Le-Dome-RDS/hope-bike/mecanic_and_wiring/V2/capteur_roue/bicycle+wheel+magnet+valve+cap+for+cycle+computer+sensor/images/IMG_20170719_185834156_-_copia.jpg

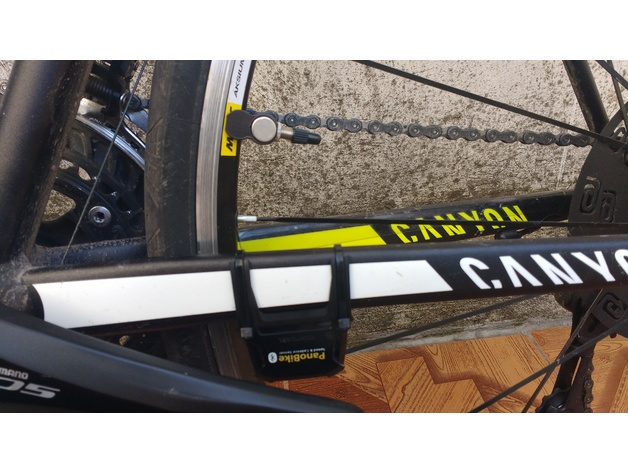
mecanic_and_wiring/V2/capteur_roue/bicycle+wheel+magnet+valve+cap+for+cycle+computer+sensor/images/IMG_20170719_185834156_-_copia.jpg
