Le-Dome-RDS/hope-bike/README.md

# hope-bike
An open source Pedalling Assistant Sytem for 26" wheeled bikes 

Licence : CC-BY-SA
