Le-Dome-RDS/hope-bike/source_code/readme.md

#Source code for the Hope and Bike project

This folder contains the source code for the command card and the power management card. 

Details for dwownloading software are given in each cases.
