Le-Dome-RDS/hope-bike/electronic parts/readme.md

#Electronic parts

This folder contains datasheet, eagle project and schematic for the three different PCB files : 

* the button card that contains the three buttons used for the control of the speed by the user,
* the command card that contains LEDs used to visualize both the battery level and the speed assist level. It also contains the arduino board.
*  the power management card that contains all the power electronic stuff necessary to drive the brushless motor using the electrical power battery.

The datasheets for the electronical devices used in the cards and the commercial items required for the kit (battery, motor and the pedal sensor) are also avalaible
