Le-Dome-RDS/hope-bike/electronic parts/datasheet_moteur_batterie_etc/readme.md

# datasheet for motor, battery and other commercial devices needed for the Kit

pdf files are provided for the battery, the brushless motor and the pedal sensor. For the cases where the pdf files are printed version of web pages, follow the links below  : 

* Brushless motor and wheel : chinese ref. cheaper  [http://www.cccme.org.cn/products/detail-8074730.aspx](http://)

*  Brushless motor and wheel : french provider [http://www.power-e-bike.fr/](http://)
*  Pedal sensor : [http://www.power-e-bike.fr/fr/accessoires-velo-electrique/capteur-de-pedalage.html](http://)
