Le-Dome-RDS/hope-bike/electronic parts/2015.06.08_BOM_Francois_Auguste.ods

1nf céramique 0805 | 100 | 0,0122 | 1,22 € | http://fr.farnell.com/multicomp/mcsh21b102k250ct/condensateur-mlcc-x7r-1nf-25v/dp/1856454
220µF 50V CMS | 4 | 1,0200 | 4,08 € | http://fr.farnell.com/panasonic-electronic-components/eeeft1h221ap/condensateur-elec-alu-220uf-50v/dp/1868427
680µF 10V CMS | 10 | 0,8490 | 8,49 € | http://fr.farnell.com/panasonic-electronic-components/eeefp1a681ap/condensateur-elec-alu-680uf-10v/dp/1539506
10µF 50V Cms | 50 | 0,2020 | 10,10 € | http://fr.farnell.com/panasonic-electronic-components/eeefth100uar/condensateur-elec-alu-10uf-50v/dp/1868422
Diode zener 12V SOD123 | 5 | 0,1840 | 0,92 € | http://fr.farnell.com/multicomp/bzt52c12/diode-zener-0-41w-sod-123/dp/1466559
Diode BAS70-04 SOT23 | 25 | 0,0650 | 1,63 € | http://fr.farnell.com/vishay-semiconductor/bas70-04-e3-08/diode-petit-signal-70v-sot23-3/dp/2420635
Diode verste CMS 0805 | 20 | 0,0889 | 1,78 € | http://fr.farnell.com/kingbright/kpt-2012sgc/led-vert-0805-cms/dp/2099239
Résistance 100 CMS 0805 | 50 | 0,0236 | 1,18 € | http://fr.farnell.com/bourns/cr0805-jw-101elf/resistance-couche-epaisse-100r/dp/2333586
Résistance 1K CMS 0805 | 50 | 0,0653 | 3,27 € | http://fr.farnell.com/welwyn/wcr0805-1k0fi/resistance-0805-1k/dp/1099800
Résistance 2,2K CMS 0805 | 50 | 0,0236 | 1,18 € | http://fr.farnell.com/bourns/cr0805-jw-222elf/resistance-couche-epaisse-2-2k/dp/2333608
Résistance 10K CMS 0805 | 50 | 0,0229 | 1,15 € | http://fr.farnell.com/panasonic-electronic-components/erj6geyj103v/resistance-0805-10k-5-0-125w/dp/2057719
Résistance 56K CMS 0805 | 50 | 0,0243 | 1,22 € | http://fr.farnell.com/yageo-phycomp/rc0805jr-0756kl/resistance-rc11-0805-56k/dp/9234225
Résistance 82K CMS 0805 | 10 | 0,0150 | 0,15 € | http://fr.farnell.com/te-connectivity/crgh0805j82k/resistance-puissance-82k-0-33w/dp/2331821
Régulateur 5V SOT89 | 10 | 0,2180 | 2,18 € | http://fr.farnell.com/stmicroelectronics/l78l05abutr/regulateur-5v-cms/dp/1467762
Régulateur 12V SOT89 | 5 | 0,3680 | 1,84 € | http://fr.farnell.com/stmicroelectronics/l78l12acutr/ic-reg-ldo-12v-100ma-sot89/dp/1564315
Quartz 16Mhz CMS | 2 | 1,5800 | 3,16 € | http://fr.farnell.com/txc/7m-16-000maaj-t/xtal-16-000mhz-18pf-smd-3-2x2/dp/1842060
Résistance 1206 0Ohm | 50 | 0,0250 | 1,25 € | http://fr.farnell.com/vishay-draloric/crcw12060000z0ea/resistance-0r-0-25w-jumper-1206/dp/1469963
Résistance 6,8 CMS 1206 | 10 | 0,0690 | 0,69 € | http://fr.farnell.com/panasonic-electronic-components/erjt08j6r8v/resistance-anti-impulsion-1206/dp/1577462
Diode CD1206-S01575 | 10 | 0,0718 | 0,72 € | http://fr.farnell.com/bourns/cd1206-s01575/diode-commutation-100v-150ma-1206/dp/2211947
4,7µF 25V 1206 | 10 | 0,0628 | 0,63 € | http://fr.farnell.com/multicomp/mc1206f475z250ct/condensateur-mlcc5v-4-7uf-25v-1206/dp/1759452
FAN73933MX DRIVER | 3 | 1,8300 | 5,49 € | http://fr.farnell.com/fairchild-semiconductor/fan73933mx/driver-gate-half-bridge-3a-14sop/dp/2083878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
 |  |  | 52,30 €
