Le-Dome-RDS/hope-bike/electronic parts/datasheet_composants_electronique/IRF MosFET N.xls

Part | Part Status | Package | VBRDSS (V) | VGs Max (V) | Circuit | RDS(on) Max 10V (mOhms) | Qg Typ (nC) | ID @ TC = 25C (A) | Power Dissipation @ TC = 25C (W) | Rth(JC) (K/W) | Qual Level | MSL
IRF7483M | Active and Preferred | DirectFET MF | 40 | 20 | Discrete | 2.3 | 81 | 135 | 74 | 1.7 | Industrial | 1
IRFR7740 | Active and Preferred | D-PAK | 75 | 20 | Discrete | 7.2 | 84 | 87 | 140 | 1.05 | Industrial | 1
IRFU7740 | Active and Preferred | I-PAK | 75 | 20 | Discrete | 7.2 | 84 | 87 | 140 | 1.05 | Industrial
IRFB7787 | Active and Preferred | TO-220AB | 75 | 20 | Discrete | 8.4 | 73 | 76 | 125 | 1.2 | Industrial
IRFS7787 | Active and Preferred | D2-Pak | 75 | 20 | Discrete | 8.4 | 73 | 76 | 125 | 1.2 | Industrial | 1
IRFSL7787 | Active and Preferred | TO-262 | 75 | 20 | Discrete | 8.4 | 73 | 76 | 125 | 1.2 | Industrial
IRFSL7762 | Active and Preferred | TO-262 | 75 | 20 | Discrete | 6.7 | 85 | 85 | 140 | 1.05 | Industrial
IRFS7762 | Active and Preferred | D2-Pak | 75 | 20 | Discrete | 6.7 | 85 | 85 | 140 | 1.05 | Industrial | 1
IRFR7746 | Active and Preferred | D-PAK | 75 | 20 | Discrete | 11.2 | 59 | 59 | 99 | 1.52 | Industrial | 1
IRFU7746 | Active and Preferred | I-PAK | 75 | 20 | Discrete | 11.2 | 59 | 42 | 99 | 1.52 | Industrial
IRFS7734-7P | Active and Preferred | D2-Pak 7-Lead | 75 | 20 | Discrete | 3.05 | 180 | 197 | 294 | 0.51 | Industrial | 1
IRFB7740 | Active and Preferred | TO-220AB | 75 | 20 | Discrete | 7.3 | 81 | 87 | 143 | 1.05 | Industrial
IRFS7734 | Active and Preferred | D2-Pak | 75 | 20 | Discrete | 3.5 | 180 | 183 | 290 | 0.51 | Industrial | 1
IRFH7787 | Active and Preferred | PQFN 5 x 6 B/E | 75 | 20 | Discrete | 8 | 75 | 68 | 83 | 1.5 | Industrial | 1
IRFP7718 | Active and Preferred | TO-247AC | 75 | 20 | Discrete | 1.8 | 552 | 355 | 517 | 0.29 | Industrial
IRFS7730 | Active and Preferred | D2-Pak | 75 | 20 | Discrete | 2.6 | 271 | 246 | 375 | 0.4 | Industrial | 1
IRFB7730 | Active and Preferred | TO-220AB | 75 | 20 | Discrete | 2.6 | 271 | 246 | 375 | 0.4 | Industrial
IRFB7734 | Active and Preferred | TO-220AB | 75 | 20 | Discrete | 3.5 | 180 | 183 | 290 | 0.51 | Industrial
IRFS7730-7P | Active and Preferred | D2-Pak 7-Lead | 75 | 20 | Discrete | 2 | 285 | 269 | 375 | 0.4 | Industrial | 1
IRFSL7730 | Active and Preferred | TO-262 | 75 | 20 | Discrete | 2.6 | 271 | 246 | 375 | 0.4 | Industrial
IRFSL7734 | Active and Preferred | TO-262 | 75 | 20 | Discrete | 3.5 | 180 | 183 | 290 | 0.51 | Industrial
IRFB7746 | Active and Preferred | TO-220AB | 75 | 20 | Discrete | 10.6 | 55 | 59 | 99 | 1.52 | Industrial
IRFI7446GPBF | Active | TO-220 FullPak (Iso) | 40 | 20 | Discrete | 3.3 | 60 | 80 | 40.5 | 3.7 | Industrial
IRFI7440GPBF | Active | TO-220 FullPak (Iso) | 40 | 20 | Discrete | 2.5 | 88 | 95 | 42 | 3.6 | Industrial
IRFH7085 | Active and Preferred | PQFN 5 x 6 B/E | 60 | 20 | Discrete | 3.2 | 110.0 | 147 |  | 0.80 | Industrial | 1
IRF7480M | Active and Preferred | DirectFET ME | 40 | 20 | Discrete | 1.2 | 123.0 | 217 | 96 | 1.3 | Industrial | 1
IRFR7540 | Active and Preferred | D-Pak | 60 | 20 | Discrete | 4.8 | 86 | 110 | 140 | 1.05 | Industrial | 1
IRFU7546 | Active and Preferred | I-Pak | 60 | 20 | Discrete | 7.9 | 58 | 71 | 99 | 1.52 | Industrial
IRFU7540 | Active and Preferred | I-Pak | 60 | 20 | Discrete | 4.8 | 86 | 110 | 140 | 1.05 | Industrial
IRFR7546 | Active and Preferred | D-Pak | 60 | 20 | Discrete | 7.9 | 58 | 71 | 99 | 1.52 | Industrial | 1
IRFH7545 | Active and Preferred | PQFN 5 x 6 B/E | 60 | 20 | Discrete | 5.2 | 73 | 85 | 83 | 1.5 | Industrial | 1
IRF7580M | Active and Preferred | DirectFET ME | 60 | 20 | Discrete | 3.6 | 120.0 | 116 | 115 | 1.3 | Industrial | 3
IRFS7430 | Active and Preferred | D2-Pak | 40 | 20 | Discrete | 1.3 | 300.0 | 409 | 375 | 0.40 | Industrial | 1
IRFR2905Z | Active | D-Pak | 55 | 20 | Discrete | 14.5 | 29.0 | 59 | 110 | 1.38 | Industrial | 1
IRFB7545 | Active and Preferred | TO-220AB | 60 | 20 | Discrete | 5.9 | 75.0 | 95 | 125 | 1.21 | Industrial
IRFS7540 | Active and Preferred | D2-Pak | 60 | 20 | Discrete | 5.1 | 88.0 | 110 | 160 | 0.95 | Industrial | 1
IRFSL7540 | Active and Preferred | TO-262 | 60 | 20 | Discrete | 5.1 | 88.0 | 110 | 160 | 0.95 | Industrial
IRFB7546 | Active and Preferred | TO-220AB | 60 | 20 | Discrete | 7.3 | 58.0 | 53 | 99 | 1.52 | Industrial
IRFB7540 | Active and Preferred | TO-220AB | 60 | 20 | Discrete | 5.1 | 88.0 | 110 | 160 | 0.95 | Industrial
IRFP7537 | Active and Preferred | TO-247AC | 60 | 20 | Discrete | 3.3 | 142.0 | 172 | 230 | 0.66 | Industrial
IRFP7530 | Active and Preferred | TO-247 | 60 | 20 | Discrete | 2.0 | 274.0 | 281 | 341 | 0.44 | Industrial
IRFS7530-7P | Active and Preferred | D2-Pak 7-Lead | 60 | 20 | Discrete | 1.4 | 236.0 | 240 | 375 | 0.40 | Industrial | 1
IRFS7534 | Active and Preferred | D2-Pak | 60 | 20 | Discrete | 2.4 | 186.0 | 195 | 294 | 0.51 | Industrial | 1
IRFS7537 | Active and Preferred | D2-Pak | 60 | 20 | Discrete | 3.3 | 142.0 | 173 | 230 | 0.65 | Industrial | 1
IRFB7534 | Active and Preferred | TO-220AB | 60 | 20 | Discrete | 2.4 | 186.0 | 195 | 294 | 0.51 | Industrial
IRFS7534-7P | Active and Preferred | D2-Pak 7-Lead | 60 | 20 | Discrete | 1.95 | 200.0 | 240 | 290 | 0.51 | Industrial | 1
IRFSL7534 | Active and Preferred | TO-262 | 60 | 20 | Discrete | 2.4 | 186.0 | 195 | 294 | 0.51 | Industrial
IRFB7537 | Active and Preferred | TO-220AB | 60 | 20 | Discrete | 3.3 | 142.0 | 173 | 230 | 0.65 | Industrial
IRFSL7537 | Active and Preferred | TO-262 | 60 | 20 | Discrete | 3.3 | 142.0 | 173 | 230 | 0.65 | Industrial
IRFSL7530 | Active and Preferred | TO-262 | 60 | 20 | Discrete | 2.0 | 274.0 | 295 | 375 | 0.40 | Industrial
IRFS7530 | Active and Preferred | D2-Pak | 60 | 20 | Discrete | 2.0 | 274.0 | 295 | 375 | 0.40 | Industrial | 1
IRFB7530 | Active and Preferred | TO-220AB | 60 | 20 | Discrete | 2.0 | 274.0 | 295 | 375 | 0.40 | Industrial
IRFS7430-7P | Active and Preferred | D2-Pak 7-Lead | 40 | 20 | Discrete | 0.75 | 305.0 | 522 | 3.75 | 0.40 | Industrial | 1
IRFS7434 | Active and Preferred | D2-Pak | 40 | 20 | Discrete | 1.6 | 216.0 | 320 | 294 | 0.50 | Industrial | 1
IRFSL7434 | Active and Preferred | TO-262 | 40 | 20 | Discrete | 1.6 | 216.0 | 320 | 294 | 0.50 | Industrial
IRF7478PBF-1 | Active | SO-8 | 60 | 20 | Discrete | 26.0 | 21.0 |  |  | 50 (JA) | Industrial | 1
IRFH7084 | Active and Preferred | PQFN 5 x 6 B/E | 40 | 20 | Discrete | 1.25 | 127.0 | 265 |  | 0.80 | Industrial | 1
IRFP3006 | Active and Preferred | TO-247AC | 60 | 20 | Discrete | 2.5 | 200.0 | 270 | 375 | 0.40 | Industrial
IRL1404ZS | Active and Preferred | D2-Pak | 40 | 16 | Discrete | 3.1 | 75.0 | 200 | 230 | 0.65 | Industrial | 1
IRFS7434-7P | Active and Preferred | D2-Pak 7-Lead | 40 | 20 | Discrete | 1.0 | 210.0 | 362 | 245 | 0.51 | Industrial | 1
IRFR7446 | Active and Preferred | D-Pak | 40 | 20 | Discrete | 3.9 | 65.0 | 120 | 98 | 1.52 | Industrial | 1
IRFB3407Z | Active and Preferred | TO-220AB | 75 | 20 | Discrete | 6.4 | 79.0 | 122 | 230 | 0.65 | Industrial
IRFZ46ZS | Active | D2-Pak | 55 | 20 | Discrete | 13.6 | 31.0 | 51 | 82 | 1.84 | Industrial | 1
IRF1405ZS | Active | D2-Pak | 55 | 20 | Discrete | 4.9 | 120.0 | 150 | 230 | 0.65 | Industrial | 1
IRFZ44ZS | Active | D2-Pak | 55 | 20 | Discrete | 13.9 | 29.0 | 51 | 80 | 1.87 | Industrial | 1
IRF3205ZS | Active | D2-Pak | 55 | 20 | Discrete | 6.5 | 76.0 | 110 | 170 | 0.90 | Industrial | 1
IRF2807ZS | Active | D2-Pak | 75 | 20 | Discrete | 9.4 | 71.0 | 89 | 170 | 0.90 | Industrial | 1
IRF2804S | Active and Preferred | D2-Pak | 40 | 20 | Discrete | 2.3 | 160.0 | 280 | 330 | 0.45 | Industrial | 1
IRLS3036 | Active and Preferred | D2-Pak | 60 | 16 | Discrete | 2.4 | 91.0 | 270 | 380 | 0.40 | Industrial | 1
IRFS3207 | Active | D2-Pak | 75 | 20 | Discrete | 4.5 | 180.0 | 180 | 330 | 0.45 | Industrial | 1
IRFS3307Z | Active and Preferred | D2-Pak | 75 | 20 | Discrete | 5.8 | 79.0 | 120 | 230 | 0.65 | Industrial | 1
IRF1010ZS | Active and Preferred | D2-Pak | 55 | 20 | Discrete | 7.5 | 63.0 | 94 | 140 | 1.11 | Industrial | 1
IRF3808S | Active | D2-Pak | 75 | 20 | Discrete | 7.0 | 150.0 | 105 | 200 | 0.75 | Industrial | 1
IRL1404S | Active | D2-Pak | 40 | 20 | Discrete | 4.0 | 93.3 | 160 | 3.8 | 0.75 | Industrial | 1
IRF7749L1 | Active and Preferred | DirectFET L8 | 60 | 20 | Discrete | 1.5 | 200.0 | 200 | 125 | 45 (JA) | Industrial | 1
IRF7739L1 | Active and Preferred | DirectFET L8 | 40 | 20 | Discrete | 1.0 | 220.0 | 270 | 125 | 40 (JA) | Industrial | 1
IRF7748L1 | Active and Preferred | DirectFET L6 | 60 | 20 | Discrete | 2.2 | 146.7 | 148 | 94 | 1.6 | Industrial | 1
IRFL024Z | Active | SOT-223 | 55 | 20 | Discrete | 57.5 | 9.1 |  |  | 45 (JA) | Industrial | 1
IRFH7446 | Active and Preferred | PQFN 5 x 6 B/E | 40 | 20 | Discrete | 3.3 | 65.0 | 117 | 78 | 1.6 | Industrial | 1
IRFS7440 | Active and Preferred | D2-Pak | 40 | 20 | Discrete | 2.5 | 90.0 | 208 | 208 | 0.72 | Industrial | 1
IRFSL7440 | Active and Preferred | TO-262 | 40 | 20 | Discrete | 2.5 | 90.0 | 208 | 208 | 0.72 | Industrial
IRFH7440 | Active and Preferred | PQFN 5 x 6 B/E | 40 | 20 | Discrete | 2.4 | 92.0 | 159 | 104 | 1.2 | Industrial | 1
IRFR7440 | Active and Preferred | D-Pak | 40 | 20 | Discrete | 2.4 | 89.0 | 180 | 140 | 1.05 | Industrial | 1
IRFSL7437 | Active and Preferred | TO-262 | 40 | 20 | Discrete | 1.8 | 150.0 | 250 | 230 | 0.65 | Industrial
IRFS7437 | Active and Preferred | D2-Pak | 40 | 20 | Discrete | 1.8 | 150.0 | 250 | 230 | 0.65 | Industrial | 1
IRFS7437-7P | Active and Preferred | D2-Pak 7-Lead | 40 | 20 | Discrete | 1.4 | 150.0 | 295 | 231 | 0.65 | Industrial | 1
IRLS3034-7P | Active and Preferred | D2-Pak 7-Lead | 40 | 20 | Discrete | 1.4 | 120.0 | 380 | 380 | 0.40 | Industrial | 1
IRLS3036-7P | Active and Preferred | D2-Pak 7-Lead | 60 | 16 | Discrete | 1.9 | 110.0 | 300 | 380 | 0.40 | Industrial | 1
IRFH7004 | Active and Preferred | PQFN 5 x 6 B/E | 40 | 20 | Discrete | 1.4 | 129.0 | 259 | 156 | 0.80 | Industrial | 1
IRLH7134 | Active and Preferred | PQFN 5 x 6 B/E | 40 | 16 | Discrete | 3.3 | 39.0 | 134 | 104 | 1.2 | Industrial | 1
IRFB7430 | Active and Preferred | TO-220AB | 40 | 20 | Discrete | 1.3 | 300.0 | 409 | 375 | 0.40 | Industrial
IRFSL7430 | Active and Preferred | TO-262 | 40 | 20 | Discrete | 1.3 | 300.0 | 409 | 375 | 0.40 | Industrial
IRFH7107 | Active and Preferred | PQFN 5 x 6 B/E | 75 | 20 | Discrete | 8.5 | 48.0 | 75 | 104 | 1.2 | Industrial | 1
IRFB7434 | Active and Preferred | TO-220AB | 40 | 20 | Discrete | 1.6 | 216.0 | 317 | 294 | 0.51 | Industrial
IRF7946 | Active and Preferred | DirectFET MX | 40 | 20 | Discrete | 1.4 | 141.0 | 198 | 96 | 1.3 | Consumer | 1
IRFB7440 | Active and Preferred | TO-220AB | 40 | 20 | Discrete | 2.5 | 90.0 | 208 | 208 | 0.72 | Industrial
IRFB7446 | Active and Preferred | TO-220AB | 40 | 20 | Discrete | 3.3 | 62.0 | 123 | 99 | 1.52 | Industrial
IRFP7430 | Active and Preferred | TO-247AC | 40 | 20 | Discrete | 1.3 | 300.0 | 404 | 366 | 0.41 | Industrial
IRFB7437 | Active and Preferred | TO-220AB | 40 | 20 | Discrete | 2.0 | 150.0 | 250 | 230 | 0.65 | Industrial
IRLR3114Z | Active and Preferred | D-Pak | 40 | 16 | Discrete | 4.5 | 40.0 | 130 | 140 | 1.05 | Industrial | 1
IRFB3256 | Active and Preferred | TO-220AB | 60 | 20 | Discrete | 3.4 | 130.0 | 206 | 300 | 0.50 | Industrial
IRFU2405 | Active | I-Pak | 55 | 20 | Discrete | 16 | 70 | 40 | 110 | 1.4 | Industrial
IRFZ46NL | Active | TO-262 | 55 | 20 | Discrete | 16.5 | 48 | 37 | 120 | 1.3 | Industrial
IRFU3607 | Active | I-Pak | 75 | 20 | Discrete | 9 | 56 | 56 | 140 | 1.05 | Industrial
IRFU7440 | Active and Preferred | I-Pak | 40 | 20 | Discrete | 2.4 | 89 | 125 | 140 | 1.05 | Industrial
IRF3205L | Active | TO-262 | 55 | 20 | Discrete | 8 | 97.3 | 80 | 200 | 0.75 | Industrial
IRFZ34N | Active | TO-220AB | 55 | 20 | Discrete | 40 | 22.7 | 18 | 56 | 2.7 | Industrial
IRFU1018E | Active | I-Pak | 60 | 20 | Discrete | 8.4 | 46 | 56 | 110 | 1.32 | Industrial
IRLU3705Z | Active and Preferred | I-Pak | 55 | 16 | Discrete | 8 | 44 | 63 | 130 | 1.14 | Industrial
IRFZ44NL | Active | TO-262 | 55 | 20 | Discrete | 17.5 | 42 | 35 | 110 | 1.4 | Industrial
IRLU024N | Active | I-Pak | 55 | 16 | Discrete | 65 | 10 | 11 | 38 | 3.3 | Industrial
IRLU2905 | Active | I-Pak | 55 | 16 | Discrete | 27 | 32 | 23 | 69 | 1.8 | Industrial
IRLU3636 | Active and Preferred | I-Pak | 60 | 16 | Discrete | 6.8 | 33 | 70 | 143 | 1.05 | Industrial
IRFU3806 | Active | I-Pak | 60 | 20 | Discrete | 15.8 | 22 | 31 | 71 | 2.12 | Industrial
IRLU3915 | Active | I-Pak | 55 | 16 | Discrete | 14 | 61 | 43 | 120 | 1.3 | Industrial
IRFU48Z | Active and Preferred | I-Pak | 55 | 20 | Discrete | 11 | 40 | 44 | 91 | 1.64 | Industrial
IRLU2905Z | Active and Preferred | I-Pak | 55 | 16 | Discrete | 13.5 | 23 | 43 | 110 | 1.38 | Industrial
IRFU1205 | Active | I-Pak | 55 | 20 | Discrete | 27 | 43.3 | 23 | 69 | 1.8 | Industrial
IRFU024N | Active | I-Pak | 55 | 20 | Discrete | 75 | 13.3 | 10 | 38 | 3.3 | Industrial
IRFU4105Z | Active and Preferred | I-Pak | 55 | 20 | Discrete | 24.5 | 18 | 21 | 48 | 3.12 | Industrial
IRFH5104 | Active and Preferred | PQFN 5 x 6 B/E | 40 | 20 | Discrete | 3.5 | 53.0 | 100 | 114 | 1.1 | Industrial | 1
IRFH5204 | Active and Preferred | PQFN 5 x 6 B/E | 40 | 20 | Discrete | 4.3 | 42.0 | 100 | 105 | 1.2 | Industrial | 1
IRF1407S | Active | D2-Pak | 75 | 20 | Discrete | 7.8 | 160.0 | 100 | 200 | 0.75 | Industrial | 1
IRLML0040 | Active and Preferred | Micro 3/ SOT-23 | 40 | 16 | Discrete | 56.0 | 2.6 |  |  | 100 (JA) | Consumer | 1
IRLH5036 | Active and Preferred | PQFN 5 x 6 B/E | 60 | 16 | Discrete | 4.4 | 44.0 | 100 | 250 | 0.50 | Industrial | 1
IRFH5406 | Active and Preferred | PQFN 5 x 6 B/E | 60 | 20 | Discrete | 14.4 | 23.0 | 40 | 46 | 2.7 | Industrial | 1
IRLH5034 | Active and Preferred | PQFN 5 x 6 B/E | 40 | 16 | Discrete | 2.4 | 82.0 | 100 | 250 | 0.50 | Industrial | 1
IRFH5207 | Active and Preferred | PQFN 5 x 6 B/E | 75 | 20 | Discrete | 9.6 | 39.0 | 71 | 105 | 1.2 | Industrial | 1
IRFH5106 | Active and Preferred | PQFN 5 x 6 B/E | 60 | 20 | Discrete | 5.6 | 50.0 | 100 | 114 | 1.1 | Industrial | 1
IRFH5006 | Active and Preferred | PQFN 5 x 6 B/E | 60 | 20 | Discrete | 4.1 | 67.0 | 100 | 250 | 0.50 | Industrial | 1
IRFH5206 | Active and Preferred | PQFN 5 x 6 B/E | 60 | 20 | Discrete | 6.7 | 40.0 | 89 | 100 | 1.2 | Industrial | 1
IRFH5007 | Active and Preferred | PQFN 5 x 6 B/E | 75 | 20 | Discrete | 5.9 | 65.0 | 100 | 250 | 0.50 | Industrial | 1
IRF7478 | Active | SO-8 | 60 | 20 | Discrete | 26.0 | 21.0 |  |  | 50 (JA) | Consumer | 1
IRFH5004 | Active and Preferred | PQFN 5 x 6 B/E | 40 | 20 | Discrete | 2.6 | 73.0 |  |  | 0.50 | Industrial | 1
IRLML2060 | Active and Preferred | Micro 3/ SOT-23 | 60 | 16 | Discrete | 480.0 | 0.67 |  |  | 100 (JA) | Consumer | 1
IRLML0060 | Active and Preferred | Micro 3/ SOT-23 | 60 | 16 | Discrete | 92.0 | 2.5 |  |  | 100 (JA) | Consumer | 1
IRF7759L2 | Active and Preferred | DirectFET L8 | 75 | 20 | Discrete | 2.3 | 200.0 | 160 | 125 | 1.2 | Industrial | 1
IRF7749L2 | Active | DirectFET L8 | 60 | 20 | Discrete | 1.5 | 200.0 | 200 | 125 | 1.2 | Industrial | 1
IRF1404ZS | Active | D2-Pak | 40 | 20 | Discrete | 3.7 | 100.0 | 190 | 220 | 0.65 | Industrial | 1
IRF7739L2 | Active | DirectFET L8 | 40 | 20 | Discrete | 1.0 | 220.0 | 270 | 125 | 1.2 | Industrial | 1
IRFS3006 | Active and Preferred | D2-Pak | 60 | 20 | Discrete | 2.5 | 200.0 | 270 | 375 | 0.40 | Industrial | 1
IRFS3004-7P | Active and Preferred | D2-Pak 7-Lead | 40 | 20 | Discrete | 1.25 | 160.0 | 400 | 380 | 0.40 | Industrial | 1
IRFS3004 | Active and Preferred | D2-Pak | 40 | 20 | Discrete | 1.75 | 160.0 | 340 | 380 | 0.40 | Industrial | 1
IRFS3006-7P | Active and Preferred | D2-Pak 7-Lead | 60 | 20 | Discrete | 2.1 | 200.0 | 293 | 375 | 0.40 | Industrial | 1
IRFR1010Z | Active | D-Pak | 55 | 20 | Discrete | 7.5 | 63.0 | 91 | 140 | 1.11 | Industrial | 1
IRFR2307Z | Active and Preferred | D-Pak | 75 | 20 | Discrete | 16.0 | 50.0 | 53 | 110 | 1.42 | Industrial | 1
IRFB3004 | Active and Preferred | TO-220AB | 40 | 20 | Discrete | 1.75 | 160.0 | 340 | 380 | 0.40 | Industrial
IRFSL3004 | Active and Preferred | TO-262 | 40 | 20 | Discrete | 1.75 | 160.0 | 340 | 380 | 0.40 | Industrial
IRLR3636 | Active and Preferred | D-Pak | 60 | 16 | Discrete | 6.8 | 33.0 | 99 | 143 | 1.05 | Industrial | 1
IRLB3034 | Active and Preferred | TO-220AB | 40 | 20 | Discrete | 1.7 | 108.0 | 343 | 375 | 0.40 | Industrial
IRLS3034 | Active and Preferred | D2-Pak | 40 | 20 | Discrete | 1.7 | 108.0 | 343 | 375 | 0.40 | Industrial | 1
IRLP3034 | Active and Preferred | TO-247AC | 40 | 20 | Discrete | 1.7 | 108.0 | 327 | 341 | 0.44 | Industrial
IRLB3036 | Active and Preferred | TO-220AB | 60 | 16 | Discrete | 2.4 | 91.0 | 270 | 380 | 0.40 | Industrial
IRLSL3036 | Active and Preferred | TO-262 | 60 | 16 | Discrete | 2.4 | 91.0 | 270 | 380 | 0.40 | Industrial
IRFS3107-7P | Active and Preferred | D2-Pak 7-Lead | 75 | 20 | Discrete | 2.6 | 160.0 | 260 | 370 | 0.40 | Industrial | 1
IRFS3107 | Active and Preferred | D2-Pak | 75 | 20 | Discrete | 3.0 | 160.0 | 230 | 370 | 0.40 | Industrial | 1
IRFB3006 | Active and Preferred | TO-220AB | 60 | 20 | Discrete | 2.5 | 200.0 | 270 | 375 | 0.40 | Industrial
IRFSL3006 | Active and Preferred | TO-262 | 60 | 20 | Discrete | 2.5 | 200.0 | 270 | 375 | 0.40 | Industrial
IRF2804S-7P | Active | D2-Pak 7-Lead | 40 | 20 | Discrete | 1.6 | 170.0 | 320 | 330 | 0.50 | Industrial | 1
IRF3805S-7P | Active and Preferred | D2-Pak 7-Lead | 55 | 20 | Discrete | 2.6 | 130.0 | 240 | 300 | 0.50 | Industrial | 1
IRFP4004 | Active and Preferred | TO-247AC | 40 | 20 | Discrete | 1.7 | 220.0 | 350 | 380 | 0.40 | Industrial
IRFP4368 | Active and Preferred | TO-247AC | 75 | 20 | Discrete | 1.8 | 380.0 | 350 | 520 | 0.29 | Industrial
IRFS3306 | Active and Preferred | D2-Pak | 60 | 20 | Discrete | 4.2 | 85.0 | 160 | 230 | 0.65 | Industrial | 1
IRF6674 | Active and Preferred | DirectFET MZ | 60 | 20 | Discrete | 11.0 | 24.0 | 67 | 89 | 1.4 | Consumer | 1
IRFR1018E | Active | D-Pak | 60 | 20 | Discrete | 8.4 | 46.0 | 79 | 110 | 1.32 | Industrial | 1
IRFS3806 | Active | D2-Pak | 60 | 20 | Discrete | 15.8 | 22.0 | 43 | 71 | 2.12 | Industrial | 1
IRFP3077 | Active | TO-247AC | 75 | 20 | Discrete | 3.3 | 160.0 | 200 | 340 | 0.44 | Industrial
IRFR3607 | Active | D-Pak | 75 | 20 | Discrete | 9.0 | 56.0 | 80 | 140 | 1.05 | Industrial | 1
IRF1018ES | Active | D2-Pak | 60 | 20 | Discrete | 8.4 | 46.0 | 79 | 110 | 1.32 | Industrial | 1
IRFP3306 | Active | TO-247AC | 60 | 20 | Discrete | 4.2 | 85.0 | 160 | 220 | 0.67 | Industrial
IRFP3206 | Active | TO-247AC | 60 | 20 | Discrete | 3.0 | 120.0 | 200 | 280 | 0.54 | Industrial
IRFS3607 | Active | D2-Pak | 75 | 20 | Discrete | 9.0 | 56.0 | 80 | 140 | 1.05 | Industrial | 1
IRFR3806 | Active | D-Pak | 60 | 20 | Discrete | 15.8 | 22.0 | 43 | 71 | 2.12 | Industrial | 1
IRF1018ESL | Active | TO-262 | 60 | 20 | Discrete | 8.4 | 46.0 | 79 | 110 | 1.32 | Industrial
IRF1018E | Active | TO-220AB | 60 | 20 | Discrete | 8.4 | 46.0 | 79 | 110 | 1.32 | Industrial
IRFB3806 | Active | TO-220AB | 60 | 20 | Discrete | 15.8 | 22.0 | 43 | 71 | 2.12 | Industrial
IRFSL3806 | Active | TO-262 | 60 | 20 | Discrete | 15.8 | 22.0 | 43 | 71 | 2.12 | Industrial
IRFSL3607 | Active | TO-262 | 75 | 20 | Discrete | 9.0 | 56.0 | 80 | 140 | 1.05 | Industrial
IRFB3607 | Active | TO-220AB | 75 | 20 | Discrete | 9.0 | 56.0 | 80 | 140 | 1.05 | Industrial
IRF6614 | Active and Preferred | DirectFET ST | 40 | 20 | Discrete | 8.3 | 19.0 |  | 42 | 3.0 | Consumer | 1
IRF2805S | Active | D2-Pak | 55 | 20 | Discrete | 4.7 | 150.0 | 135 | 200 | 0.75 | Industrial | 1
IRF2907ZS | Active | D2-Pak | 75 | 20 | Discrete | 4.5 | 180.0 | 170 | 330 | 0.45 | Industrial | 1
IRF2907ZS-7P | Active and Preferred | D2-Pak 7-Lead | 75 | 20 | Discrete | 3.8 | 170.0 | 160 | 300 | 0.50 | Industrial | 1
IRLR3105 | Active | D-Pak | 55 | 16 | Discrete | 37.0 | 13.3 | 25 | 57 | 2.65 | Industrial | 1
IRF6616 | Active and Preferred | DirectFET MX | 40 | 20 | Discrete | 5.0 | 29.0 |  | 89 | 1.4 | Consumer | 1
IRFS3206 | Active and Preferred | D2-Pak | 60 | 20 | Discrete | 3.0 | 120.0 | 210 | 300 | 0.50 | Industrial | 1
IRF6648 | Active and Preferred | DirectFET MN | 60 | 20 | Discrete | 7.0 | 36.0 | 86 | 89 | 1.4 | Consumer | 1
IRFB3206 | Active and Preferred | TO-220AB | 60 | 20 | Discrete | 3.0 | 120.0 | 210 | 300 | 0.50 | Industrial
IRFB3306 | Active and Preferred | TO-220AB | 60 | 20 | Discrete | 4.2 | 85.0 | 160 | 230 | 0.65 | Industrial
IRFSL3306 | Active | TO-262 | 60 | 20 | Discrete | 4.2 | 85.0 | 160 | 230 | 0.65 | Industrial
IRFSL3206 | Active | TO-262 | 60 | 20 | Discrete | 3.0 | 120.0 | 210 | 300 | 0.50 | Industrial
IRFS3207Z | Active and Preferred | D2-Pak | 75 | 20 | Discrete | 4.1 | 120.0 | 170 | 300 | 0.50 | Industrial | 1
IRFB3207Z | Active and Preferred | TO-220AB | 75 | 20 | Discrete | 4.1 | 120.0 | 170 | 300 | 0.50 | Industrial
IRFB3307Z | Active and Preferred | TO-220AB | 75 | 20 | Discrete | 5.8 | 79.0 | 128 | 230 | 0.65 | Industrial
IRF6613 | Active and Preferred | DirectFET MT | 40 | 20 | Discrete | 3.4 | 42.0 |  | 89 | 1.4 | Consumer | 1
IRF7855 | Active and Preferred | SO-8 | 60 | 20 | Discrete | 9.4 | 26.0 |  |  | 50 (JA) | Industrial | 1
IRFB3077 | Active and Preferred | TO-220AB | 75 | 20 | Discrete | 3.3 | 160.0 | 210 | 370 | 0.40 | Industrial
IRF3805S | Active | D2-Pak | 55 | 20 | Discrete | 3.3 | 190.0 | 220 | 130 | 0.45 | Industrial | 1
IRF3805 | Active | TO-220AB | 55 | 20 | Discrete | 3.3 | 190.0 | 220 | 130 | 0.45 | Industrial
IRF2804L | Active | TO-262 | 40 | 20 | Discrete | 2.3 | 160.0 | 280 | 330 | 0.45 | Industrial
IRF2807S | Active | D2-Pak | 75 | 20 | Discrete | 13.0 | 106.7 | 82 | 200 | 0.75 | Industrial | 1
IRFR2607Z | Active and Preferred | D-Pak | 75 | 20 | Discrete | 22.0 | 34.0 | 45 | 110 | 1.38 | Industrial | 1
IRLR3705Z | Active and Preferred | D-Pak | 55 | 16 | Discrete | 8.0 | 44.0 | 89 | 130 | 1.14 | Industrial | 1
IRFR48Z | Active and Preferred | D-Pak | 55 | 20 | Discrete | 11.0 | 40.0 | 62 | 91 | 1.64 | Industrial | 1
IRLL024Z | Active | SOT-223 | 55 | 16 | Discrete | 60.0 | 7.0 |  |  | 45 (JA) | Industrial | 1
IRFZ44VZS | Active | D2-Pak | 60 | 20 | Discrete | 12.0 | 43.0 | 57 | 92 | 1.64 | Industrial | 1
IRF1405S | Active | D2-Pak | 55 | 20 | Discrete | 5.3 | 170.0 | 131 | 200 | 0.75 | Industrial | 1
IRFZ24NS | Active | D2-Pak | 55 | 20 | Discrete | 70.0 | 13.3 | 17 | 45 | 3.3 | Industrial | 1
IRF3205S | Active | D2-Pak | 55 | 20 | Discrete | 8.0 | 97.3 | 110 | 200 | 0.75 | Industrial | 1
IRF1404S | Active | D2-Pak | 40 | 20 | Discrete | 4.0 | 160.0 | 162 | 200 | 0.75 | Industrial | 1
IRFZ44NS | Active | D2-Pak | 55 | 20 | Discrete | 17.5 | 42.0 | 49 | 110 | 1.4 | Industrial | 1
IRF7470 | Active | SO-8 | 40 | 12 | Discrete | 13.0 | 29.0 |  |  | 50 (JA) | Consumer | 1
IRFR024N | Active | D-Pak | 55 | 20 | Discrete | 75.0 | 13.3 | 16 | 38 | 3.3 | Industrial | 1
IRLZ44ZS | Active | D2-Pak | 55 | 16 | Discrete | 13.5 | 24.0 | 51 | 80 | 1.87 | Industrial | 1
IRLR2705 | Active | D-Pak | 55 | 16 | Discrete | 40.0 | 16.7 | 28 | 46 | 2.7 | Industrial | 1
IRF1010NS | Active | D2-Pak | 55 | 20 | Discrete | 11.0 | 80.0 | 84 | 3.8 | 0.85 | Industrial | 1
IRL3705NS | Active | D2-Pak | 55 | 16 | Discrete | 10.0 | 65.3 | 89 | 170 | 0.90 | Industrial | 1
IRFZ34NS | Active | D2-Pak | 55 | 20 | Discrete | 40.0 | 22.7 | 29 | 68 | 2.2 | Industrial | 1
IRLR2905 | Active | D-Pak | 55 | 16 | Discrete | 27.0 | 32.0 | 36 | 69 | 1.8 | Industrial | 1
IRLL2705 | Active | SOT-223 | 55 | 16 | Discrete | 40.0 | 32.0 |  |  | 60 (JA) | Industrial | 1
IRFR2405 | Active | D-Pak | 55 | 20 | Discrete | 16.0 | 70.0 | 56 | 110 | 1.4 | Industrial | 1
IRF7468 | Active | SO-8 | 40 | 12 | Discrete | 15.5 | 23.0 | 9.0 |  | 50 (JA) | Consumer | 1
IRF7842 | Active and Preferred | SO-8 | 40 | 20 | Discrete | 5.0 | 33.0 |  |  | 50 (JA) | Consumer | 1
IRLL014N | Active | SOT-223 | 55 | 16 | Discrete | 140.0 | 9.5 | 2.0 |  | 60 (JA) | Industrial | 1
IRFR3505 | Active | D-Pak | 55 | 20 | Discrete | 13.0 | 62.0 | 71 | 140 | 1.09 | Industrial | 1
IRLZ24NS | Active | D2-Pak | 55 | 16 | Discrete | 60.0 | 10.0 | 18 | 45 | 3.3 | Industrial | 1
IRLZ44NS | Active | D2-Pak | 55 | 16 | Discrete | 22.0 | 32.0 | 47 | 110 | 1.4 | Industrial | 1
IRF7469 | Active | SO-8 | 40 | 20 | Discrete | 17.0 | 15.0 | 9.0 |  | 50 (JA) | Consumer | 1
IRFR1205 | Active | D-Pak | 55 | 20 | Discrete | 27.0 | 43.3 | 37 | 69 | 1.8 | Industrial | 1
IRLZ34NS | Active | D2-Pak | 55 | 16 | Discrete | 35.0 | 16.7 | 30 | 68 | 2.2 | Industrial | 1
IRFR2407 | Active | D-Pak | 75 | 20 | Discrete | 26.0 | 74.0 | 42 | 110 | 1.4 | Industrial | 1
IRLR024N | Active | D-Pak | 55 | 16 | Discrete | 65.0 | 10.0 | 17 | 38 | 3.3 | Industrial | 1
IRFR4105 | Active | D-Pak | 55 | 20 | Discrete | 45.0 | 22.7 | 25 | 48 | 2.7 | Industrial | 1
IRFL014N | Active | SOT-223 | 55 | 20 | Discrete | 160.0 | 7.0 |  |  | 120 (JA) | Industrial | 1
IRFZ48NS | Active | D2-Pak | 55 | 20 | Discrete | 14.0 | 54.0 | 64 | 140 | 1.1 | Industrial | 1
IRFZ46NS | Active | D2-Pak | 55 | 20 | Discrete | 16.5 | 48.0 | 53 | 120 | 1.3 | Industrial | 1
IRFZ44ES | Active | D2-Pak | 60 | 20 | Discrete | 23.0 | 40.0 | 48 | 110 | 1.4 | Industrial | 1
IRF1010ES | Active | D2-Pak | 60 | 20 | Discrete | 12.0 | 86.6 | 83 | 170 | 0.90 | Industrial | 1
IRLL024N | Active | SOT-223 | 55 | 16 | Discrete | 65.0 | 10.4 |  |  | 120 (JA) | Industrial | 1
IRFL024N | Active | SOT-223 | 55 | 20 | Discrete | 75.0 | 12.2 | 4.0 |  | 60 (JA) | Industrial | 1
IRL2505S | Active | D2-Pak | 55 | 16 | Discrete | 8.0 | 86.7 | 104 | 200 | 0.75 | Industrial | 1
IRFL4105 | Active | SOT-223 | 55 | 20 | Discrete | 45.0 | 23.0 |  |  | 60 (JA) | Industrial | 1
IRL1004S | Active | D2-Pak | 40 | 16 | Discrete | 6.5 | 66.7 | 110 | 150 | 1.00 | Industrial | 1
IRLR2905Z | Active and Preferred | D-Pak | 55 | 16 | Discrete | 13.5 | 23.0 | 60 | 110 | 1.38 | Industrial | 1
IRFR4105Z | Active and Preferred | D-Pak | 55 | 20 | Discrete | 24.5 | 18.0 | 30 | 48 | 3.12 | Industrial | 1
IRFR4104 | Active | D-Pak | 40 | 20 | Discrete | 5.5 | 59.0 | 119 | 140 | 1.05 | Industrial | 1
IRFB3307 | Active | TO-220AB | 75 | 20 | Discrete | 6.3 | 120.0 | 130 | 250 | 0.61 | Industrial
IRFB3207 | Active | TO-220AB | 75 | 20 | Discrete | 4.5 | 180.0 | 180 | 330 | 0.45 | Industrial
IRF1404Z | Active and Preferred | TO-220AB | 40 | 20 | Discrete | 3.7 | 100.0 | 190 | 220 | 0.65 | Industrial
IRF2804 | Active and Preferred | TO-220AB | 40 | 20 | Discrete | 2.3 | 160.0 | 280 | 330 | 0.45 | Industrial
IRF2907Z | Active | TO-220AB | 75 | 20 | Discrete | 4.5 | 180.0 | 170 | 330 | 0.45 | Industrial
IRL1404Z | Active and Preferred | TO-220AB | 40 | 16 | Discrete | 3.1 | 75.0 | 200 | 230 | 0.65 | Industrial
IRFBA1404P | Active | Super 220 (TO-273AA) | 40 | 20 | Discrete | 3.7 | 160.0 | 206 | 300 | 0.50 | Industrial
IRFBA1405P | Active | Super 220 (TO-273AA) | 55 | 20 | Discrete | 5.0 | 170.0 | 174 | 330 | 0.45 | Industrial
IRF3305 | Active | TO-220AB | 55 | 20 | Discrete | 8.0 | 100.0 | 140 | 330 | 0.45 | Industrial
IRF4104S | Active | D2-Pak | 40 | 20 | Discrete | 5.5 | 68.0 | 120 | 140 | 1.05 | Industrial | 1
IRF1010EZS | Active | D2-Pak | 60 | 20 | Discrete | 8.5 | 58.0 | 84 | 140 | 1.11 | Industrial | 1
IRF3007S | Active | D2-Pak | 75 | 20 | Discrete | 12.6 | 89.0 | 62 | 120 | 1.25 | Industrial | 1
IRF1405Z | Active | TO-220AB | 55 | 20 | Discrete | 4.9 | 120.0 | 150 | 230 | 0.65 | Industrial
IRF3007 | Active | TO-220AB | 75 | 20 | Discrete | 12.6 | 89.0 | 80 | 200 | 0.74 | Industrial
IRL2505 | Active | TO-220AB | 55 | 16 | Discrete | 8.0 | 86.7 | 104 | 200 | 0.75 | Industrial
IRL1404 | Active | TO-220AB | 40 | 20 | Discrete | 4.0 | 93.3 | 160 | 200 | 0.75 | Industrial
IRL3705ZS | Active | D2-Pak | 55 | 16 | Discrete | 8.0 | 40.0 | 86 | 130 | 1.14 | Industrial | 1
IRFZ48VS | Active | D2-Pak | 60 | 20 | Discrete | 12.0 | 73.3 | 72 | 150 | 1.00 | Industrial | 1
IRF1104L | Active | TO-262 | 40 | 20 | Discrete | 9.0 | 62.0 | 100 | 170 | 0.90 | Industrial
IRFZ44EL | Active | TO-262 | 60 | 20 | Discrete | 23.0 | 40.0 | 48 | 110 | 1.4 | Industrial
IRL3705Z | Active | TO-220AB | 55 | 16 | Discrete | 8.0 | 40.0 | 86 | 130 | 1.14 | Industrial
IRL3705ZL | Active | TO-262 | 55 | 16 | Discrete | 8.0 | 40.0 | 86 | 130 | 1.14 | Industrial
IRFZ48ZS | Active and Preferred | D2-Pak | 55 | 20 | Discrete | 11.0 | 43.0 | 61 | 91 | 1.64 | Industrial | 1
IRFP1405 | Active | TO-247AC | 55 | 20 | Discrete | 5.3 | 120.0 | 160 | 310 | 0.49 | Industrial
IRFZ46Z | Active | TO-220AB | 55 | 20 | Discrete | 13.6 | 31.0 | 51 | 82 | 1.84 | Industrial
IRFP2907Z | Active and Preferred | TO-247AC | 75 | 20 | Discrete | 4.5 | 180.0 | 170 | 310 | 0.49 | Industrial
IRF2805 | Active | TO-220AB | 55 | 20 | Discrete | 4.7 | 150.0 | 175 | 330 | 0.45 | Industrial
IRF2204 | Active | TO-220AB | 40 | 20 | Discrete | 3.6 | 130.0 | 210 | 330 | 0.45 | Industrial
IRF1607 | Active | TO-220AB | 75 | 20 | Discrete | 7.5 | 210.0 | 142 | 380 | 0.40 | Industrial
IRF1407 | Active | TO-220AB | 75 | 20 | Discrete | 7.8 | 160.0 | 130 | 330 | 0.45 | Industrial
IRLIZ34N | Active | TO-220 FullPak (Iso) | 55 | 16 | Discrete | 35.0 | 16.7 | 20 | 31 | 4.1 | Industrial
IRF4104 | Active and Preferred | TO-220AB | 40 | 20 | Discrete | 5.5 | 68.0 | 120 | 140 | 1.05 | Industrial
IRF2807Z | Active | TO-220AB | 75 | 20 | Discrete | 9.4 | 71.0 | 89 | 170 | 0.90 | Industrial
IRF2204S | Active | D2-Pak | 40 | 20 | Discrete | 3.6 | 130.0 | 170 | 200 | 0.75 | Industrial | 1
IRF1010EZ | Active | TO-220AB | 60 | 20 | Discrete | 8.5 | 58.0 | 84 | 140 | 1.11 | Industrial
IRFI1010N | Active | TO-220 FullPak (Iso) | 55 | 20 | Discrete | 12.0 | 86.7 | 44 | 47 | 2.6 | Industrial
IRLI3705N | Active | TO-220 FullPak (Iso) | 55 | 16 | Discrete | 10.0 | 65.3 | 47 | 47 | 2.6 | Industrial
IRF1010Z | Active and Preferred | TO-220AB | 55 | 20 | Discrete | 7.5 | 63.0 | 94 | 140 | 1.11 | Industrial
IRFP048N | Active | TO-247AC | 55 | 20 | Discrete | 16.0 | 59.3 | 62 | 130 | 1.2 | Industrial
IRFP054N | Active | TO-247AC | 55 | 20 | Discrete | 12.0 | 86.7 | 72 | 130 | 1.2 | Industrial
IRL1004 | Active | TO-220AB | 40 | 16 | Discrete | 6.5 | 66.7 | 130 | 200 | 0.75 | Industrial
IRFP044N | Active | TO-247AC | 55 | 20 | Discrete | 20.0 | 40.7 | 49 | 100 | 1.5 | Industrial
IRFZ44Z | Active | TO-220AB | 55 | 20 | Discrete | 13.9 | 29.0 | 51 | 80 | 1.87 | Industrial
IRFZ44ZL | Active | TO-262 | 55 | 20 | Discrete | 13.9 | 29.0 | 51 | 80 | 1.87 | Industrial
IRLR3915 | Active | D-Pak | 55 | 16 | Discrete | 14.0 | 61.0 | 61 | 120 | 1.3 | Industrial | 1
IRF1404L | Active | TO-262 | 40 | 20 | Discrete | 4.0 | 160.0 | 162 | 200 | 0.75 | Industrial
IRF3205ZL | Active | TO-262 | 55 | 20 | Discrete | 6.5 | 76.0 | 110 | 170 | 0.90 | Industrial
IRFP2907 | Active | TO-247AC | 75 | 20 | Discrete | 4.5 | 410.0 | 209 | 330 | 0.45 | Industrial
IRFI3205 | Active | TO-220 FullPak (Iso) | 55 | 20 | Discrete | 8.0 | 113.3 | 56 | 48 | 2.4 | Industrial
IRFZ24N | Active | TO-220AB | 55 | 20 | Discrete | 70.0 | 13.3 | 17 | 45 | 3.3 | Industrial
IRFZ48N | Active | TO-220AB | 55 | 20 | Discrete | 14.0 | 54.0 | 64 | 94 | 1.6 | Industrial
IRFZ48V | Active | TO-220AB | 60 | 20 | Discrete | 12.0 | 73.3 | 72 | 150 | 1.00 | Industrial
IRFP064N | Active | TO-247AC | 55 | 20 | Discrete | 8.0 | 113.3 | 98 | 150 | 1.00 | Industrial
IRLZ24N | Active | TO-220AB | 55 | 16 | Discrete | 60.0 | 10.0 | 18 | 45 | 3.3 | Industrial
IRF1404 | Active | TO-220AB | 40 | 20 | Discrete | 4.0 | 160.0 | 162 | 200 | 0.75 | Industrial
IRF2807 | Active | TO-220AB | 75 | 20 | Discrete | 13.0 | 106.7 | 82 | 200 | 0.75 | Industrial
IRF3808 | Active | TO-220AB | 75 | 20 | Discrete | 7.0 | 150.0 | 140 | 330 | 0.45 | Industrial
IRF1010N | Active | TO-220AB | 55 | 20 | Discrete | 11.0 | 80.0 | 72 | 130 | 1.2 | Industrial
IRF1405 | Active | TO-220AB | 55 | 20 | Discrete | 5.3 | 170.0 | 133 | 200 | 0.45 | Industrial
IRF1104 | Active | TO-220AB | 40 | 20 | Discrete | 9.0 | 62.0 | 100 | 170 | 0.90 | Industrial
IRFZ46N | Active | TO-220AB | 55 | 20 | Discrete | 16.5 | 48.0 | 46 | 88 | 1.7 | Industrial
IRL3705N | Active | TO-220AB | 55 | 16 | Discrete | 10.0 | 65.3 | 77 | 130 | 1.2 | Industrial
IRF3205Z | Active | TO-220AB | 55 | 20 | Discrete | 6.5 | 76.0 | 110 | 170 | 0.90 | Industrial
IRFZ44V | Active | TO-220AB | 60 | 20 | Discrete | 16.5 | 44.7 | 55 | 115 | 1.3 | Industrial
IRLZ34N | Active | TO-220AB | 55 | 16 | Discrete | 35.0 | 16.7 | 27 | 56 | 2.7 | Industrial
IRLZ44N | Active | TO-220AB | 55 | 16 | Discrete | 22.0 | 32.0 | 41 | 83 | 1.8 | Industrial
IRFZ44VZ | Active | TO-220AB | 60 | 20 | Discrete | 12.0 | 43.0 | 57 | 92 | 1.64 | Industrial
IRFIZ44N | Active | TO-220 FullPak (Iso) | 55 | 20 | Discrete | 24.0 | 43.3 | 28 | 38 | 3.3 | Industrial
IRFZ44E | Active | TO-220AB | 60 | 20 | Discrete | 23.0 | 40.0 | 48 | 110 | 1.4 | Industrial
IRFIZ48N | Active | TO-220 FullPak (Iso) | 55 | 20 | Discrete | 16.0 | 59.3 | 36 | 42 | 3.6 | Industrial
IRFIZ34N | Active | TO-220 FullPak (Iso) | 55 | 20 | Discrete | 40.0 | 22.7 | 19 | 31 | 4.1 | Industrial
IRFZ44N | Active | TO-220AB | 55 | 20 | Discrete | 17.5 | 42.0 | 41 | 83 | 1.8 | Industrial
IRF3205 | Active | TO-220AB | 55 | 20 | Discrete | 8.0 | 97.3 | 98 | 150 | 1.00 | Industrial
IRFIZ24N | Active | TO-220 FullPak (Iso) | 55 | 20 | Discrete | 70.0 | 13.3 | 13 | 26 | 5.2 | Industrial
IRFY044 | Active | TO-257AA | 60 | 20 | Discrete | 40.0 | 58.7 | 16 |  | 1.25
