Le-Dome-RDS/hope-bike/electronic parts/datasheet_composants_electronique/IRF MosFET P.xls

Part | Part Status | Package | VBRDSS (V) | VGs Max (V) | Circuit | RDS(on) Max 10V (mOhms) | RDS(on) Max 4.5V (mOhms) | Qg Typ (nC) | ID @ TC = 25C (A) | Power Dissipation @ TC = 25C (W) | Rth(JC) (K/W) | Qual Level | MSL
IRF9310PBF-1 | Active | SO-8 | -30 | 20 | Discrete | 4.6 | 6.8 | 110 |  |  | 50 (JA) | Industrial | 1
IRF7420PBF-1 | Active | SO-8 | -12 | 8 | Discrete |  | 14.0 | 38 |  |  | 50 (JA) | Industrial | 1
IRF7424PBF-1 | Active | SO-8 | -30 | 20 | Discrete | 13.5 | 22.0 | 75 |  |  | 50 (JA) | Industrial | 1
IRF7205PBF-1 | Active | SO-8 | -30 | 20 | Discrete | 70.0 | 130.0 | 27 |  |  | 50 (JA) | Industrial | 1
IRF6216PBF-1 | Active | SO-8 | -150 | 20 | Discrete | 240.0 |  | 33 |  |  | 50 (JA) | Industrial | 1
IRLMS6702PBF-1 | Active | TSOP-6 (Micro 6) | -20 | 12 | Discrete |  | 200.0 | 5.8 |  |  | 75 (JA) | Industrial | 1
IRF6217PBF-1 | Active | SO-8 | -150 | 20 | Discrete | 2400.0 |  | 6 |  |  | 50 (JA) | Industrial | 1
IRLML2246TRPBF-1 | Active | Micro 3/ SOT-23 | -20 | 12 | Discrete |  | 135.0 | 2.9 |  |  | 100 (JA) | Industrial | 1
IRLML6402TRPBF-1 | Active | Micro 3/ SOT-23 | -20 | 12 | Discrete |  | 65.0 | 8.0 |  |  | 75 (JA) | Industrial | 1
IRLML6401TRPBF-1 | Active | Micro 3/ SOT-23 | -12 | 8 | Discrete |  | 50.0 | 10.0 |  |  | 75 (JA) | Industrial | 1
IRLML5203TRPBF-1 | Active | Micro 3/ SOT-23 | -30 | 20 | Discrete | 98.0 | 165.0 | 9.5 |  |  | 100 (JA) | Industrial | 1
IRLML6302TRPBF-1 | Active | Micro 3/ SOT-23 | -20 | 12 | Discrete |  | 600.0 | 2.4 |  |  | 230 (JA) | Industrial | 1
IRLML5103TRPBF-1 | Active | Micro 3/ SOT-23 | -30 | 20 | Discrete | 600.0 | 1000.0 | 3.4 |  |  | 230 (JA) | Industrial | 1
IRF7410PBF-1 | Active | SO-8 | -12 | 8 | Discrete |  | 7.0 | 91.0 |  |  | 50 (JA) | Industrial | 1
IRF7425PBF-1 | Active | SO-8 | -20 | 12 | Discrete |  | 8.2 | 87.0 |  |  | 50 (JA) | Industrial | 1
IRF7416PBF-1 | Active | SO-8 | -30 | 20 | Discrete | 20.0 | 35.0 | 61.0 |  |  | 50 (JA) | Industrial | 1
IRF7404PBF-1 | Active | SO-8 | -20 | 12 | Discrete |  | 40.0 | 32.7 |  |  | 50 (JA) | Industrial | 1
IRF7406PBF-1 | Active | SO-8 | -30 | 20 | Discrete | 45.0 | 70.0 | 39.3 |  |  | 50 (JA) | Industrial | 1
IRFHM9391 | Active and Preferred | PQFN 3.3 x 3.3 | -30 | 25 | Discrete | 14.6 | 22.5 | 32.0 | -38 | 33 | 3.8 | Consumer | 1
IRF9540NS | Active | D2-Pak | -100 | 20 | Discrete | 117.0 |  | 64.7 | -23 | 3.8 | 1.1 | Industrial | 1
IRF4905S | Active | D2-Pak | -55 | 20 | Discrete | 20.0 |  | 120.0 | -74 | 170 | 0.75 | Industrial | 1
IRF5210S | Active | D2-Pak | -100 | 20 | Discrete | 60.0 |  | 120.0 | -40 | 170 | 0.75 | Industrial | 1
IRFH9310 | Active and Preferred | PQFN 5 x 6 A | -30 | 20 | Discrete | 4.6 | 7.1 | 58.0 | -40 |  | 1.6 | Consumer | 2
IRFTS9342 | Active and Preferred | TSOP-6 (Micro 6) | -30 | 20 | Discrete | 40.0 | 66.0 | 12.0 |  |  | 62.5 (JA) | Consumer | 1
IRLTS2242 | Active and Preferred | TSOP-6 (Micro 6) | -20 | 12 | Discrete |  | -32.0 | 12.0 |  |  | 62.5 (JA) | Consumer | 1
IRF9383M | Active and Preferred | DirectFET MX | -30 | 20 | Discrete | 2.9 | 4.8 | 130.0 |  | 113 | 1.1 | Consumer | 1
IRFU9024N | Active | I-Pak | -55 | 20 | Discrete | 175 |  | 12.7 | -8 | 38 | 3.3 | Industrial
IRFU6215 | Active | I-Pak | -150 | 20 | Discrete | 580 |  | 44 | -9 | 110 | 1.4 | Industrial
IRFU5410 | Active | I-Pak | -100 | 20 | Discrete | 205 |  | 38.7 | -8.2 | 66 | 1.9 | Industrial
IRLU9343 | Active | I-Pak | -55 | 20 | Discrete | 105 | 170 | 31 | -14 | 79 | 1.9 | Industrial
IRFU5305 | Active | I-Pak | -55 | 20 | Discrete | 65 |  | 42 | -18 | 89 | 1.4 | Industrial
IRFU9120N | Active | I-Pak | -100 | 20 | Discrete | 480 |  | 18 | -4.1 | 39 | 3.2 | Industrial
IRFU5505 | Active | I-Pak | -55 | 20 | Discrete | 110.0 |  | 21.3 | -18 | 57 | 2.2 | Industrial
IRLHS2242 | Active and Preferred | PQFN 2 x 2 | -20 | 12 | Discrete |  | 31.0 | 12.0 | -15 | 9.6 | 13 | Industrial | 1
IRLML2244 | Active and Preferred | Micro 3/ SOT-23 | -20 | 12 | Discrete |  | 54.0 | 6.9 |  |  | 100 (JA) | Consumer | 1
IRLML2246 | Active and Preferred | Micro 3/ SOT-23 | -20 | 12 | Discrete |  | 135.0 | 2.9 |  |  | 100 (JA) | Consumer | 1
IRFHS9301 | Active and Preferred | PQFN 2 x 2 | -30 | 20 | Discrete | 37.0 | 65.0 | 6.9 | -13 |  | 13 | Industrial | 1
IRFHM9331 | Active | PQFN 3 x 3 | -30 | 25 | Discrete | 14.6 |  | 16.0 | -24 |  | 6.0 | Consumer | 1
IRF9392 | Active and Preferred | SO-8 | -30 | 25 | Discrete | 17.5 |  | 14.0 |  |  | 50 (JA) | Consumer | 1
IRF9332 | Active and Preferred | SO-8 | -30 | 20 | Discrete | 17.5 | 28.1 | 14.0 |  |  | 50 (JA) | Consumer | 1
IRF9333 | Active and Preferred | SO-8 | -30 | 20 | Discrete | 19.4 | 32.5 | 14.0 |  |  | 50 (JA) | Consumer | 1
IRF9393 | Active and Preferred | SO-8 | -30 | 25 | Discrete | 19.4 |  | 14.0 |  |  | 50 (JA) | Consumer | 1
IRF9388 | Active and Preferred | SO-8 | -30 | 25 | Discrete | 11.9 |  | 18.0 |  |  | 50 (JA) | Consumer | 1
IRF9335 | Active and Preferred | SO-8 | -30 | 20 | Discrete | 59.0 | 110.0 | 4.7 |  |  | 50 (JA) | Consumer | 1
IRLML9303 | Active and Preferred | Micro 3/ SOT-23 | -30 | 20 | Discrete | 165.0 | 270.0 | 2.0 |  |  | 100 (JA) | Consumer | 1
IRF9328 | Active and Preferred | SO-8 | -30 | 20 | Discrete | 11.9 | 19.7 | 18.0 |  |  | 50 (JA) | Consumer | 1
IRLML9301 | Active and Preferred | Micro 3/ SOT-23 | -30 | 20 | Discrete | 64.0 | 103.0 | 4.8 |  |  | 100 (JA) | Consumer | 1
IRF9317 | Active and Preferred | SO-8 | -30 | 20 | Discrete | 6.6 | 10.2 | 31.0 |  |  | 50 (JA) | Consumer | 1
IRF9321 | Active and Preferred | SO-8 | -30 | 20 | Discrete | 7.2 | 11.2 | 34.0 |  |  | 50 (JA) | Consumer | 1
IRF9310 | Active and Preferred | SO-8 | -30 | 20 | Discrete | 4.6 | 6.8 | 58.0 |  |  | 50 (JA) | Consumer | 1
IRF7240 | Active | SO-8 | -40 | 20 | Discrete | 15.0 | 25.0 | 73.0 |  |  | 50 (JA) | Consumer | 1
IRF6218S | Active | D2-Pak | -150 | 20 | Discrete | 150.0 |  | 21.0 | -27 | 250 | 0.61 | Industrial | 1
IRF7526D1 | Active | Micro 8 | -30 | 20 | with Schottky | 200.0 | 400.0 | 7.5 |  |  | 100 (JA) | Consumer | 1
IRF7416Q | Active | SO-8 | -30 | 20 | Discrete | 20.0 | 35.0 | 61.0 |  |  | 50 (JA) | Automotive | 1
IRF7425 | Active | SO-8 | -20 | 12 | Discrete |  | 8.2 | 87.0 |  |  | 50 (JA) | Consumer | 1
IRF7410 | Active | SO-8 | -12 | 8 | Discrete |  | 7.0 | 91.0 |  |  | 50 (JA) | Consumer | 1
IRF9540NL | Active | TO-262 | -100 | 20 | Discrete | 117.0 |  | 64.7 | -23 | 140 | 1.1 | Industrial
IRF5210L | Active | TO-262 | -100 | 20 | Discrete | 60.0 |  | 120.0 | -40 | 200 | 0.75 | Industrial
IRF5803 | Active | TSOP-6 (Micro 6) | -40 | 20 | Discrete | 112.0 | 190.0 | 25.0 |  |  | 62.5 (JA) | Consumer | 2
IRF5806 | Active | TSOP-6 (Micro 6) | -20 | 20 | Discrete |  | 86.0 | 8.3 | -4.0 | 2.0 | 62.5 (JA) | Consumer | 2
IRF5805 | Active | TSOP-6 (Micro 6) | -30 | 20 | Discrete | 98.0 | 165.0 | 11.0 |  |  | 62.5 (JA) | Consumer | 2
IRF4905L | Active | TO-262 | -55 | 20 | Discrete | 20.0 |  | 120.0 | -74 | 200 | 0.75 | Industrial
IRF7416 | Active | SO-8 | -30 | 20 | Discrete | 20.0 | 35.0 | 61.0 |  |  | 50 (JA) | Consumer | 1
IRF7726 | Active | Micro 8 | -30 | 20 | Discrete | 26.0 | 40.0 | 46.0 |  |  | 70 (JA) | Consumer | 1
IRF6216 | Active | SO-8 | -150 | 20 | Discrete | 240.0 |  | 33.0 |  |  | 20 | Consumer | 1
IRF9Z34NS | Active | D2-Pak | -55 | 20 | Discrete | 100.0 |  | 23.3 | 19 | 68 | 2.2 | Industrial | 1
IRF9520NS | Active | D2-Pak | -100 | 20 | Discrete | 480.0 |  | 18.0 | -6.8 | 3.8 | 3.1 | Industrial | 1
IRF9Z24NS | Active | D2-Pak | -55 | 20 | Discrete | 175.0 |  | 12.7 | -12 | 45 | 3.3 | Industrial | 1
IRF5305S | Active | D2-Pak | -55 | 20 | Discrete | 60.0 |  | 42.0 | -31 | 110 | 1.4 | Industrial | 1
IRF9530NS | Active | D2-Pak | -100 | 20 | Discrete | 200.0 |  | 38.7 | -14 | 3.8 | 1.9 | Industrial | 1
IRF6215S | Active | D2-Pak | -150 | 20 | Discrete | 290.0 |  | 44.0 | -13 | 110 | 1.4 | Industrial | 1
IRF9Z34NL | Active | TO-262 | -55 | 20 | Discrete | 100.0 |  | 23.3 | -19 | 68 | 2.2 | Industrial
IRF7524D1 | Active | Micro 8 | -20 | 12 | with Schottky |  | 270.0 | 5.4 |  |  | 100 (JA) | Consumer | 1
IRF7606 | Active | Micro 8 | -30 | 20 | Discrete | 90.0 | 150.0 | 20.0 |  |  | 70 (JA) | Consumer | 1
IRLMS5703 | Active | TSOP-6 (Micro 6) | -30 | 20 | Discrete | 200.0 | 400.0 | 7.2 |  |  | 75 (JA) | Consumer | 1
IRLMS6702 | Active | TSOP-6 (Micro 6) | -20 | 12 | Discrete |  | 200.0 | 5.8 |  |  | 75 (JA) | Consumer | 1
IRFR5410 | Active | D-Pak | -100 | 20 | Discrete | 205.0 |  | 38.7 | 13 | 66 | 1.9 | Industrial | 1
IRF7420 | Active | SO-8 | -12 | 8 | Discrete |  | 14.0 | 38.0 |  |  | 50 (JA) | Consumer | 1
IRF7406 | Active | SO-8 | -30 | 20 | Discrete | 45.0 | 70.0 | 39.3 |  |  | 50 (JA) | Consumer | 1
IRF7321D2 | Active | SO-8 | -30 | 20 | with Schottky | 62.0 | 98.0 | 23.0 |  |  | 62.5 (JA) | Consumer | 1
IRFR5305 | Active | D-Pak | -55 | 20 | Discrete | 65.0 |  | 42.0 | -28 | 89 | 1.4 | Industrial | 1
IRLR9343 | Active | D-Pak | -55 | 20 | Discrete | 105.0 | 170.0 | 31.0 | -20 | 79 | 1.9 | Industrial | 1
IRF7404 | Active | SO-8 | -20 | 12 | Discrete |  | 40.0 | 33.3 |  |  | 50 (JA) | Consumer | 1
IRFR9024N | Active | D-Pak | -55 | 20 | Discrete | 175.0 |  | 12.7 | 11 | 38 | 3.3 | Industrial | 1
IRFR6215 | Active | D-Pak | -150 | 20 | Discrete | 580.0 |  | 44.0 | 13 | 110 | 1.4 | Industrial | 1
IRF7205 | Active | SO-8 | -30 | 20 | Discrete | 70.0 | 130.0 | 27.0 |  |  | 50 (JA) | Consumer | 1
IRF7424 | Active | SO-8 | -30 | 20 | Discrete | 13.5 | 22.0 | 75.0 |  |  | 50 (JA) | Consumer | 1
IRFR5505 | Active | D-Pak | -55 | 20 | Discrete | 110.0 |  | 21.3 | -18 | 57 | 2.2 | Industrial | 1
IRFR9120N | Active | D-Pak | -100 | 20 | Discrete | 480.0 |  | 18.0 | -6.5 | 39 | 3.2 | Industrial | 1
IRF7204 | Active | SO-8 | -20 | 12 | Discrete | 60.0 | 100.0 | 25.0 |  |  | 50 (JA) | Consumer | 1
IRF5803D2 | Active | SO-8 | -40 | 20 | with Schottky | 112.0 | 190.0 | 25.0 |  |  | 62.5 (JA) | Consumer | 1
SI4435DY | Active | SO-8 | -30 | 20 | Discrete | 20.0 | 35.0 | 40.0 |  |  | 50 (JA) | Consumer | 1
IRF7241 | Active | SO-8 | -40 | 20 | Discrete | 41.0 | 70.0 | 53.0 |  |  | 50 (JA) | Consumer | 1
IRF6217 | Active | SO-8 | -150 | 20 | Discrete | 2400.0 |  | 6.0 |  |  | 20 | Consumer | 1
IRF7342D2 | Active | SO-8 | -55 | 20 | with Schottky | 105.0 | 170.0 | 26.0 |  |  | 62.5 (JA) | Consumer | 1
IRLIB9343 | Active | TO-220 FullPak (Iso) | -55 | 20 | Discrete | 105.0 | 170.0 | 31.0 | -14 | 33 | 3.84 | Industrial
IRFP9140N | Active | TO-247AC | -100 | 20 | Discrete | 117.0 |  | 64.7 | -21 | 120 | 1.3 | Industrial
IRLML6402 | Active | Micro 3/ SOT-23 | -20 | 12 | Discrete |  | 65.0 | 8.0 |  |  | 100 (JA) | Consumer | 1
IRLML5203 | Active | Micro 3/ SOT-23 | -30 | 20 | Discrete | 98.0 | 165.0 | 9.5 |  |  | 100 (JA) | Consumer | 1
IRLML6401 | Active | Micro 3/ SOT-23 | -12 | 8 | Discrete |  | 50.0 | 10.0 |  |  | 100 (JA) | Consumer | 1
IRLML5103 | Active | Micro 3/ SOT-23 | -30 | 20 | Discrete | 600.0 | 1000.0 | 3.4 |  |  | 230 (JA) | Consumer | 1
IRLML6302 | Active | Micro 3/ SOT-23 | -20 | 12 | Discrete |  | 600.0 | 2.4 |  |  | 230 (JA) | Consumer | 1
IRF6218 | Active | TO-220AB | -150 | 20 | Discrete | 150.0 |  | 21.0 | -27 | 250 | 0.61 | Industrial
IRF5210 | Active | TO-220AB | -100 | 20 | Discrete | 60.0 |  | 120.0 | -40 | 200 | 0.75 | Industrial
IRF9520N | Active | TO-220AB | -100 | 20 | Discrete | 480.0 |  | 18.0 | -6.8 | 48 | 3.1 | Industrial
IRF9530N | Active | TO-220AB | -100 | 20 | Discrete | 200.0 |  | 38.7 | -14 | 79 | 1.9 | Industrial
IRF9Z34N | Active | TO-220AB | -55 | 20 | Discrete | 100.0 |  | 23.3 | -17 | 56 | 2.7 | Industrial
IRF9Z24N | Active | TO-220AB | -55 | 20 | Discrete | 175.0 |  | 12.7 | -12 | 45 | 3.3 | Industrial
IRF5305 | Active | TO-220AB | -55 | 20 | Discrete | 60.0 |  | 42.0 | -31 | 110 | 1.4 | Industrial
IRF4905 | Active | TO-220AB | -55 | 20 | Discrete | 20.0 |  | 120.0 | -74 | 200 | 0.75 | Industrial
IRF9540N | Active | TO-220AB | -100 | 20 | Discrete | 117.0 |  | 64.7 | -23 | 140 | 1.1 | Industrial
IRF6215 | Active | TO-220AB | -150 | 20 | Discrete | 290.0 |  | 44.0 | -13 | 110 | 1.4 | Industrial
IRFY9120 | Active | TO-257AA | -100 | 20 | Discrete |  |  |  | -5.3
