Le-Dome-RDS/hope-bike/electronic parts/datasheet_composants_electronique/PIC16 MCU-2014-10-12.ods

Product | Status | 5K Pricing | Program Memory Size (Kbytes) | RAM (bytes) | EEPROM / HEF | Pin count | Max. CPU Speed MHz | Internal Oscillator | # of Comparators | Operational Amplifier | Total # of A/D channels | Max A/D Resolution (bits) | Number of D/A Converters | Max D/A Resolution (bits) | Internal Voltage Reference (Bandgap) | Zero Cross detect | Slope Compensation | Max 8 Bit Digital Timers | Max 16 Bit Digital Timers | Signal Measurement Timer | Hardware Limit Timer | Max # PWM outputs (including complementary outputs) | PWM Resolutions (bits) | UART | SPI™ | I2C | Number of USB Modules | Windowed Watchdog Timer (WWDT) | CRC/Scan | Configurable Logic Cell Modules (CLC) | Complementary Waveform Generator (CWG) / Complementary Output Generator (COG) | Numerically Controlled Oscillator (NCO) | Programmable switched mode controller | Cap. Touch Channels | Segment LCD | Temp. Range Min. | Temp. Range Max. | Operation Voltage Min.(V) | Operation Voltage Max.(V) | High Voltage Capable
PIC16F505 | In Production | $0.48 | 1.5 | 72 |  | 14 | 20 | 4 MHz | 0 | 0 | 0 | 0 | 0 | 0 | No | No |  | 1 | 0 |  |  | 0 | 0 | 0 | 0 | 0 | 0 | No | No | 0 | 0 | 0 | 0 | 0 | 0 | -40 | 125 | 2 | 5.5 | No
PIC16F506 | In Production | $0.52 | 1.5 | 67 |  | 14 | 20 | 4 MHz, 8 MHz | 2 | 0 | 3 | 8 | 0 | 0 | Yes | No |  | 1 | 0 |  |  | 0 | 0 | 0 | 0 | 0 | 0 | No | NO | 0 | 0 | 0 | 0 | 3 | 0 | -40 | 125 | 2 | 5.5 | No
PIC16F54 | In Production | $0.39 | 0.75 | 25 |  | 18 | 20 | No | 0 | 0 | 0 | 0 | 0 | 0 | No | No |  | 1 | 0 |  |  | 0 | 0 | 0 | 0 | 0 | 0 | No | NO | 0 | 0 | 0 | 0 | 0 | 0 | -40 | 125 | 2 | 5.5 | No
PIC16F57 | In Production | $0.52 | 3 | 72 |  | 28 | 20 | No | 0 | 0 | 0 | 0 | 0 | 0 | No | No |  | 1 | 0 |  |  | 0 | 0 | 0 | 0 | 0 | 0 | No | NO | 0 | 0 | 0 | 0 | 0 | 0 | -40 | 125 | 2 | 5.5 | No
PIC16F59 | In Production | $0.85 | 3 | 134 |  | 40 | 20 | No | 0 | 0 | 0 | 0 | 0 | 0 | No | No |  | 1 | 0 |  |  | 0 | 0 | 0 | 0 | 0 | 0 | No | NO | 0 | 0 | 0 | 0 | 0 | 0 | -40 | 125 | 2 | 5.5 | No
PIC16F610 | In Production | $0.59 | 1.75 | 64 |  | 14 | 20 | 4 MHz, 8 MHz | 2 | 0 | 0 | 0 | 0 | 0 | Yes | No |  | 1 | 1 |  |  | 0 | 0 | 0 | 0 | 0 | 0 | No | NO | 0 | 0 | 0 | 0 | 4 | 0 | -40 | 125 | 2 | 15 | Yes
PIC16F616 | In Production | $0.69 | 3.5 | 128 |  | 14 | 20 | 4 MHz, 8 MHz | 2 | 0 | 8 | 10 | 0 | 0 | Yes | No |  | 2 | 1 |  |  | 0 | 10 | 0 | 0 | 0 | 0 | No | NO | 0 | 0 | 0 | 0 | 4 | 0 | -40 | 150 | 2 | 15 | Yes
PIC16F707 | In Production | $1.68 | 14 | 368 |  | 40 | 20 | 16 MHz | 0 | 0 | 14 | 8 | 0 | 0 | Yes | No |  | 3 | 1 |  |  | 0 | 10 | 1 | 1 | 1 | 0 | No | NO | 0 | 0 | 0 | 0 | 32 | 0 | -40 | 125 | 1.8 | 5.5 | No
PIC16F716 | In Production | $0.77 | 3.5 | 128 |  | 18 | 20 | None | 0 | 0 | 4 | 8 | 0 | 0 | No | No |  | 2 | 1 |  |  | 0 | 10 | 0 | 0 | 0 | 0 | No | No | 0 | 0 | 0 | 0 | 0 | 0 | -40 | 125 | 2 | 5.5 | No
PIC16F72 | In Production | $1.91 | 3.5 | 128 |  | 28 | 20 | No | 0 | 0 | 5 | 8 | 0 | 0 | No | No |  | 2 | 1 |  |  | 0 | 10 | 0 | 0 | 0 | 0 | No | No | 0 | 0 | 0 | 0 | 0 | 0 | -40 | 125 | 2 | 5.5 | No
PIC16F720 | In Production | $0.71 | 3.5 | 128 | HEF | 20 | 16 | 16 MHz | 0 | 0 | 12 | 8 | 0 | 0 | Yes | No |  | 2 | 1 |  |  | 0 | 10 | 0 | 1 | 1 | 0 | No | NO | 0 | 0 | 0 | 0 | 12 | 0 | -40 | 125 | 1.8 | 5.5 | No
PIC16F721 | In Production | $0.74 | 7 | 256 | HEF | 20 | 16 | 16 MHz | 0 | 0 | 12 | 8 | 0 | 0 | Yes | No |  | 2 | 1 |  |  | 0 | 10 | 1 | 1 | 1 | 0 | No | NO | 0 | 0 | 0 | 0 | 12 | 0 | -40 | 125 | 1.8 | 5.5 | No
PIC16F722 | In Production Consider: PIC16F722A | $0.95 | 3.5 | 128 |  | 28 | 20 | 16 MHz | 0 | 0 | 11 | 8 | 0 | 0 | Yes | No |  | 2 | 1 |  |  | 0 | 10 | 1 | 1 | 1 | 0 | No | NO | 0 | 0 | 0 | 0 | 8 | 0 | -40 | 125 | 1.8 | 5.5 | No
PIC16F722A | In Production | $0.78 | 3.5 | 128 |  | 28 | 20 | 16 MHz | 0 | 0 | 11 | 8 | 0 | 0 | Yes | No |  | 2 | 1 |  |  | 0 | 10 | 1 | 1 | 1 | 0 | No | NO | 0 | 0 | 0 | 0 | 8 | 0 | -40 | 125 | 1.8 | 5.5 | No
PIC16F723 | In Production Consider: PIC16F723A | $1.09 | 7 | 192 |  | 28 | 20 | 16 MHz | 0 | 0 | 11 | 8 | 0 | 0 | Yes | No |  | 2 | 1 |  |  | 0 | 10 | 1 | 1 | 1 | 0 | No | NO | 0 | 0 | 0 | 0 | 8 | 0 | -40 | 125 | 1.8 | 5.5 | No
PIC16F723A | In Production | $0.85 | 7 | 192 |  | 28 | 20 | 16 MHz | 0 | 0 | 11 | 8 | 0 | 0 | Yes | No |  | 2 | 1 |  |  | 0 | 10 | 1 | 1 | 1 | 0 | No | NO | 0 | 0 | 0 | 0 | 8 | 0 | -40 | 125 | 1.8 | 5.5 | No
PIC16F724 | In Production | $1.38 | 7 | 192 |  | 40 | 20 | 16 MHz | 0 | 0 | 14 | 8 | 0 | 0 | Yes | No |  | 2 | 1 |  |  | 0 | 10 | 1 | 1 | 1 | 0 | No | NO | 0 | 0 | 0 | 0 | 16 | 0 | -40 | 125 | 1.8 | 5.5 | No
PIC16F726 | In Production | $1.23 | 14 | 368 |  | 28 | 20 | 16 MHz | 0 | 0 | 11 | 8 | 0 | 0 | Yes | No |  | 2 | 1 |  |  | 0 | 10 | 1 | 1 | 1 | 0 | No | NO | 0 | 0 | 0 | 0 | 8 | 0 | -40 | 125 | 1.8 | 5.5 | No
PIC16F727 | In Production | $1.53 | 14 | 368 |  | 40 | 20 | 16 MHz | 0 | 0 | 14 | 8 | 0 | 0 | Yes | No |  | 2 | 1 |  |  | 0 | 10 | 1 | 1 | 1 | 0 | No | NO | 0 | 0 | 0 | 0 | 16 | 0 | -40 | 125 | 1.8 | 5.5 | No
PIC16F737 | In Production | $3.13 | 7 | 368 |  | 28 | 20 | 8 MHz | 2 | 0 | 11 | 10 | 0 | 0 | No | No |  | 2 | 1 |  |  | 0 | 10 | 1 | 1 | 1 | 0 | No | NO | 0 | 0 | 0 | 0 | 0 | 0 | -40 | 125 | 2 | 5.5 | No
PIC16F74 | In Production | $3.61 | 7 | 192 |  | 40 | 20 | No | 0 | 0 | 8 | 8 | 0 | 0 | No | No |  | 2 | 1 |  |  | 0 | 10 | 1 | 1 | 1 | 0 | No | No | 0 | 0 | 0 | 0 | 0 | 0 | -40 | 125 | 2 | 5.5 | No
PIC16F747 | In Production | $3.61 | 7 | 368 |  | 40 | 20 | 8 MHz | 2 | 0 | 14 | 10 | 0 | 0 | No | No |  | 2 | 1 |  |  | 0 | 10 | 1 | 1 | 1 | 0 | No | NO | 0 | 0 | 0 | 0 | 0 | 0 | -40 | 125 | 2 | 5.5 | No
PIC16F767 | In Production | $3.64 | 14 | 368 |  | 28 | 20 | 8 MHz | 2 | 0 | 11 | 10 | 0 | 0 | No | No |  | 2 | 1 |  |  | 0 | 10 | 1 | 1 | 1 | 0 | No | NO | 0 | 0 | 0 | 0 | 0 | 0 | -40 | 125 | 2 | 5.5 | No
PIC16F77 | In Production | $4.12 | 14 | 368 |  | 40 | 20 | No | 0 | 0 | 8 | 8 | 0 | 0 | No | No |  | 2 | 1 |  |  | 0 | 10 | 1 | 1 | 1 | 0 | No | No | 0 | 0 | 0 | 0 | 0 | 0 | -40 | 125 | 2 | 5.5 | No
PIC16F777 | In Production | $4.00 | 14 | 368 |  | 40 | 20 | 8 MHz | 2 | 0 | 14 | 10 | 0 | 0 | No | No |  | 2 | 1 |  |  | 0 | 10 | 1 | 1 | 1 | 0 | No | NO | 0 | 0 | 0 | 0 | 0 | 0 | -40 | 125 | 2 | 5.5 | No
PIC16HV540 | In Production | $1.27 | 1.5 | 25 |  | 18 | 20 | No | 0 | 0 | 0 | 0 | 0 | 0 | No | No |  | 1 | 0 |  |  | 0 | 0 | 1 | 1 | 1 | 0 | No | No | 0 | 0 | 0 | 0 | 0 | 0 | -40 | 85 | 3.5 | 15 | No
PIC16LF1902 | In Production | $0.78 | 3.5 | 128 | HEF | 28 | 20 | 16 MHz, 32 kHz | 0 | 0 | 11 | 10 | 0 | 0 | No | No |  | 1 | 1 |  |  | 0 | 0 | 0 | 0 | 0 | 0 | No | NO | 0 | 0 | 0 | 0 | 11 | 72 | -40 | 125 | 1.8 | 3.6 | No
PIC16LF1903 | In Production | $0.85 | 7 | 256 | HEF | 28 | 20 | 16 MHz, 32 kHz | 0 | 0 | 11 | 10 | 0 | 0 | No | No |  | 1 | 1 |  |  | 0 | 0 | 0 | 0 | 0 | 0 | No | NO | 0 | 0 | 0 | 0 | 11 | 72 | -40 | 125 | 1.8 | 3.6 | No
PIC16LF1904 | In Production | $1.18 | 7 | 256 | HEF | 40 | 20 | 16 MHz, 32 kHz | 0 | 0 | 14 | 10 | 0 | 0 | No | No |  | 1 | 1 |  |  | 0 | 0 | 1 | 0 | 0 | 0 | No | NO | 0 | 0 | 0 | 0 | 14 | 116 | -40 | 125 | 1.8 | 3.6 | No
PIC16LF1906 | In Production | $0.91 | 14 | 512 | HEF | 28 | 20 | 16 MHz, 32 kHz | 0 | 0 | 11 | 10 | 0 | 0 | No | No |  | 1 | 1 |  |  | 0 | 0 | 1 | 0 | 0 | 0 | No | NO | 0 | 0 | 0 | 0 | 11 | 72 | -40 | 125 | 1.8 | 3.6 | No
PIC16LF1907 | In Production | $1.23 | 14 | 512 | HEF | 40 | 20 | 16 MHz, 32 kHz | 0 | 0 | 14 | 10 | 0 | 0 | No | No |  | 1 | 1 |  |  | 0 | 0 | 1 | 0 | 0 | 0 | No | NO | 0 | 0 | 0 | 0 | 14 | 116 | -40 | 125 | 1.8 | 3.6 | No
PIC16F1454 | In Production | $0.87 | 14 | 1024 | HEF | 14 | 48 | None | 0 | 0 | 0 | 0 | 0 | 0 | No | No | No | 1 | 1 |  |  | 2 | 0 | 1 | 1 | 1 | 1 | No | No | 0 | 0 | 0 | 0 | 0 | 0 | -40 | 125 | 1.8 | 5.5 | No
PIC16F1455 | In Production | $0.98 | 14 | 1024 | HEF | 14 | 48 | None | 2 | 0 | 5 | 10 | 1 | 5 | Yes | No | No | 2 | 1 |  |  | 3 | 10 | 1 | 1 | 1 | 1 | No | No | 0 | 1 | 0 | 0 | 5 | 0 | -40 | 125 | 1.8 | 5.5 | No
PIC16F1459 | In Production | $1.18 | 14 | 1024 | HEF | 20 | 48 | None | 2 | 0 | 9 | 10 | 1 | 5 | Yes | No | No | 2 | 1 |  |  | 3 | 10 | 1 | 1 | 1 | 1 | No | No | 0 | 1 | 0 | 0 | 9 | 0 | -40 | 125 | 1.8 | 5.5 | No
PIC16F1503 | In Production | $0.54 | 3.5 | 128 | HEF | 14 | 20 | 16 MHz, 32 kHz | 2 | 0 | 8 | 10 | 1 | 5 | Yes | No | No | 2 | 1 |  |  | 5 | 10 | 0 | 1 | 1 | 0 | No | No | 2 | 1 | 1 | 0 | 8 | 0 | -40 | 125 | 1.8 | 5.5 | No
PIC16F1507 | In Production | $0.68 | 3.5 | 128 | HEF | 20 | 20 | 16 MHz, 32 kHz | 0 | 0 | 12 | 10 | 1 | 5 | Yes | No | No | 2 | 1 |  |  | 5 | 10 | 0 | 0 | 0 | 0 | No | No | 2 | 1 | 1 | 0 | 12 | 0 | -40 | 125 | 1.8 | 5.5 | No
PIC16F1508 | In Production | $0.76 | 7 | 256 | HEF | 20 | 20 | 16 MHz, 32 kHz | 2 | 0 | 12 | 10 | 1 | 5 | Yes | No | No | 2 | 1 |  |  | 5 | 10 | 1 | 1 | 1 | 0 | No | No | 4 | 1 | 1 | 0 | 12 | 0 | -40 | 125 | 1.8 | 5.5 | No
PIC16F1509 | In Production | $0.80 | 14 | 512 | HEF | 20 | 20 | 16 MHz, 32 kHz | 2 | 0 | 12 | 10 | 1 | 5 | Yes | No | No | 2 | 1 |  |  | 5 | 10 | 1 | 1 | 1 | 0 | No | No | 4 | 1 | 1 | 0 | 12 | 0 | -40 | 125 | 1.8 | 5.5 | No
PIC16F1516 | In Production | $0.95 | 14 | 512 | HEF | 28 | 20 | 16 MHz, 32 kHz | 0 | 0 | 17 | 10 | 0 | 0 | Yes | No | No | 2 | 1 |  |  | 0 | 0 | 1 | 1 | 1 | 0 | No | No | 0 | 0 | 0 | 0 | 17 | 0 | -40 | 125 | 1.8 | 5.5 | No
PIC16F1517 | In Production | $1.32 | 14 | 512 | HEF | 40 | 20 | 16 MHz, 32 kHz | 0 | 0 | 28 | 10 | 0 | 0 | Yes | No | No | 2 | 1 |  |  | 0 | 0 | 1 | 1 | 1 | 0 | No | No | 0 | 0 | 0 | 0 | 28 | 0 | -40 | 125 | 1.8 | 5.5 | No
PIC16F1518 | In Production | $1.01 | 28 | 1024 | HEF | 28 | 20 | 16 MHz, 32 kHz | 0 | 0 | 17 | 10 | 0 | 0 | Yes | No | No | 2 | 1 |  |  | 0 | 0 | 1 | 1 | 1 | 0 | No | No | 0 | 0 | 0 | 0 | 17 | 0 | -40 | 125 | 1.8 | 5.5 | No
PIC16F1519 | In Production | $1.37 | 28 | 1024 | HEF | 40 | 20 | 16 MHz, 32 kHz | 0 | 0 | 28 | 10 | 0 | 0 | Yes | No | No | 2 | 1 |  |  | 0 | 0 | 1 | 1 | 1 | 0 | No | No | 0 | 0 | 0 | 0 | 28 | 0 | -40 | 125 | 1.8 | 5.5 | No
PIC16F1526 | In Production | $1.47 | 14 | 768 | HEF | 64 | 20 | 16 MHz, 32 kHz | 0 | 0 | 30 | 10 | 0 | 0 | Yes | No | No | 6 | 3 |  |  | 0 | 0 | 2 | 2 | 2 | 0 | No | No | 0 | 0 | 0 | 0 | 30 | 0 | -40 | 125 | 1.8 | 5.5 | No
PIC16F1527 | In Production | $1.54 | 28 | 1536 | HEF | 64 | 20 | 16 MHz, 32 kHz | 0 | 0 | 30 | 10 | 0 | 0 | Yes | No | No | 6 | 3 |  |  | 0 | 0 | 2 | 2 | 2 | 0 | No | No | 0 | 0 | 0 | 0 | 30 | 0 | -40 | 125 | 1.8 | 5.5 | No
PIC16F1574 | Future Product | Call for pricing | 7 | 512 | HEF | 14 | 32 | 32 MHz, 32 kHz | 2 | 0 | 8 | 10 | 1 | 5 | Yes | No | No | 2 | 5 | 0 | 0 | 5 | 16 | 1 | 0 | 0 | 0 | No | No | 0 | 1 | 0 | 0 | 4 | 0 | -40 | 125 | 1.8 | 5.5 | No
PIC16F1575 | Future Product | Call for pricing | 14 | 1024 | HEF | 14 | 32 | 32 MHz, 32 kHz | 2 | 0 | 8 | 10 | 1 | 5 | Yes | No | No | 2 | 5 | 0 | 0 | 5 | 16 | 1 | 0 | 0 | 0 | No | No | 0 | 1 | 0 | 0 | 4 | 0 | -40 | 125 | 1.8 | 5.5 | No
PIC16F1578 | Future Product | Call for pricing | 7 | 512 | HEF | 14 | 32 | 32 MHz, 32 kHz | 2 | 0 | 12 | 10 | 1 | 5 | Yes | No | No | 2 | 5 | 0 | 0 | 5 | 16 | 1 | 0 | 0 | 0 | No | No | 0 | 1 | 0 | 0 | 4 | 0 | -40 | 125 | 1.8 | 5.5 | No
PIC16F1579 | Future Product | Call for pricing | 14 | 1024 | HEF | 14 | 32 | 16 MHz | 2 | 0 | 12 | 10 | 1 | 5 | Yes | No | No | 2 | 5 | 0 | 0 | 5 | 16 | 1 | 0 | 0 | 0 | No | No | 0 | 1 | 0 | 0 | 4 | 0 | -40 | 125 | 1.8 | 5.5 | No
PIC16F73 | In Production | $2.97 | 7 | 192 |  | 28 | 20 | None | 0 | 0 | 5 | 8 | 0 | 0 | No | No | No | 2 | 1 | 0 | 0 | 0 | 10 | 1 | 1 | 1 | 0 | No | No | 0 | 0 | 0 | 0 | 0 | 0 | -40 | 125 | 2 | 5.5 | No
PIC16F76 | In Production | $3.73 | 14 | 368 |  | 28 | 20 | None | 0 | 0 | 5 | 8 | 0 | 0 | No | No | No | 2 | 1 | 0 | 0 | 0 | 10 | 1 | 1 | 1 | 0 | No | No | 0 | 0 | 0 | 0 | 0 | 0 | -40 | 125 | 2 | 5.5 | No
PIC16F1703 | In Production | $0.62 | 3.5 | 256 | HEF | 14 | 32 | 16 MHz | 0 | 2 | 8 | 10 | 0 | 0 | No | Yes | No | 2 | 1 |  |  | 0 | 0 | 0 | 1 | 1 | 0 | No | No | 0 | 0 | 0 | 0 | 8 | 0 | -40 | 125 | 1.8 | 5.5 | No
PIC16F1704 | In Production | $0.67 | 7 | 512 |  | 14 | 32 | 16 MHz | 2 | 2 | 8 | 10 | 1 | 8 | No | Yes | No | 4 | 1 |  |  | 0 | 10 | 1 | 1 | 1 | 0 | No | No | 3 | 1 | 0 | 0 | 12 | 0 | -40 | 125 | 1.8 | 5.5 | No
PIC16F1705 | In Production | $0.73 | 14 | 1024 | HEF | 14 | 32 | 16 MHz | 2 | 2 | 8 | 10 | 1 | 8 | No | Yes | No | 4 | 1 |  |  | 0 | 10 | 1 | 1 | 1 | 0 | No | No | 3 | 1 | 0 | 0 | 12 | 0 | -40 | 125 | 1.8 | 5.5 | No
PIC16F1707 | In Production | $0.77 | 3.75 | 256 | HEF | 20 | 32 | 16 MHz | 0 | 2 | 8 | 10 | 0 | 0 | No | Yes | No | 2 | 1 |  |  | 0 | 0 | 0 | 1 | 1 | 0 | No | No | 0 | 0 | 0 | 0 | 12 | 0 | -40 | 125 | 1.8 | 5.5 | No
PIC16F1708 | In Production | $0.83 | 7 | 512 | HEF | 20 | 32 | 16 MHz | 2 | 2 | 12 | 10 | 1 | 8 | No | Yes | No | 4 | 1 |  |  | 0 | 10 | 1 | 1 | 1 | 0 | No | No | 3 | 1 | 0 | 0 | 12 | 0 | -40 | 125 | 1.8 | 5.5 | No
PIC16F1709 | In Production | $0.88 | 14 | 1024 | HEF | 20 | 32 | 16 MHz | 2 | 2 | 12 | 10 | 1 | 8 | No | Yes | No | 4 | 1 |  |  | 0 | 10 | 1 | 1 | 1 | 0 | No | No | 3 | 1 | 0 | 0 | 12 | 0 | -40 | 125 | 1.8 | 5.5 | No
PIC16F1713 | In Production | $0.92 | 7 | 512 | HEF | 28 | 32 | 16 MHz | 2 | 2 | 17 | 10 | 2 | 8 | No | Yes | No | 4 | 1 |  |  | 0 | 10 | 1 | 1 | 1 | 0 | No | No | 4 | 1 | 1 | 0 | 12 | 0 | -40 | 125 | 1.8 | 5.5 | No
PIC16F1716 | In Production | $0.98 | 14 | 1024 | HEF | 28 | 32 | 16 MHz | 2 | 2 | 17 | 10 | 2 | 8 | No | Yes | No | 4 | 1 |  |  | 0 | 10 | 1 | 1 | 1 | 0 | No | No | 4 | 1 | 1 | 0 | 12 | 0 | -40 | 125 | 1.8 | 5.5 | No
PIC16F1717 | In Production | $1.36 | 14 | 1024 | HEF | 40 | 32 | 16 MHz | 2 | 2 | 28 | 10 | 2 | 8 | No | Yes | No | 4 | 1 |  |  | 0 | 10 | 1 | 1 | 1 | 0 | No | No | 4 | 1 | 1 | 0 | 12 | 0 | -40 | 125 | 1.8 | 5.5 | No
PIC16F1718 | In Production | $1.05 | 28 | 2048 | HEF | 28 | 32 | 16 MHz | 2 | 2 | 17 | 10 | 2 | 8 | No | Yes | No | 4 | 1 |  |  | 0 | 10 | 1 | 1 | 1 | 0 | No | No | 4 | 1 | 1 | 0 | 12 | 0 | -40 | 125 | 1.8 | 5.5 | No
PIC16F1719 | In Production | $1.41 | 28 | 2048 | HEF | 40 | 32 | 16 MHz | 2 | 2 | 28 | 10 | 2 | 8 | No | Yes | No | 4 | 1 |  |  | 0 | 10 | 1 | 1 | 1 | 0 | No | No | 4 | 1 | 1 | 0 | 12 | 0 | -40 | 125 | 1.8 | 5.5 | No
PIC16F753 | In Production | $0.63 | 3.5 | 128 | HEF | 14 | 20 | 8 MHz | 2 | 1 | 8 | 10 | 1 | 9 | Yes | No | Yes | 3 | 1 |  | 2 | 0 | 0 | 0 | 0 | 0 | 0 | No | No | 0 | 1 | 0 | 0 | 8 | 0 | -40 | 125 | 2 | 5.5 | Yes
PIC16F1764 | Future Product | Call for pricing | 7 | 512 | HEF | 14 | 32 | 32 MHz, 32 kHz | 2 | 1 |  | 10 | 1 | 10 | No | Yes | Yes | 4 | 3 |  | 3 |  | 16 | 1 | 1 | 1 | 0 | No | No | 3 | 1 | 0 |  |  |  | -40 | 125 | 1.8 | 5.5 | No
PIC16F1765 | Future Product | Call for pricing | 14 | 1024 | HEF | 14 | 32 | 32 MHz, 32 kHz | 2 | 1 |  | 10 | 1 | 10 | No | Yes | Yes | 4 | 3 |  | 3 |  | 16 | 1 | 1 | 1 | 0 | No | No | 3 | 1 | 0 |  |  |  | -40 | 125 | 1.8 | 5.5 | No
PIC16F1768 | Future Product | Call for pricing | 7 | 512 | HEF | 20 | 32 | 32 MHz, 32 kHz | 4 | 2 |  | 10 | 2 |  | No | Yes | Yes | 4 | 3 |  | 3 |  | 16 | 1 | 1 | 1 | 0 | No | No |  | 2 |  |  |  |  | -40 | 125 | 1.8 | 5.5 | No
PIC16F1769 | Future Product | Call for pricing | 14 | 1024 | HEF | 20 | 32 | None | 4 | 2 |  | 10 | 2 |  | No | Yes | Yes | 4 | 3 |  | 3 |  | 16 | 1 | 1 | 1 | 0 | No | No |  | 2 |  |  |  |  | -40 | 125 | 1.8 | 5.5 | No
PIC16F627A | In Production | $1.30 | 1.75 | 224 | 128 | 18 | 20 | 4 MHz | 2 | 0 | 0 | 0 | 0 | 0 | No | No |  | 2 | 1 |  |  | 0 | 10 | 1 | 0 | 0 | 0 | No | NO | 0 | 0 | 0 | 0 | 0 | 0 | -40 | 125 | 2 | 5.5 | No
PIC16F628A | In Production | $1.47 | 3.5 | 224 | 128 | 18 | 20 | 4 MHz | 2 | 0 | 0 | 0 | 0 | 0 | No | No |  | 2 | 1 |  |  | 0 | 10 | 1 | 0 | 0 | 0 | No | NO | 0 | 0 | 0 | 0 | 0 | 0 | -40 | 125 | 2 | 5.5 | No
PIC16F630 | In Production | $0.91 | 1.75 | 64 | 128 | 14 | 20 | 4 MHz | 1 | 0 | 0 | 0 | 0 | 0 | No | No |  | 1 | 1 |  |  | 0 | 0 | 1 | 0 | 0 | 0 | No | NO | 0 | 0 | 0 | 0 | 0 | 0 | -40 | 125 | 2 | 5.5 | No
PIC16F631 | In Production | $0.91 | 1.75 | 64 | 128 | 20 | 20 | 8 MHz, 32 kHz | 2 | 0 | 0 | 0 | 0 | 0 | Yes | No |  | 1 | 1 |  |  | 0 | 0 | 0 | 0 | 0 | 0 | No | NO | 0 | 0 | 0 | 0 | 0 | 0 | -40 | 125 | 2 | 5.5 | No
PIC16F676 | In Production | $0.98 | 1.75 | 64 | 128 | 14 | 20 | 4 MHz | 1 | 0 | 8 | 10 | 0 | 0 | No | No |  | 1 | 1 |  |  | 0 | 0 | 1 | 0 | 0 | 0 | No | NO | 0 | 0 | 0 | 0 | 8 | 0 | -40 | 125 | 2 | 5.5 | No
PIC16F818 | In Production | $1.56 | 1.75 | 128 | 128 / HEF | 18 | 20 | No | 0 | 0 | 5 | 10 | 0 | 0 | No | No |  | 2 | 1 |  |  | 0 | 10 | 0 | 0 | 0 | 0 | No | NO | 0 | 0 | 0 | 0 | 5 | 0 | -40 | 125 | 2 | 5.5 | No
PIC16F882 | In Production | $1.16 | 3.5 | 128 | 128 / HEF | 28 | 20 | 8 MHz, 32 kHz | 2 | 0 | 11 | 10 | 0 | 0 | Yes | No |  | 2 | 1 |  |  | 0 | 10 | 1 | 1 | 1 | 0 | No | NO | 0 | 0 | 0 | 0 | 11 | 0 | -40 | 125 | 2 | 5.5 | No
PIC16F570 | In Production | $0.60 | 3 | 64 | 132 / HEF | 28 | 20 | 8 MHz | 2 | 2 | 8 | 8 | 0 | 0 | Yes | No |  | 1 | 0 |  |  | 0 | 0 | 0 | 0 | 0 | 0 | No | NO | 0 | 0 | 0 | 0 | 8 | 0 | -40 | 125 | 2 | 5.5 | No
PIC16F1933 | In Production | $1.23 | 7 | 256 | 256 / HEF | 28 | 32 | 32 MHz, 32 kHz | 2 | 0 | 11 | 10 | 1 | 5 | Yes | No |  | 4 | 1 |  |  | 0 | 10 | 1 | 2 | 2 | 0 | No | NO | 0 | 0 | 0 | 0 | 8 | 60 | -40 | 125 | 1.8 | 5.5 | No
PIC16F1934 | In Production | $1.46 | 7 | 256 | 256 / HEF | 40 | 32 | 32 MHz, 32 kHz | 2 | 0 | 14 | 10 | 1 | 5 | Yes | No |  | 4 | 1 |  |  | 0 | 10 | 1 | 1 | 1 | 0 | No | NO | 0 | 0 | 0 | 0 | 16 | 96 | -40 | 125 | 1.8 | 5.5 | No
PIC16F1936 | In Production | $1.30 | 14 | 512 | 256 / HEF | 28 | 32 | 32 MHz, 32 kHz | 2 | 0 | 11 | 10 | 1 | 5 | Yes | No |  | 4 | 1 |  |  | 0 | 10 | 1 | 1 | 1 | 0 | No | NO | 0 | 0 | 0 | 0 | 8 | 60 | -40 | 125 | 1.8 | 5.5 | No
PIC16F1937 | In Production | $1.53 | 14 | 512 | 256 / HEF | 40 | 32 | 32 MHz, 32 kHz | 2 | 0 | 14 | 10 | 1 | 5 | Yes | No |  | 4 | 1 |  |  | 0 | 10 | 1 | 1 | 1 | 0 | No | NO | 0 | 0 | 0 | 0 | 16 | 96 | -40 | 125 | 1.8 | 5.5 | No
PIC16F1938 | In Production | $1.37 | 28 | 1024 | 256 / HEF | 28 | 32 | 32 MHz, 32 kHz | 2 | 0 | 11 | 10 | 1 | 5 | Yes | No |  | 4 | 1 |  |  | 0 | 10 | 1 | 1 | 1 | 0 | No | NO | 0 | 0 | 0 | 0 | 8 | 60 | -40 | 125 | 1.8 | 5.5 | No
PIC16F1939 | In Production | $1.61 | 28 | 1024 | 256 / HEF | 40 | 32 | 32 MHz, 32 kHz | 2 | 0 | 14 | 10 | 1 | 5 | Yes | No |  | 4 | 1 |  |  | 0 | 10 | 1 | 1 | 1 | 0 | No | NO | 0 | 0 | 0 | 0 | 16 | 96 | -40 | 125 | 1.8 | 5.5 | No
PIC16F1946 | In Production | $1.75 | 14 | 512 | 256 / HEF | 64 | 32 | 32 MHz, 32 kHz | 3 | 0 | 17 | 10 | 1 | 5 | Yes | No |  | 4 | 1 |  |  | 0 | 10 | 1 | 1 | 1 | 0 | No | NO | 0 | 0 | 0 | 0 | 17 | 184 | -40 | 125 | 1.8 | 5.5 | No
PIC16F1947 | In Production | $1.82 | 28 | 1024 | 256 / HEF | 64 | 32 | 32 MHz, 32 kHz | 3 | 0 | 17 | 10 | 1 | 5 | Yes | No |  | 4 | 1 |  |  | 0 | 10 | 2 | 2 | 2 | 0 | No | NO | 0 | 0 | 0 | 0 | 17 | 184 | -40 | 125 | 1.8 | 5.5 | No
PIC16F636 | In Production | $0.92 | 3.5 | 128 | 256 | 14 | 20 | 8 MHz, 32 kHz | 2 | 0 | 0 | 0 | 0 | 0 | No | No |  | 1 | 1 |  |  | 0 | 0 | 0 | 0 | 0 | 0 | No | NO | 0 | 0 | 0 | 0 | 0 | 0 | -40 | 125 | 2 | 5.5 | No
PIC16F639 | In Production | $2.27 | 3.5 | 128 | 256 | 20 | 20 | 8 MHz, 32 kHz | 2 | 0 | 0 | 0 | 0 | 0 | No | No |  | 1 | 1 |  |  | 0 | 0 | 0 | 0 | 0 | 0 | No | NO | 0 | 0 | 0 | 0 | 0 | 0 | -40 | 125 | 2 | 5.5 | No
PIC16F648A | In Production | $1.67 | 7 | 256 | 256 | 18 | 20 | 4 MHz | 2 | 0 | 0 | 0 | 0 | 0 | No | No |  | 2 | 1 |  |  | 0 | 10 | 0 | 0 | 0 | 0 | No | NO | 0 | 0 | 0 | 0 | 0 | 0 | -40 | 125 | 2 | 5.5 | No
PIC16F677 | In Production | $0.99 | 3.5 | 128 | 256 | 20 | 20 | 8 MHz, 32 kHz | 2 | 0 | 12 | 10 | 0 | 0 | Yes | No |  | 1 | 1 |  |  | 0 | 0 | 0 | 0 | 0 | 0 | No | NO | 0 | 0 | 0 | 0 | 12 | 0 | -40 | 125 | 2 | 5.5 | No
PIC16F684 | In Production | $0.98 | 3.5 | 128 | 256 | 14 | 20 | 8 MHz, 32 kHz | 2 | 0 | 8 | 10 | 0 | 0 | No | No |  | 2 | 1 |  |  | 0 | 10 | 0 | 1 | 1 | 0 | No | NO | 0 | 0 | 0 | 0 | 8 | 0 | -40 | 125 | 2 | 5.5 | No
PIC16F685 | In Production | $1.13 | 7 | 256 | 256 | 20 | 20 | 8 MHz, 32 kHz | 2 | 0 | 12 | 10 | 0 | 0 | Yes | No |  | 2 | 1 |  |  | 0 | 10 | 0 | 0 | 0 | 0 | No | NO | 0 | 0 | 0 | 0 | 12 | 0 | -40 | 125 | 2 | 5.5 | No
PIC16F687 | In Production | $1.07 | 3.5 | 128 | 256 | 20 | 20 | 8 MHz, 32 kHz | 2 | 0 | 12 | 10 | 0 | 0 | Yes | No |  | 1 | 1 |  |  | 0 | 0 | 0 | 0 | 0 | 0 | No | NO | 0 | 0 | 0 | 0 | 12 | 0 | -40 | 125 | 2 | 5.5 | No
PIC16F688 | In Production | $1.04 | 7 | 256 | 256 | 14 | 20 | 8 MHz, 32 kHz | 2 | 0 | 8 | 10 | 0 | 0 | No | No |  | 1 | 1 |  |  | 0 | 0 | 1 | 1 | 1 | 0 | No | NO | 0 | 0 | 0 | 0 | 8 | 0 | -40 | 125 | 2 | 5.5 | No
PIC16F689 | In Production | $1.13 | 7 | 256 | 256 | 20 | 20 | 8 MHz, 32 kHz | 2 | 0 | 12 | 10 | 0 | 0 | Yes | No |  | 1 | 1 |  |  | 0 | 0 | 1 | 0 | 0 | 0 | No | NO | 0 | 0 | 0 | 0 | 12 | 0 | -40 | 125 | 2 | 5.5 | No
PIC16F690 | In Production | $1.20 | 7 | 256 | 256 | 20 | 20 | 8 MHz, 32 kHz | 2 | 0 | 12 | 10 | 0 | 0 | Yes | No |  | 2 | 1 |  |  | 0 | 10 | 1 | 1 | 1 | 0 | No | NO | 0 | 0 | 0 | 0 | 12 | 0 | -40 | 125 | 2 | 5.5 | No
PIC16F785 | In Production | $1.12 | 3.5 | 128 | 256 | 20 | 20 | 8 MHz, 32 kHz | 2 | 2 | 12 | 10 | 0 | 0 | Yes | No |  | 2 | 1 |  |  | 0 | 10 | 1 | 1 | 1 | 0 | No | NO | 0 | 0 | 0 | 0 | 12 | 0 | -40 | 125 | 2 | 5.5 | No
PIC16F819 | In Production | $1.78 | 3.5 | 256 | 256 / HEF | 18 | 20 | No | 0 | 0 | 5 | 10 | 0 | 0 | No | No |  | 2 | 1 |  |  | 0 | 10 | 0 | 1 | 1 | 0 | No | NO | 0 | 0 | 0 | 0 | 5 | 0 | -40 | 125 | 2 | 5.5 | No
PIC16F87 | In Production | $2.06 | 7 | 368 | 256 / HEF | 18 | 20 | 8 MHz | 2 | 0 | 0 | 0 | 0 | 0 | No | No |  | 2 | 1 |  |  | 0 | 10 | 0 | 0 | 0 | 0 | No | NO | 0 | 0 | 0 | 0 | 0 | 0 | -40 | 125 | 2 | 5.5 | No
PIC16F88 | In Production | $2.20 | 7 | 368 | 256 / HEF | 18 | 20 | 8MHz | 2 | 0 | 7 | 10 | 0 | 0 | No | No |  | 2 | 1 |  |  | 0 | 10 | 1 | 1 | 1 | 0 | No | No | 0 | 0 | 0 | 0 | 0 | 0 | -40 | 125 | 2 | 5.5 | No
PIC16F883 | In Production | $1.37 | 7 | 256 | 256 / HEF | 28 | 20 | 8 MHz, 32 kHz | 2 | 0 | 11 | 10 | 0 | 0 | Yes | No |  | 2 | 1 |  |  | 0 | 10 | 1 | 1 | 1 | 0 | No | NO | 0 | 0 | 0 | 0 | 11 | 0 | -40 | 125 | 2 | 5.5 | No
PIC16F884 | In Production | $1.63 | 7 | 256 | 256 / HEF | 40 | 20 | 8 MHz, 32 kHz | 2 | 0 | 14 | 10 | 0 | 0 | Yes | No |  | 2 | 1 |  |  | 0 | 10 | 1 | 1 | 1 | 0 | No | NO | 0 | 0 | 0 | 0 | 11 | 0 | -40 | 125 | 2 | 5.5 | No
PIC16F886 | In Production | $1.49 | 14 | 368 | 256 / HEF | 28 | 20 | 8 MHz, 32 kHz | 2 | 0 | 11 | 10 | 0 | 0 | Yes | No |  | 2 | 1 |  |  | 0 | 10 | 1 | 1 | 1 | 0 | No | NO | 0 | 0 | 0 | 0 | 11 | 0 | -40 | 125 | 2 | 5.5 | No
PIC16F887 | In Production | $1.78 | 14 | 368 | 256 / HEF | 40 | 20 | 8 MHz, 32 kHz | 2 | 0 | 14 | 10 | 0 | 0 | Yes | No |  | 2 | 1 |  |  | 0 | 10 | 1 | 1 | 1 | 0 | No | NO | 0 | 0 | 0 | 0 | 11 | 0 | -40 | 125 | 2 | 5.5 | No
PIC16F913 | In Production | $1.72 | 7 | 256 | 256 | 28 | 20 | 8 MHz, 32 kHz | 2 | 0 | 5 | 10 | 0 | 0 | No | No |  | 2 | 1 |  |  | 0 | 10 | 1 | 1 | 1 | 0 | No | NO | 0 | 0 | 0 | 0 | 5 | 60 | -40 | 125 | 2 | 5.5 | No
PIC16F914 | In Production | $2.03 | 7 | 256 | 256 | 40 | 20 | 8 MHz, 32 kHz | 2 | 0 | 8 | 10 | 0 | 0 | No | No |  | 2 | 1 |  |  | 0 | 10 | 1 | 1 | 1 | 0 | No | NO | 0 | 0 | 0 | 0 | 8 | 96 | -40 | 125 | 2 | 5.5 | No
PIC16F916 | In Production | $1.93 | 14 | 352 | 256 | 28 | 20 | 8 MHz, 32 kHz | 2 | 0 | 5 | 10 | 0 | 0 | No | No |  | 2 | 1 |  |  | 0 | 10 | 1 | 1 | 1 | 0 | No | NO | 0 | 0 | 0 | 0 | 5 | 60 | -40 | 125 | 2 | 5.5 | No
PIC16F917 | In Production | $2.17 | 14 | 352 | 256 | 40 | 20 | 8 MHz, 32 kHz | 2 | 0 | 8 | 10 | 0 | 0 | No | No |  | 2 | 1 |  |  | 0 | 10 | 1 | 1 | 1 | 0 | No | NO | 0 | 0 | 0 | 0 | 8 | 96 | -40 | 125 | 2 | 5.5 | No
PIC16F946 | In Production | $2.31 | 14 | 336 | 256 | 64 | 20 | 8 MHz, 32 kHz | 2 | 0 | 8 | 10 | 0 | 0 | No | No |  | 2 | 1 |  |  | 0 | 10 | 1 | 1 | 1 | 0 | No | NO | 0 | 0 | 0 | 0 | 8 | 168 | -40 | 125 | 2 | 5.5 | No
PIC16F1782 | In Production | $1.23 | 3.5 | 256 | 256 / HEF | 28 | 32 | 32 MHz, 32 kHz | 3 | 2 | 11 | 12 | 1 | 8 | Yes | No | No | 2 | 1 | 0 | 0 | 10 | 16 | 0 | 0 | 0 | 0 | No | No | 0 | 0 | 0 | 2 | 11 | 0 | -40 | 125 | 1.8 | 5.5 | No
PIC16F1783 | In Production | $1.30 | 7 | 512 | 256 / HEF | 28 | 32 | 32 MHz, 32 kHz | 3 | 2 | 11 | 12 | 1 | 8 | Yes | No | No | 2 | 1 | 0 | 0 | 10 | 16 | 1 | 1 | 1 | 0 | No | No | 0 | 0 | 0 | 2 | 11 | 0 | -40 | 125 | 1.8 | 5.5 | No
PIC16F1784 | In Production | $1.54 | 7 | 512 | 256 / HEF | 40 | 32 | 32 MHz, 32 kHz | 4 | 3 | 14 | 12 | 1 | 8 | Yes | No | No | 2 | 1 | 0 | 0 | 17 | 16 | 1 | 1 | 1 | 0 | No | No | 0 | 0 | 0 | 3 | 14 | 0 | -40 | 125 | 1.8 | 5.5 | No
PIC16F1786 | In Production | $1.37 | 14 | 1024 | 256 / HEF | 28 | 32 | 32 MHz, 32 kHz | 4 | 2 | 11 | 12 | 1 | 8 | Yes | No | No | 2 | 1 | 0 | 0 | 11 | 16 | 1 | 1 | 1 | 0 | No | No | 0 | 0 | 0 | 3 | 11 | 0 | -40 | 125 | 1.8 | 3.6 | No
PIC16F1787 | In Production | $1.61 | 14 | 1024 | 256 / HEF | 40 | 32 | 32 MHz, 32 kHz | 4 | 3 | 14 | 12 | 1 | 8 | Yes | No | No | 2 | 1 | 0 | 0 | 17 | 16 | 1 | 1 | 1 | 0 | No | No | 0 | 0 | 0 | 3 | 14 | 0 | -40 | 125 | 1.8 | 5.5 | No
PIC16F1788 | In Production | $1.44 | 28 | 2048 | 256 / HEF | 28 | 32 | 32 MHz, 32 kHz | 4 | 2 | 11 | 12 | 2 | 8 | Yes | No | No | 2 | 1 | 0 | 0 | 17 | 16 | 1 | 1 | 1 | 0 | No | No | 0 | 0 | 0 | 4 | 11 | 0 | -40 | 125 | 1.8 | 5.5 | No
PIC16F1789 | In Production | $1.68 | 28 | 2048 | 256 / HEF | 40 | 32 | 32 MHz, 32 kHz | 4 | 3 | 14 | 12 | 2 | 8 | Yes | No | No | 2 | 1 | 0 | 0 | 17 | 16 | 1 | 1 | 1 | 0 | No | No | 0 | 0 | 0 | 4 | 14 | 0 | -40 | 125 | 1.8 | 5.5 | No
PIC16F1823 | In Production | $0.77 | 3.5 | 128 | 256 / HEF | 14 | 32 | 32 MHz, 32 kHz | 2 | 0 | 8 | 10 | 1 | 5 | Yes | No | No | 2 | 1 |  |  | 0 | 0 | 1 | 1 | 1 | 0 | No | No | 0 | 0 | 0 | 0 | 8 | 0 | -40 | 125 | 1.8 | 5.5 | No
PIC16F1824 | In Production | $0.83 | 7 | 256 | 256 / HEF | 14 | 32 | 32 MHz, 32 kHz | 2 | 0 | 8 | 10 | 1 | 5 | Yes | No | No | 4 | 1 |  |  | 0 | 0 | 1 | 1 | 1 | 0 | No | No | 0 | 0 | 0 | 0 | 8 | 0 | -40 | 125 | 1.8 | 5.5 | No
PIC16F1825 | In Production | $0.91 | 14 | 1024 | 256 / HEF | 14 | 32 | 32 MHz, 32 kHz | 2 | 0 | 8 | 10 | 1 | 5 | Yes | No | No | 4 | 1 |  |  | 0 | 10 | 1 | 1 | 1 | 0 | No | No | 0 | 0 | 0 | 0 | 12 | 0 | -40 | 125 | 1.8 | 5.5 | No
PIC16F1826 | In Production | $0.97 | 3.5 | 256 | 256 / HEF | 18 | 32 | 32 MHz, 32 kHz | 2 | 0 | 12 | 10 | 1 | 5 | Yes | No | No | 2 | 1 |  |  | 0 | 10 | 1 | 1 | 1 | 0 | No | No | 0 | 0 | 0 | 0 | 12 | 0 | -40 | 125 | 1.8 | 5.5 | No
PIC16F1827 | In Production | $1.04 | 7 | 384 | 256 / HEF | 18 | 32 | 32 MHz, 32 kHz | 2 | 0 | 12 | 10 | 1 | 5 | Yes | No | No | 4 | 1 |  |  | 0 | 10 | 1 | 2 | 2 | 0 | No | No | 0 | 0 | 0 | 0 | 12 | 0 | -40 | 125 | 1.8 | 5.5 | No
PIC16F1828 | In Production | $0.98 | 7 | 256 | 256 / HEF | 20 | 32 | 32 MHz, 32 kHz | 2 | 0 | 12 | 10 | 1 | 5 | Yes | No | No | 4 | 1 |  |  | 0 | 10 | 1 | 1 | 1 | 0 | No | No | 0 | 0 | 0 | 0 | 12 | 0 | -40 | 125 | 1.8 | 5.5 | No
PIC16F1829 | In Production | $1.04 | 14 | 1024 | 256 / HEF | 20 | 32 | 32 MHz, 32 kHz | 2 | 0 | 12 | 10 | 1 | 5 | Yes | No | No | 4 | 1 |  |  | 0 | 10 | 1 | 2 | 2 | 0 | No | No | 0 | 0 | 0 | 0 | 12 | 0 | -40 | 125 | 1.8 | 5.5 | No
PIC16F1829LIN | Samples Available | $1.27 | 14 | 1024 | 256 / HEF | 20 | 32 | 32 MHz, 32 kHz | 2 | 0 | 9 | 10 | 1 | 5 | Yes | No | No | 4 | 1 |  |  | 0 | 10 | 1 | 0 | 0 | 0 | No | No | 0 | 0 | 0 | 0 | 12 | 0 | -40 | 125 | 2.3 | 5.5 | No
PIC16F18313 | Future Product | Call for pricing | 3.5 | 256 | 256 | 8 | 32 | 32 MHz, 32 kHz | 1 | 0 | 9 | 10 | 1 | 5 | Yes | No | No | 2 | 1 | 0 | 0 | 5 | 10 | 1 | 1 | 1 | 0 | No | No | 2 | 1 | 1 | 0 | 0 | 0 | -40 | 125 | 1.8 | 5.5 | No
PIC16F18323 | Future Product | Call for pricing | 3.5 | 256 | 256 | 14 | 32 | 32 MHz, 32 kHz | 2 | 0 | 15 | 10 | 1 | 5 | Yes | No | No | 2 | 1 | 0 | 0 | 5 | 10 | 1 | 1 | 1 | 0 | No | No | 2 | 1 | 1 | 0 | 0 | 0 | -40 | 125 | 1.8 | 5.5 | No
PIC16F18324 | Future Product | Call for pricing | 7 | 512 | 256 | 14 | 32 | 16 MHz | 2 | 0 | 15 | 10 | 1 | 5 | Yes | No | No | 4 | 3 | 0 | 0 | 5 | 10 | 1 | 1 | 1 | 0 | No | No | 4 | 2 | 1 | 0 | 0 | 0 | -40 | 125 | 1.8 | 5.5 | No
PIC16F18325 | Future Product | Call for pricing | 14 | 1024 | 256 | 14 | 32 | 32 MHz, 32 kHz | 2 | 0 | 15 | 10 | 1 | 5 | Yes | No | No | 4 | 3 | 0 | 0 | 5 | 10 | 1 | 2 | 2 | 0 | No | No | 4 | 2 | 1 | 0 | 0 | 0 | -40 | 125 | 1.8 | 5.5 | No
PIC16F18344 | Future Product | Call for pricing | 7 | 512 | 256 | 20 | 32 | 32 MHz, 32 kHz | 2 | 0 | 21 | 10 | 1 | 5 | Yes | No | No | 4 | 3 | 0 | 0 | 5 | 10 | 1 | 1 | 1 | 0 | No | No | 4 | 2 | 1 | 0 | 0 | 0 | -40 | 125 | 1.8 | 5.5 | No
PIC16F18345 | Future Product | Call for pricing | 14 | 1024 | 256 | 20 | 32 | 32 MHz, 32 kHz | 2 | 0 | 21 | 10 | 1 | 5 | Yes | No | No | 4 | 3 | 0 | 0 | 5 | 10 | 1 | 2 | 2 | 0 | No | No | 4 | 2 | 1 | 0 | 0 | 0 | -40 | 125 | 1.8 | 5.5 | No
PIC16F1847 | In Production | $1.09 | 14 | 1024 | 256 / HEF | 18 | 32 | 32 MHz, 32 kHz | 2 | 0 | 12 | 10 | 1 | 5 | Yes | No | No | 4 | 1 |  |  | 0 | 10 | 1 | 2 | 2 | 0 | No | No | 0 | 0 | 0 | 0 | 12 | 0 | -40 | 125 | 1.8 | 5.5 | No
PIC16F526 | In Production | $0.55 | 1.5 | 67 | 64 | 14 | 20 | 4 MHz, 8 MHz | 2 | 0 | 3 | 8 | 0 | 0 | Yes | No |  | 1 | 0 |  |  | 0 | 0 | 0 | 0 | 0 | 0 | No | NO | 0 | 0 | 0 | 0 | 3 | 0 | -40 | 125 | 2 | 5.5 | No
PIC16F527 | In Production | $0.49 | 1.5 | 68 | 64 / HEF | 20 | 20 | 4 MHz, 8 MHz | 2 | 2 | 8 | 8 | 0 | 0 | Yes | No |  | 1 | 0 |  |  | 0 | 0 | 0 | 0 | 0 | 0 | No | NO | 0 | 0 | 0 | 0 | 8 | 0 | -40 | 125 | 2 | 5.5 | No
PIC16F84A | In Production | $3.11 | 1.75 | 68 | 64 | 18 | 20 | No | 0 | 0 | 0 | 0 | 0 | 0 | No | No |  | 1 | 0 |  |  | 0 | 0 | 0 | 0 | 0 | 0 | No | No | 0 | 0 | 0 | 0 | 0 | 0 | -40 | 85 | 2 | 6 | No
PIC16F1512 | In Production | $0.81 | 3.5 | 128 | HEF | 28 | 20 | 16 MHz, 32 kHz | 0 | 0 | 17 | 10 | 0 | 0 | Yes | No | No | 2 | 1 |  |  | 0 | 0 | 1 | 1 | 1 | 0 | No | No | 0 | 0 | 0 | 0 | 17 | 0 | -40 | 125 | 1.8 | 5.5 | No
PIC16F1513 | In Production | $0.88 | 7 | 256 | HEF | 28 | 20 | 16 MHz, 32 kHz | 0 | 0 | 17 | 10 | 0 | 0 | Yes | No | No | 2 | 1 |  |  | 0 | 0 | 1 | 1 | 1 | 0 | No | No | 0 | 0 | 0 | 0 | 17 | 0 | -40 | 125 | 1.8 | 5.5 | No
PIC16LF1554 | In Production | $0.60 | 7 | 256 | HEF | 14 | 32 | 16 MHz | 0 | 0 | 11 | 10 |  |  | No | No | No | 2 | 1 |  |  |  |  | 1 | 1 | 1 | 0 | No | No | 0 |  |  |  |  |  | -40 | 85 | 1.8 | 3.6 | No
PIC16LF1559 | In Production | $0.73 | 14 | 512 |  | 20 | 32 | 16 MHz | 0 |  | 17 | 10 |  |  | No | No | No | 2 | 1 |  |  |  |  | 1 | 1 | 1 | 0 | No | No |  |  |  |  |  |  | -40 | 85 | 1.8 | 3.6 | No
PIC16F1613 | In Production | $0.60 | 3.5 | 256 | HEF | 14 | 32 | 32 MHz, 32 kHz | 2 | 0 | 8 | 10 | 0 | 0 | No | Yes | No | 4 | 1 | 2 | 3 | 0 | 0 | 0 | 0 | 0 |  | Yes | Yes | 0 | 1 | 0 | 0 | 0 | 0 | -40 | 125 | 1.8 | 5.5 | No
PIC16F1614 | Samples Available | Call for pricing | 7 | 512 | HEF | 14 | 32 | 32 MHz, 32 kHz | 2 | 0 | 8 | 10 | 0 | 0 | No | Yes | No | 1 | 3 | 2 | 3 | 0 | 0 | 1 | 1 | 1 | 0 | Yes | Yes | 2 | 1 | 0 | 0 | 0 | 0 | -40 | 125 | 1.8 | 5.5 | Yes
PIC16F1615 | Samples Available | Call for pricing | 14 | 1024 | HEF | 14 | 32 | 32 MHz, 32 kHz | 2 | 0 | 8 | 10 | 0 | 0 | No | Yes | No | 1 | 3 | 2 | 3 | 0 | 0 | 1 | 1 | 1 | 0 | Yes | Yes | 4 | 1 | 0 | 0 | 0 | 0 | -40 | 125 | 1.8 | 5.5 | Yes
PIC16F1618 | Samples Available | Call for pricing | 7 | 512 | HEF | 20 | 32 | 32 MHz, 32 kHz | 2 | 0 | 12 | 10 | 0 | 0 | No | Yes | No | 1 | 3 | 2 | 3 | 0 | 0 | 1 | 1 | 1 | 0 | Yes | Yes | 2 | 1 | 0 | 0 | 0 | 0 | -40 | 125 | 1.8 | 5.5 | Yes
PIC16F1619 | Samples Available | Call for pricing | 14 | 1024 | HEF | 20 | 32 | 32 MHz, 32 kHz | 2 | 0 | 12 | 10 | 0 | 0 | No | Yes | No | 1 | 3 | 2 | 3 | 0 | 0 | 1 | 1 | 1 | 0 | Yes | Yes | 4 | 1 | 0 | 0 | 0 | 0 | -40 | 125 | 1.8 | 5.5 | Yes
PIC16F18855 | Future Product | Call for pricing | 14 | 1024 | 256 | 28 | 32 | 32 kHz | 2 | 0 | 24 | 10 | 1 | 5 | Yes | Yes | No | 1 | 4 | 2 | 3 | 0 | 10 | 1 | 2 | 2 | 0 | Yes | Yes | 4 | 3 | 1 | 0 | 24 | 0 | -40 | 125 | 1.8 | 5.5 | No
PIC16F18875 | Future Product | Call for pricing | 14 | 1024 | 256 | 40 | 32 | 32 kHz | 2 | 0 | 24 | 10 | 1 | 5 | Yes | Yes | No | 1 | 4 | 2 | 3 | 0 | 10 | 1 | 2 | 2 | 0 | Yes | Yes | 4 | 3 | 1 | 0 | 24 | 0 | -40 | 125 | 1.8 | 5.5 | No
