Le-Dome-RDS/hope-bike/electronic parts/datasheet_composants_electronique/Connecteur NineContinent.png

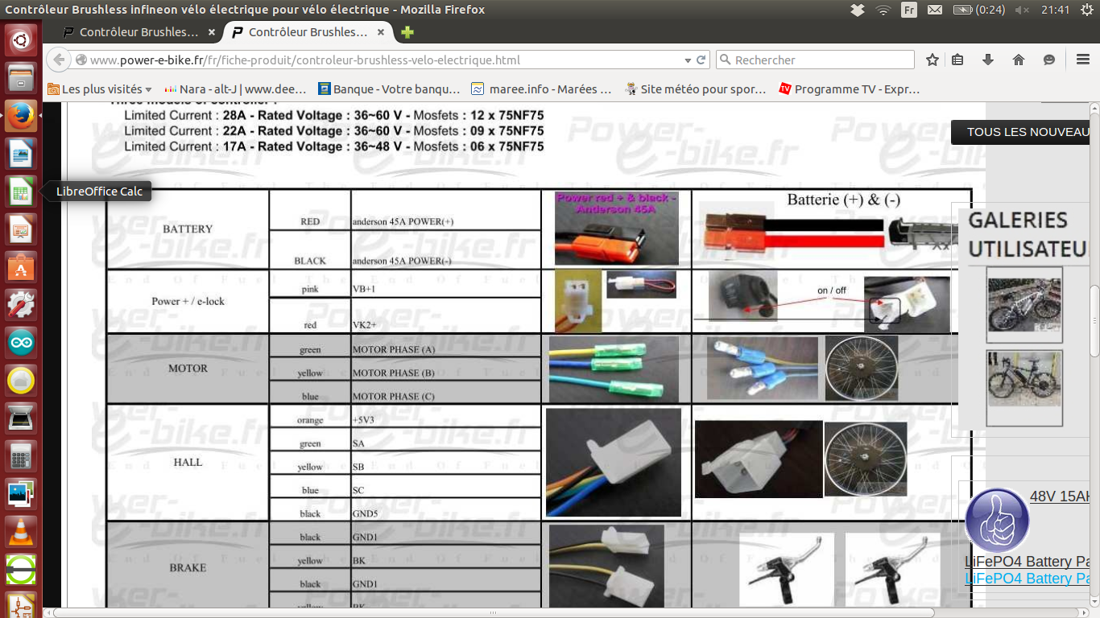
electronic parts/datasheet_composants_electronique/Connecteur NineContinent.png
