Le-Dome-RDS/hope-bike/electronic parts/datasheet_moteur_batterie_etc/Capteur hall moteur auguste.png

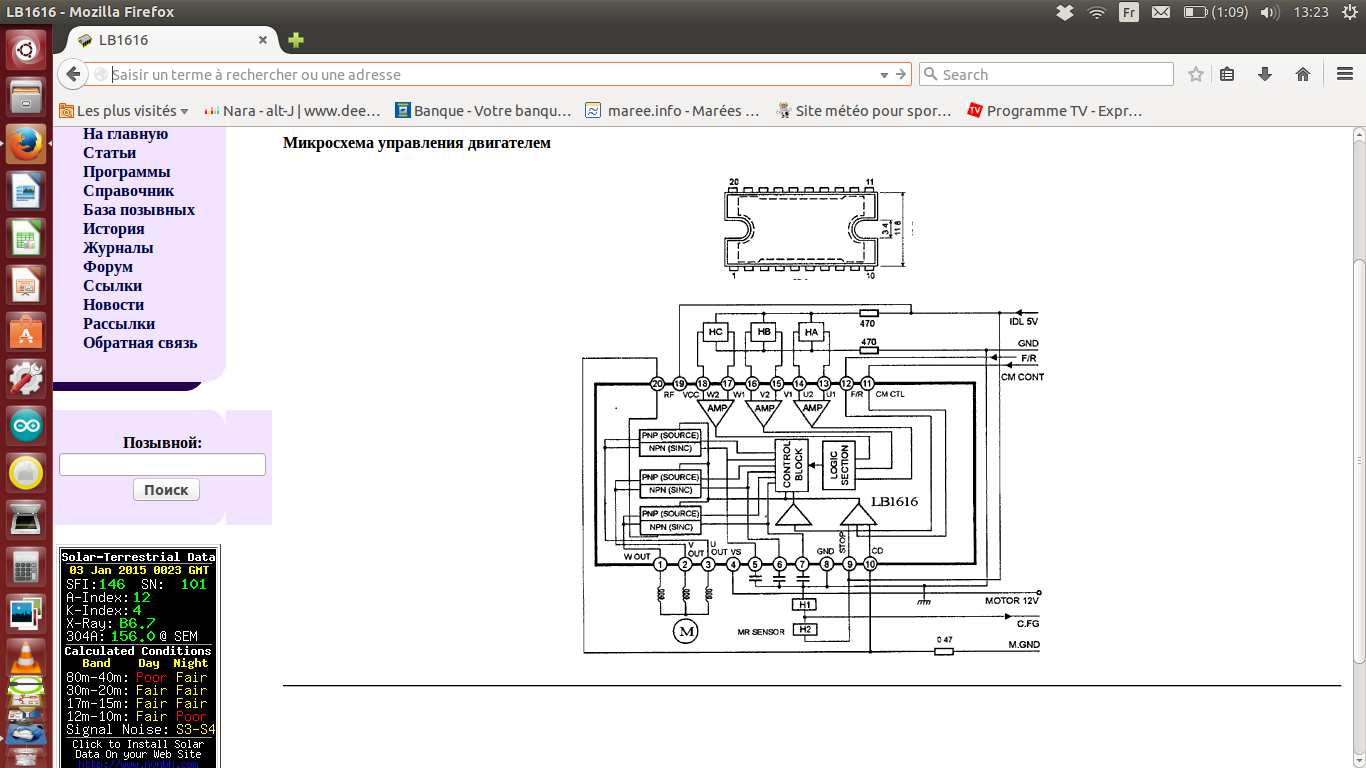
electronic parts/datasheet_moteur_batterie_etc/Capteur hall moteur auguste.png
