Le-Dome-RDS/hope-bike/mecanic_and_wiring/passe_cable/cable_pass_A.dxf

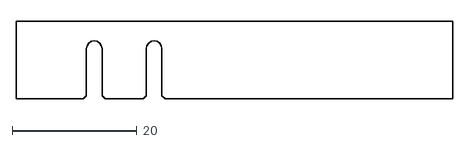
[picture p35: CAD file, 2017-01-19]
mecanic_and_wiring/passe_cable/cable_pass_A.dxf
70.0 x 12.5
