Le-Dome-RDS/hope-bike/mecanic_and_wiring/V2/capteur_roue/bicycle+wheel+magnet+valve+cap+for+cycle+computer+sensor/files/magnet2.stl

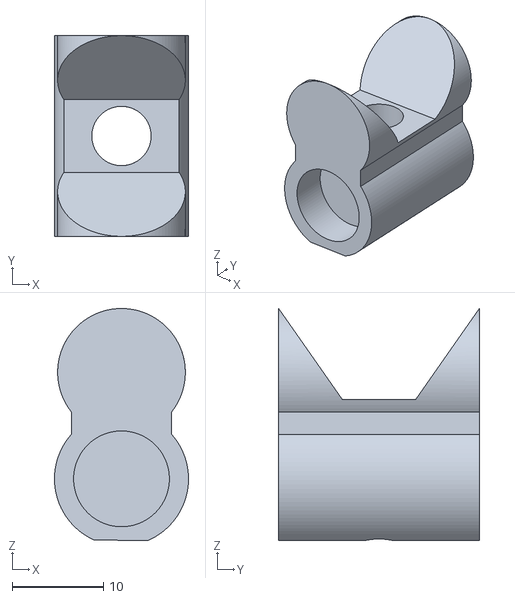
[picture p36: CAD file, 2021-04-15]
mecanic_and_wiring/V2/capteur_roue/bicycle+wheel+magnet+valve+cap+for+cycle+computer+sensor/files/magnet2.stl
14.7 x 22.0 x 25.4
