Le-Dome-RDS/hope-bike/mecanic_and_wiring/V2/capteur_roue/sensorholder_JM.stl

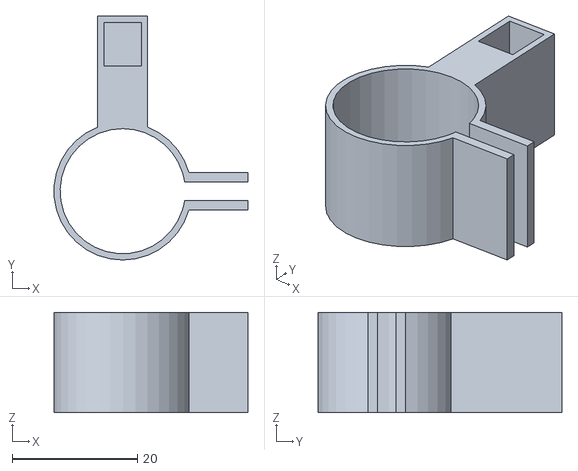
[picture p37: CAD file, 2021-04-15]
mecanic_and_wiring/V2/capteur_roue/sensorholder_JM.stl
31.0 x 39.0 x 16.0
