Le-Dome-RDS/hope-bike/mecanic_and_wiring/passe_cable/cable_pass_B.dxf

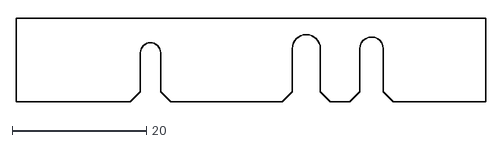
[picture p38: CAD file, 2017-01-19]
mecanic_and_wiring/passe_cable/cable_pass_B.dxf
70.0 x 12.5
