Le-Dome-RDS/hope-bike/mecanic_and_wiring/V2/capteur_roue/sensor_holder_JM_v1.scad

$fs=0.01;

difference(){
   import("sensorholder_JM.stl");
   #translate([15,0,7.5])rotate([90,0,0])cylinder(d=4,h=10,center=true);
}
