Le-Dome-RDS/hope-bike/(list of files, cad)

Other CAD files:
source_code/power_management_card/Pic12F/dist/default/production/Pic12F.production.obj
source_code/power_management_card/Pic12F/l.obj
