Le-Dome-RDS/hope-bike/mecanic_and_wiring/readme.md

#Electronic parts

This folder contains datasheet, eagle project and schematic for the three different PCB files.
