Le-Dome-RDS/hope-bike/mecanic_and_wiring/passe_cable/readme.md

# Pass-through cables for the power box.

vector based files for the pass-trough cables. 

source files are avalaible online using the oneshape online software : [https://cad.onshape.com/documents/28c964af0a8e3b48dc2c4eba/w/41f251a99306efb0a103f119/e/b366ce12fd65bd0c7537bd0e](http://)
