Le-Dome-RDS/hope-bike/mecanic_and_wiring/V2/capteur_roue/bicycle+wheel+magnet+valve+cap+for+cycle+computer+sensor/README.txt

bicycle wheel magnet valve cap for cycle computer sensor by yeshuayes on Thingiverse: https://www.thingiverse.com/thing:2443305
