Le-Dome-RDS/hope-bike/source_code/power_management_card/howto_program/src/H&B_Electronique.odt

# Formation Electronique Hope 'n Bike

Présents :

Arnaud Boulay, Jean-Marc Routoure, François Trocque, Michel Milhau, Matthieu Debar, Damien Scher, Julien Lefebvre.

Présentation par François Trocque.

Principe : Un arduino (base Uno) en réseau avec la carte de puissance. Un manager demande aux composants du réseau l'état d'une liste de variables, qui sont communiquées partout, lis la donnée qui veut. Pas d'adressage des composants liste de variables d'environnement.

Moteur triphasé avec capteurs à effet hall (3 capteurs à 120 degrés)

## Commentaires carte :

Puissance : signal de pilotage en PWM. 0 à 100%.

Courant moteur : CAN 10bits. 0 à 1024.

Capteur pédalage : nombre de pions captés par demi seconde

Tension batterie : CAN 10 bits. 0 à 1024.

Vitesse moteur : On prend le signal d'un seul des 3 capteurs effet Hall (Hall A). Nombre de passage par demi-seconde.

Alimentation à découpage : 36V en entrée, 8V 3A en sortie. Les alims des circuits en 5V se font via des régulateurs supplémentaires.

# Procédure de test et de mise en œuvre

Les alims pendant les tests électriques et l'upload software sont à faire avec l'alim de labo et non avec la batterie.

### Contrôle visuel des cartes :

Sens de la diode D2. Trait de sens.

Sens de la diode D1 (12 sur le plan).Trait de sens.

Sens des condensateurs (cylindres gris et noir). Le trait noir sur le moins.

Etat des condensateurs (pas gonflés)

Positionnement des circuits intégrés : biseau à gauche sur boitiers quand on tiens la carte avec MOSFETs à droite. Sauf celui en haut qui a biseau à droite.

Mise en œuvre des cartes

Casser le tour cassable de la carte.

### Contrôles de Tension divers

Alim 30 V CC sur bornier gauche (petit). + sur broche 2, - sur broche 8 (masse).

Mesurer 7,6V entre borne 3 et borne 8.

Mesurer 5 V entre W4 (gauche) et borne 8.

Mesurer 12V entre circuit U4 et borne 8.

Mesurer 17,6V entre diode D1( patte du haut) et borne 8.

(on trouvera 30V entre D1 patte du bas et borne 8).

### On strappe W4

Fermer le pont W4 avec un point de soudure.

Test :

Alim 30 V CC sur bornier gauche. + sur broche 2, - sur broche 8 (masse).

Mesurer 5 V entre W4 (gauche) et borne 8.

### Upload des softwares

Télécharger l'IDE chez MicroChip (marche tout OS):

http://www.microchip.com/pagehandler/en-us/family/8bit/

Lien direct : http://www.microchip.com/stellent/idcplg?IdcService=SS_GET_PAGE&nodeId=1406&dDocName=en019469&redirects=mplab

Lancer MPLAB X IDE

Ouvrir fichiers DC22_Mesure_Pic12.hex et DC22_Var_Pic16.hex.

Voir fichiers dans dossier Soft Hw4.

Carte HORS TENSION brancher le connecteur de flashage sur les 5 broches du haut (selon photo Damien & Michel)

Mettre sur tension 30V la carte (Bornier gauche, + sur broche 2, - sur broche 8)

Uploader le code Mesure sur la puce mesure (en haut)

METTRE HORS TENSION LA CARTE

Carte HORS TENSION brancher le connecteur de flashage sur les 5 broches du bas (selon photo Damien & Michel)

Mettre sur tension 30V la carte.

Uploader le code Variateur sur la puce variateur (en bas)

### On strappe W3, W2 et W1.
