Le-Dome-RDS/hope-bike/source_code/command_card/how_to_program/howto_progral_command_board.pdf

## Howto program the arduino command board ?

Author : J-M Routoure 19/01/2017.

The arduino pro mini board is used for the command board of the hope and bike project . You should have install the arduino IDE. You should have a programmer dedicated to this card.

The steps to install the firmware are :

- download the complete files in the GitHub repository of the project. https://github.com/fablabDome/hope-bike (Button « Clone and download » and « download zip ») (https://github.com/fablabDome/hope-bike)

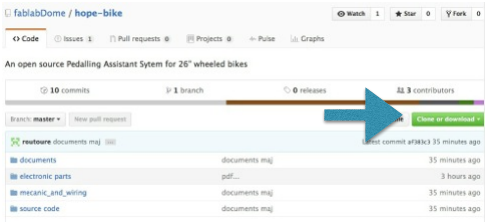
[picture p45: figure]

- in the arduino IDE, open the hnb_drive_xxx project ( with xxx the number version) located in the source_code/command_card/ directory. You should obtain something like this :

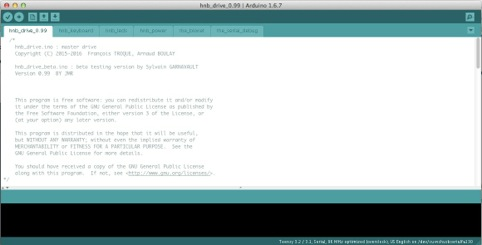
[picture p46: figure]

- on the command board, you have to desolder the device named D1 shown in the figure below, you need to desolder only one side of the device and lift it a little bit as shown in the second photo :

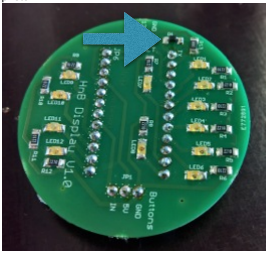
[picture p47: figure]

: D1 before unsoldering

: one pin of D1 has been unsoldered and

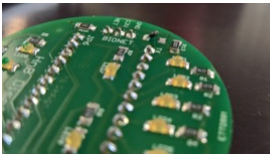
[picture p48: figure]

lift
- connect the arduino programmer in the arduino board

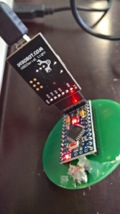
[picture p49: figure]
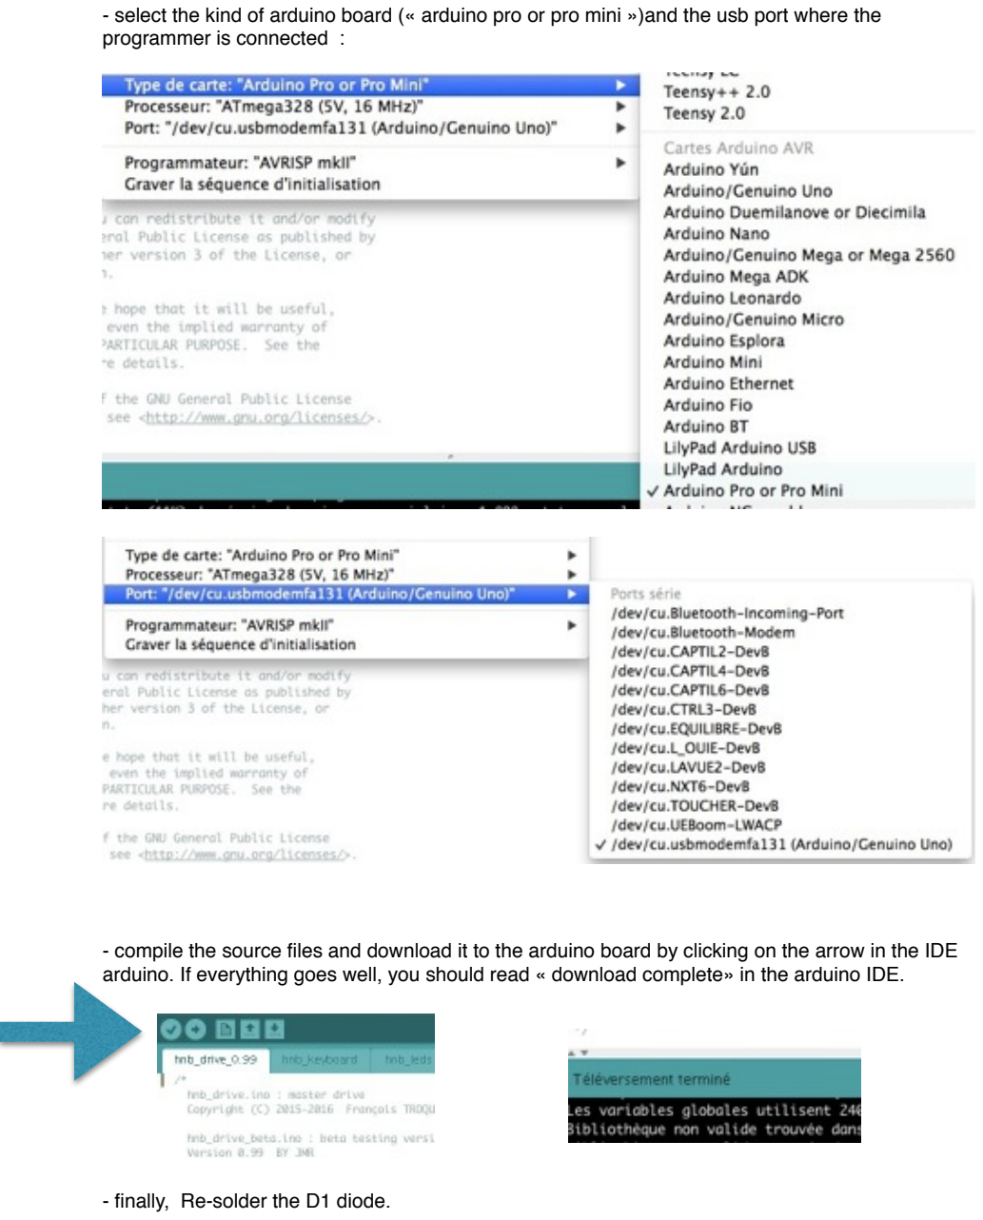
[picture p50: page 3]

- select the kind of arduino board (« arduino pro or pro mini »)and the usb port where the programmer is connected :
- compile the source files and download it to the arduino board by clicking on the arrow in the IDE arduino. If everything goes well, you should read « download complete» in the arduino IDE.
- finally, Re-solder the D1 diode.
