Le-Dome-RDS/hope-bike/documents/src/attestation_de_bon_montage.pages/preview-web.jpg

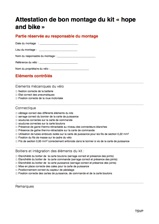
documents/src/attestation_de_bon_montage.pages/preview-web.jpg
