Le-Dome-RDS/hope-bike/mecanic_and_wiring/V2/capteur_roue/bicycle+wheel+magnet+valve+cap+for+cycle+computer+sensor/images/4e362a6728f387e63cb195ecb9e6835a.png

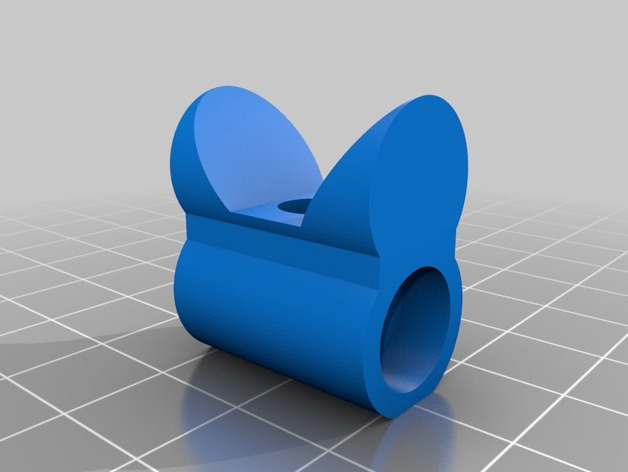
mecanic_and_wiring/V2/capteur_roue/bicycle+wheel+magnet+valve+cap+for+cycle+computer+sensor/images/4e362a6728f387e63cb195ecb9e6835a.png
