Le-Dome-RDS/hope-bike/source_code/command_card/how_to_program/src/D1_before.jpg

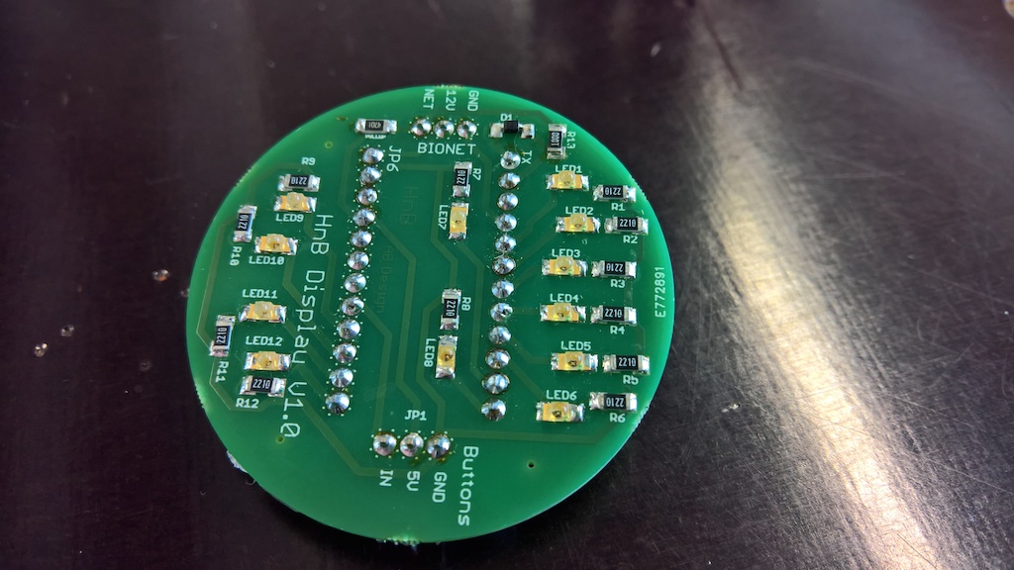
source_code/command_card/how_to_program/src/D1_before.jpg
