Le-Dome-RDS/hope-bike/source_code/command_card/how_to_program/src/howto_progral_command_board.pages/Data/pasted-image-29.jpg

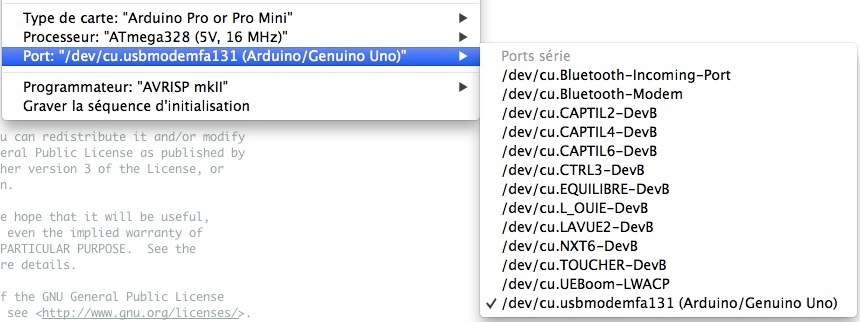
source_code/command_card/how_to_program/src/howto_progral_command_board.pages/Data/pasted-image-29.jpg
