Le-Dome-RDS/hope-bike/source_code/power_management_card/howto_program/src/connexion_programmateur.jpg

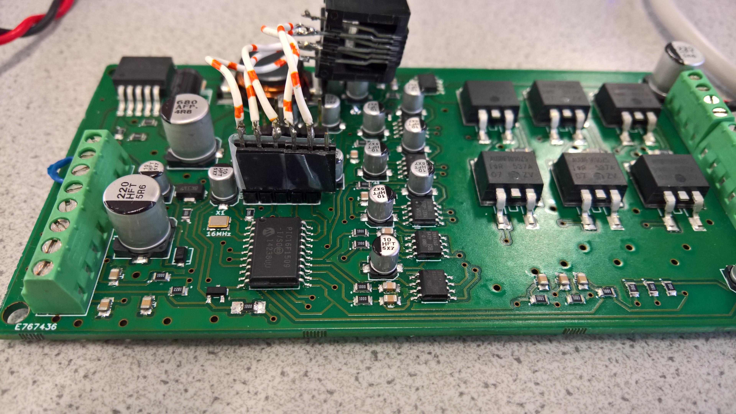
source_code/power_management_card/howto_program/src/connexion_programmateur.jpg
