Le-Dome-RDS/hope-bike/source_code/power_management_card/howto_program/src/howto_program_power_board.pages/Data/connexion_programmateur-small-69.jpg

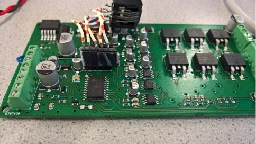
source_code/power_management_card/howto_program/src/howto_program_power_board.pages/Data/connexion_programmateur-small-69.jpg
