Le-Dome-RDS/hope-bike/source_code/power_management_card/howto_program/src/howto_program_power_board.pages/preview-web.jpg

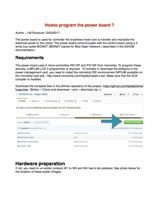
source_code/power_management_card/howto_program/src/howto_program_power_board.pages/preview-web.jpg
