Le-Dome-RDS/hope-bike/source_code/power_management_card/howto_program/src/power_board.jpg

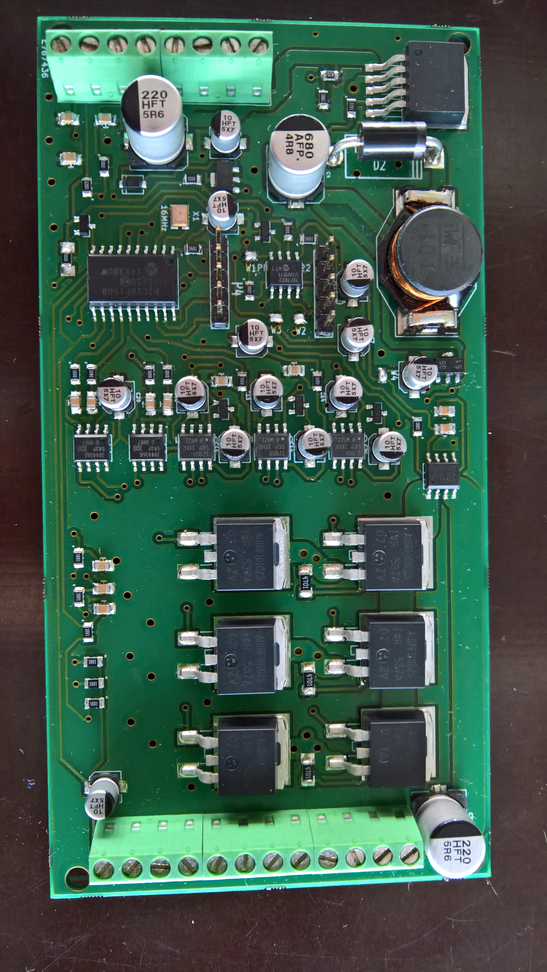
source_code/power_management_card/howto_program/src/power_board.jpg
