Le-Dome-RDS/hope-bike/source_code/power_management_card/howto_program/src/W4_unsoldered.jpg

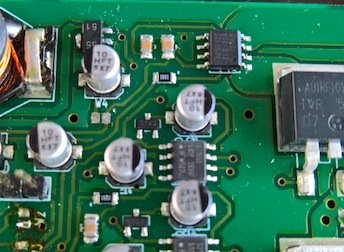
source_code/power_management_card/howto_program/src/W4_unsoldered.jpg
