Le-Dome-RDS/hope-bike/source_code/power_management_card/howto_program/src/procedure_test_carte_puissance.odt

Tests à effectuer sur la carte de puissance après que les composants ait été soudés et avant qu'elles soient mises en place dans un vélo

Test visuel

Comment réalisez-le test visuel

1) Regarder qu’il ne manque aucun composent à l’aide du schéma .

2) Regarder que les condensateurs polarisés sont bien placés du bon côté grâce à la cote grise sur le plan.

3) Regarder que les circuits « drivers » sont bien placés du bon côté grâce au chanfrein sur le circuit intégré situé à gauche du composant.

Test au voltmètre

Ou prendre les mesures avec le voltmètre

1) - Se mettre sur la masse N°8

-Se mettre sur le plus N°3

-On doit avoir 8V

2) - Se mettre sur la masse N°8

- Se mettre sur W4, W3, W2, W1

- On doit avoir 5V à chaque fois

3) - Se mettre sur la masse N°8

- Se mettre sur la petite patte U4 à gauche

- On doit avoir 19V

4) - Se mettre sur la masse N°8

- Se mettre sur la petite patte U4 à droite

- On doit avoir 12V

Programmation

Comment programmer la carte électronique

1) Faire la connexion en branchant la connectique de programmation du côté droit là où il manque un fil en laissent la carte sans tensions d’abord sur U5 (mesure) et ensuite sur U6 (puissance).

2) Mettre la carte sous tension et télécharger le programme de mesure sur le microcontrôleur U5.

3) Remettre la carte sans tension puis brancher la connectique de programmation sur le port U6 ensuite mettre la carte sous tensions et télécharger le programme variateur sur le microcontrôleur U6

4) Ensuite souder les points, W4, W3, W2, W1 pour faire le dialogue.

5) Puis test

Branchement des fils sur la carte

1 | interrupteur Ou un strap
2
3 | + | rouge | Arduino
4 | bio net | jaune
5 | - (masse) | noir
6 | + | rouge | Capteur de pédalage
7 | capteur | vert
8 | - ( masse) | noir

1 | + | Rouge | Batterie
2 | - | Noir
3 | Vert Foncé | | Moteur
4 | Jaune foncé
5 | Bleu foncé
6 | Rien Rien
7 | Masse du vélo
8 | | Rouge | Moteur
9 | | Vert
10 | | Jaune
11 | | Bleu
12 | GND | Noir
