Le-Dome-RDS/hope-bike/documents/Architecture-HnB_V3.pdf

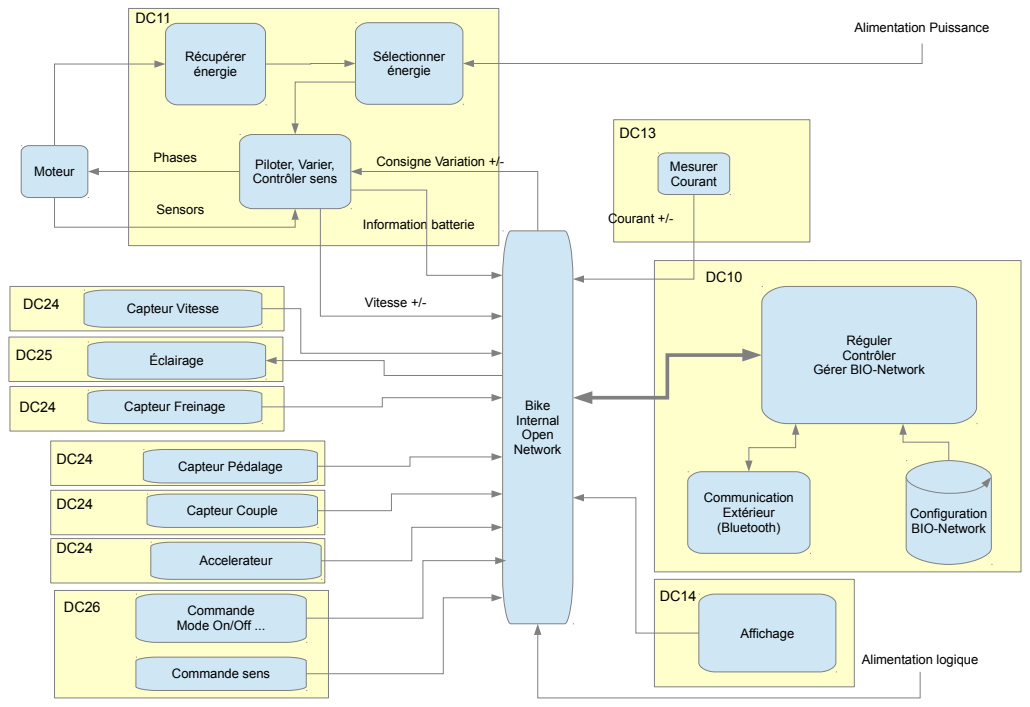
[picture p71: page 1]
Moteur; Piloter, Varier,; Contrôler sens; Mesurer Courant; Consigne Variation +/-; Sensors; Phases; Alimentation Puissance; Vitesse +/-; Capteur Pédalage; Capteur Couple; Accelerateur; Commande; Mode On/Off ...; Affichage; Capteur Vitesse; Alimentation logique; Bike Internal Open Network; Capteur Freinage; Récupérer énergie; Sélectionner énergie; Information batterie; Configuration BIO-Network; Communication Extérieur (Bluetooth); Courant +/-; Commande sens; Éclairage

Réguler
Contrôler
Gérer BIO-Network

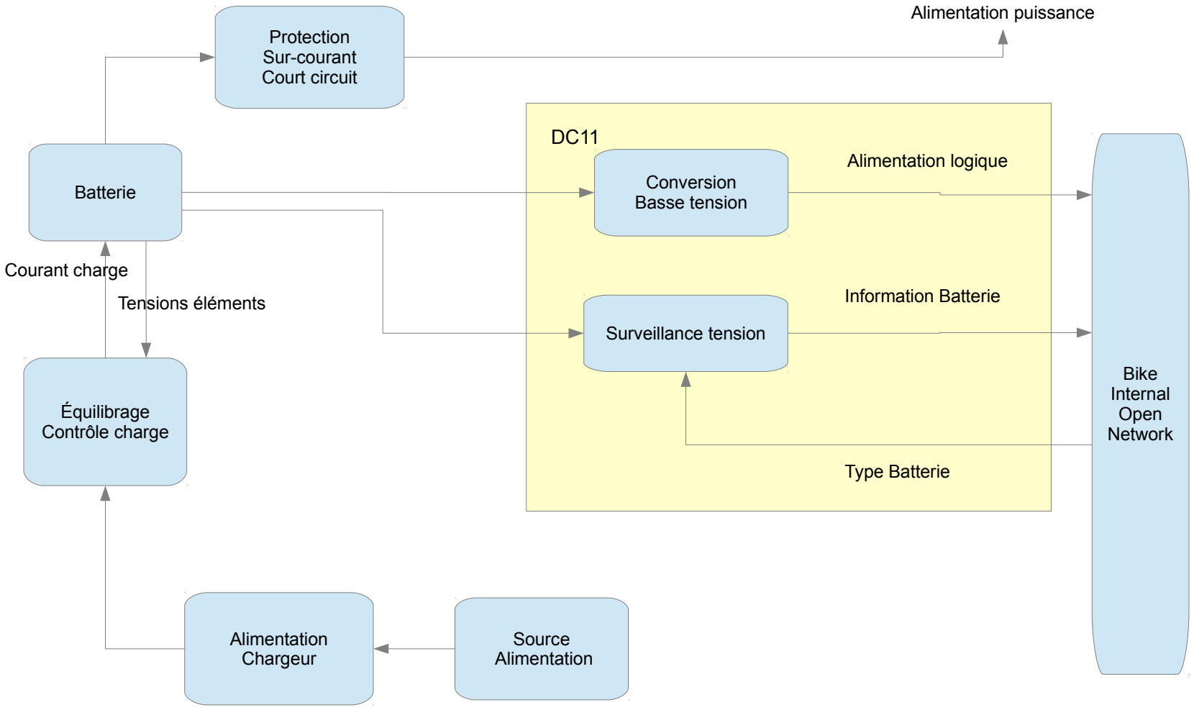
[picture p72: figure]
Batterie; Conversion; Basse tension; Alimentation logique; Surveillance tension; Information Batterie; Protection Sur-courant Court circuit; Alimentation puissance; Équilibrage Contrôle charge; Courant charge; Tensions éléments; Alimentation Chargeur; Source Alimentation; Bike Internal Open Network; Type Batterie
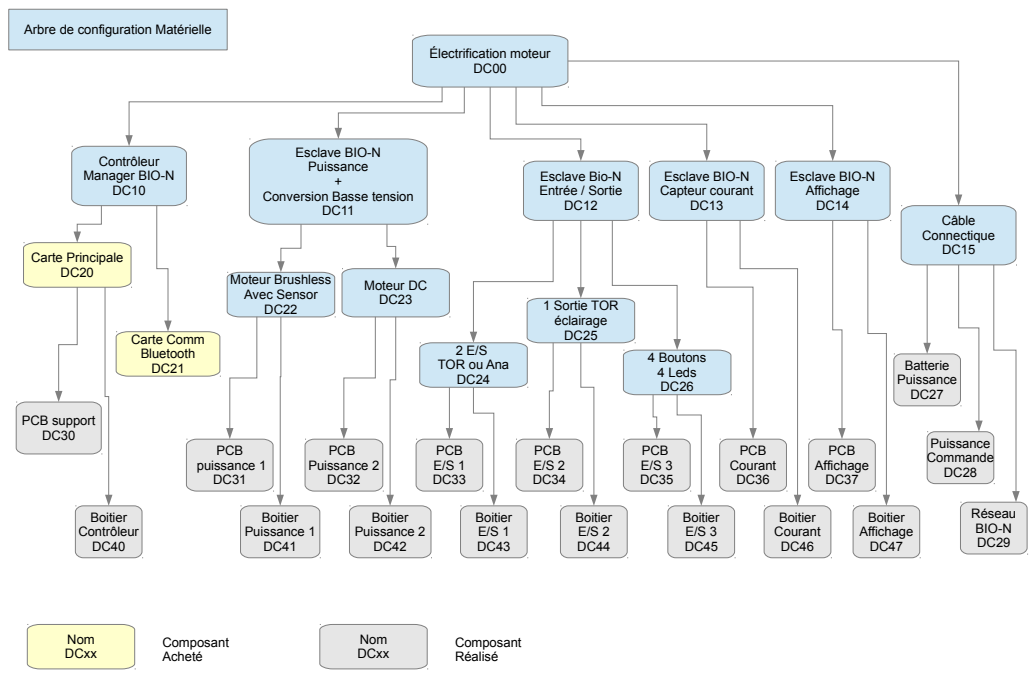
[picture p73: page 3]
Électrification moteur DC00; Contrôleur Manager BIO-N DC10; Esclave BIO-N Puissance +; Esclave Bio-N Entrée / Sortie DC12; Esclave BIO-N Affichage DC14; Esclave BIO-N Capteur courant DC13; Carte Principale DC20; Carte Comm Bluetooth DC21; Moteur Brushless Avec Sensor DC22; Moteur DC DC23; 2 E/S TOR ou Ana DC24; 1 Sortie TOR éclairage DC25; 4 Boutons 4 Leds DC26; PCB support DC30; Boitier Contrôleur DC40; PCB puissance 1 DC31; Boitier Puissance 1 DC41; PCB Puissance 2 DC32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

Arbre de configuration Matérielle

Conversion Basse tension
