Le-Dome-RDS/hope-bike/electronic parts/button_board/multi-switches.pdf

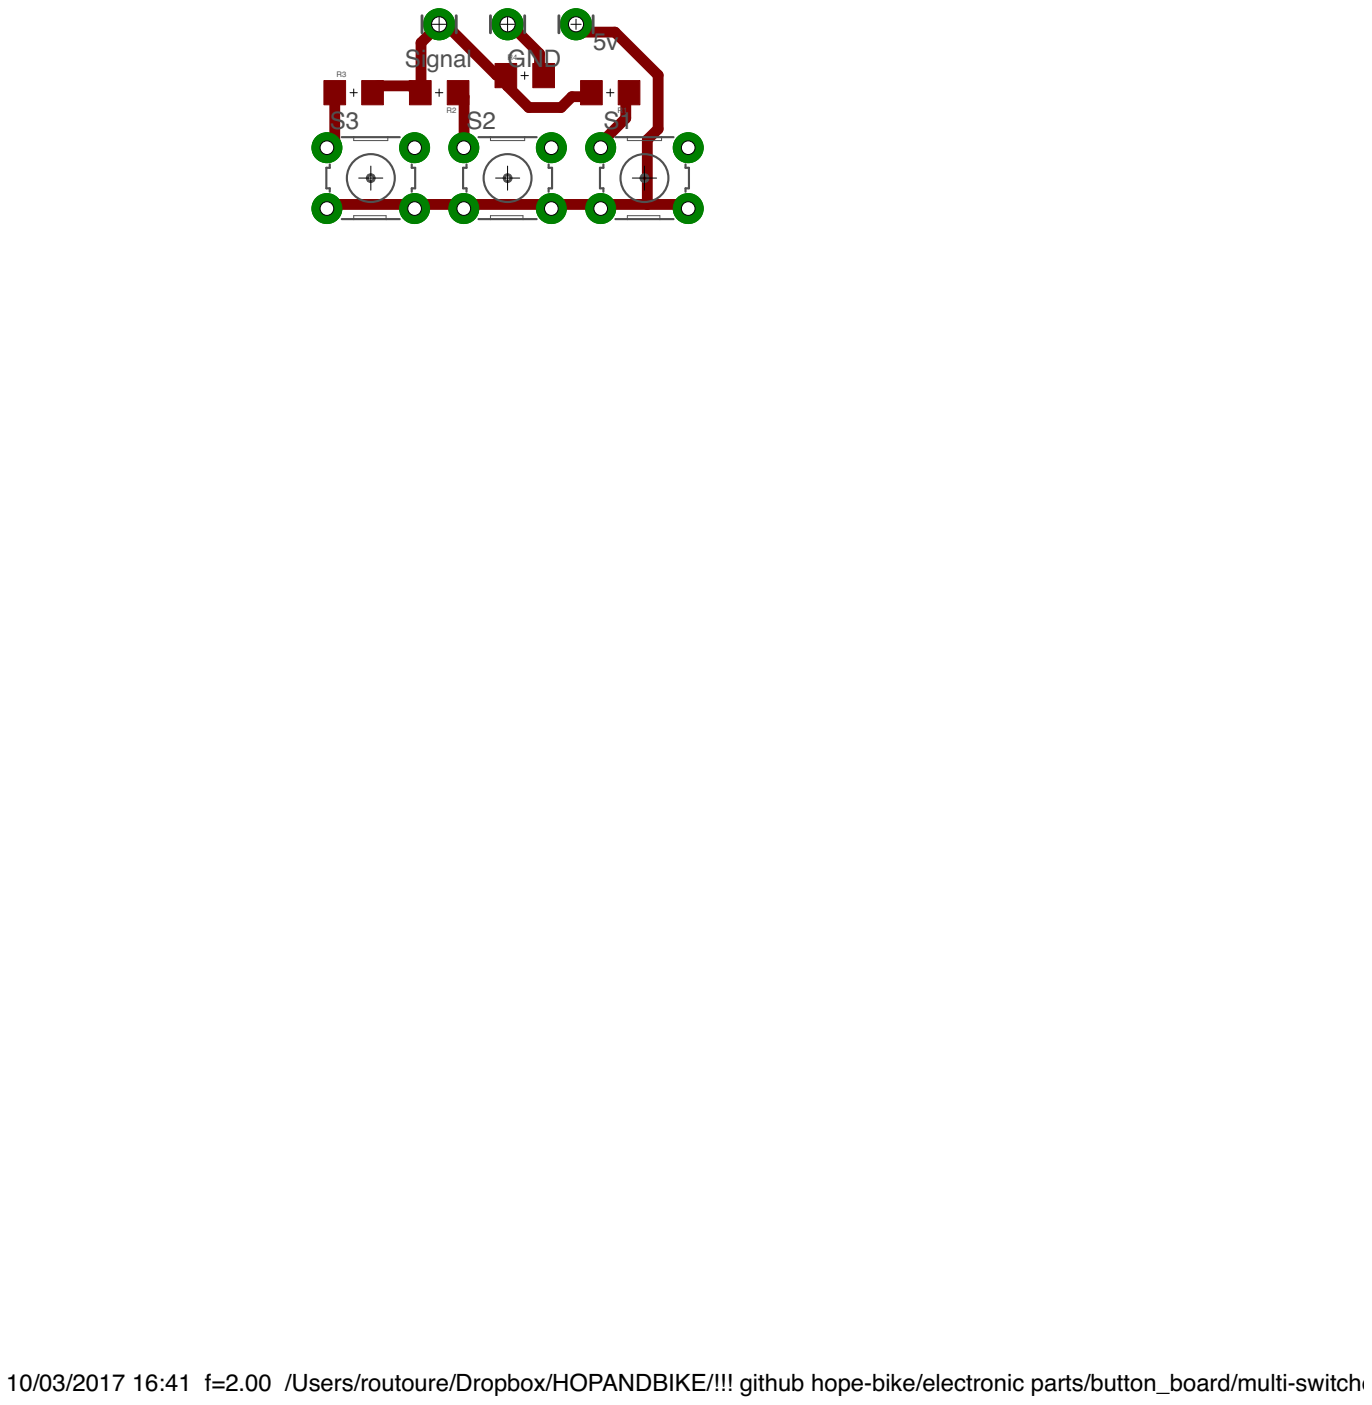
[picture p74: page 1]

10/03/2017 16:41 f=2.00 /Users/routoure/Dropbox/HOPANDBIKE/!!! github hope-bike/electronic parts/button_board/multi-switches.brd
