Le-Dome-RDS/hope-bike/electronic parts/button_board/hnb-switches-sch.pdf

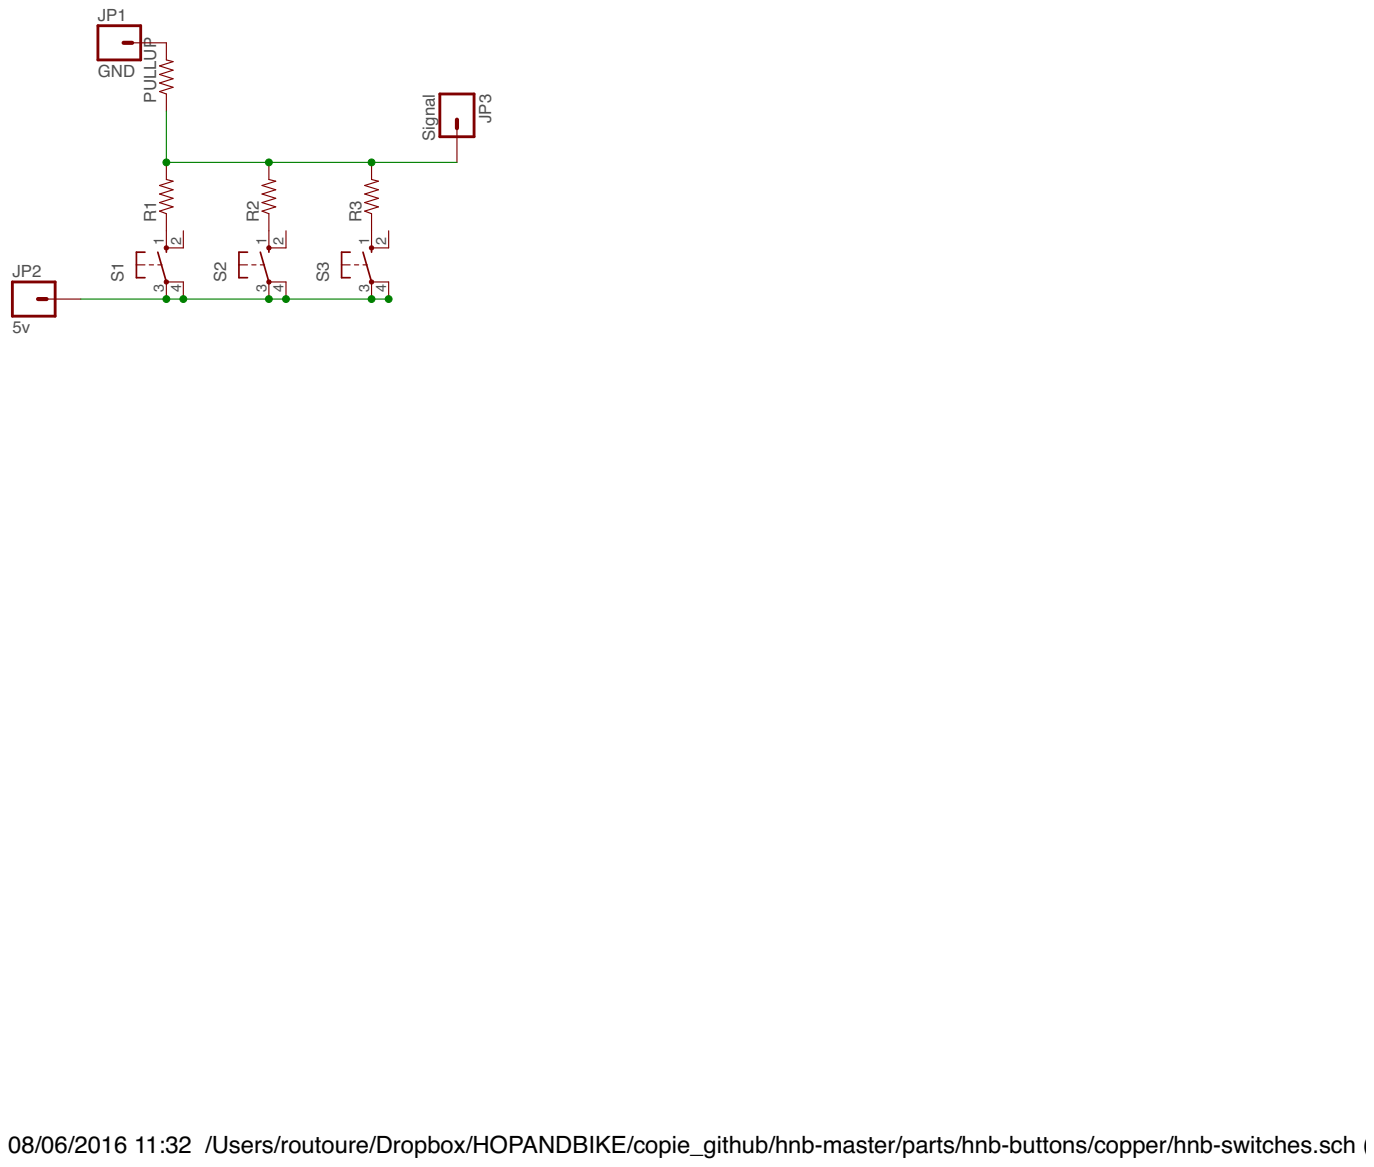
[picture p75: page 1]

08/06/2016 11:32 /Users/routoure/Dropbox/HOPANDBIKE/copie_github/hnb-master/parts/hnb-buttons/copper/hnb-switches.sch (Sheet: 1/1)
