Le-Dome-RDS/hope-bike/electronic parts/command_board/hnb-display.pdf

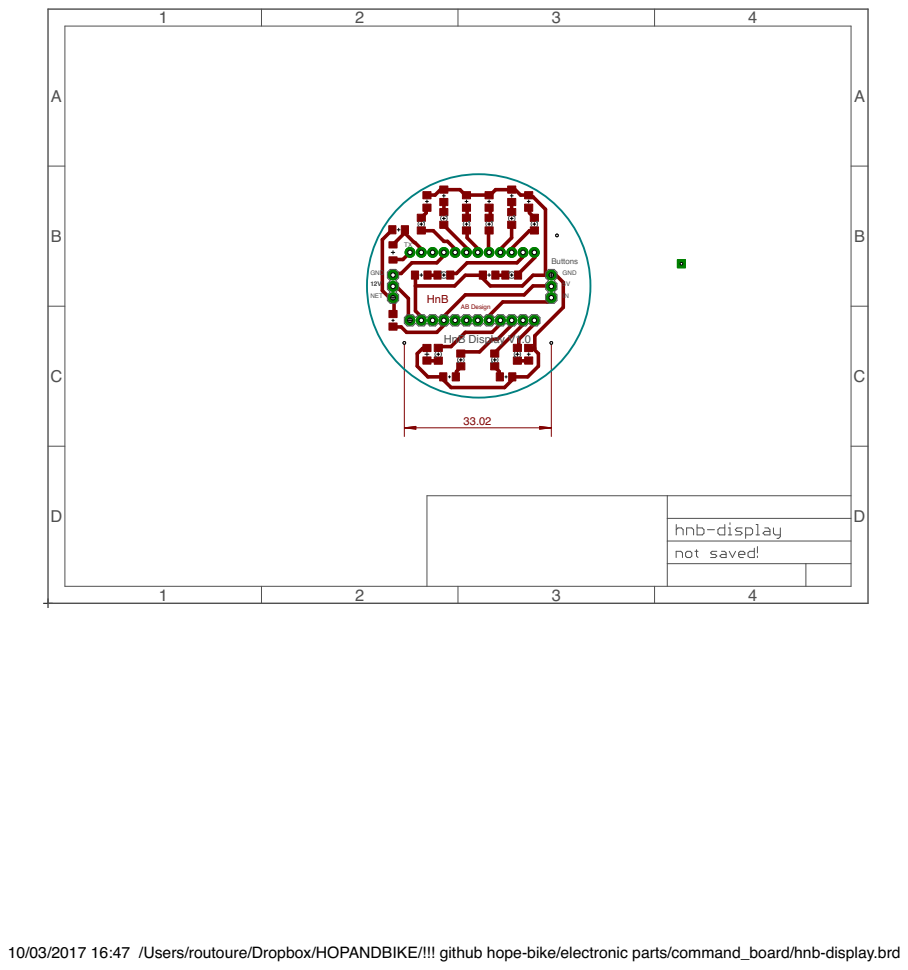
[picture p76: page 1]

10/03/2017 16:47 /Users/routoure/Dropbox/HOPANDBIKE/!!! github hope-bike/electronic parts/command_board/hnb-display.brd
