Le-Dome-RDS/hope-bike/electronic parts/power_management_board/hnb-puissance-sch.pdf

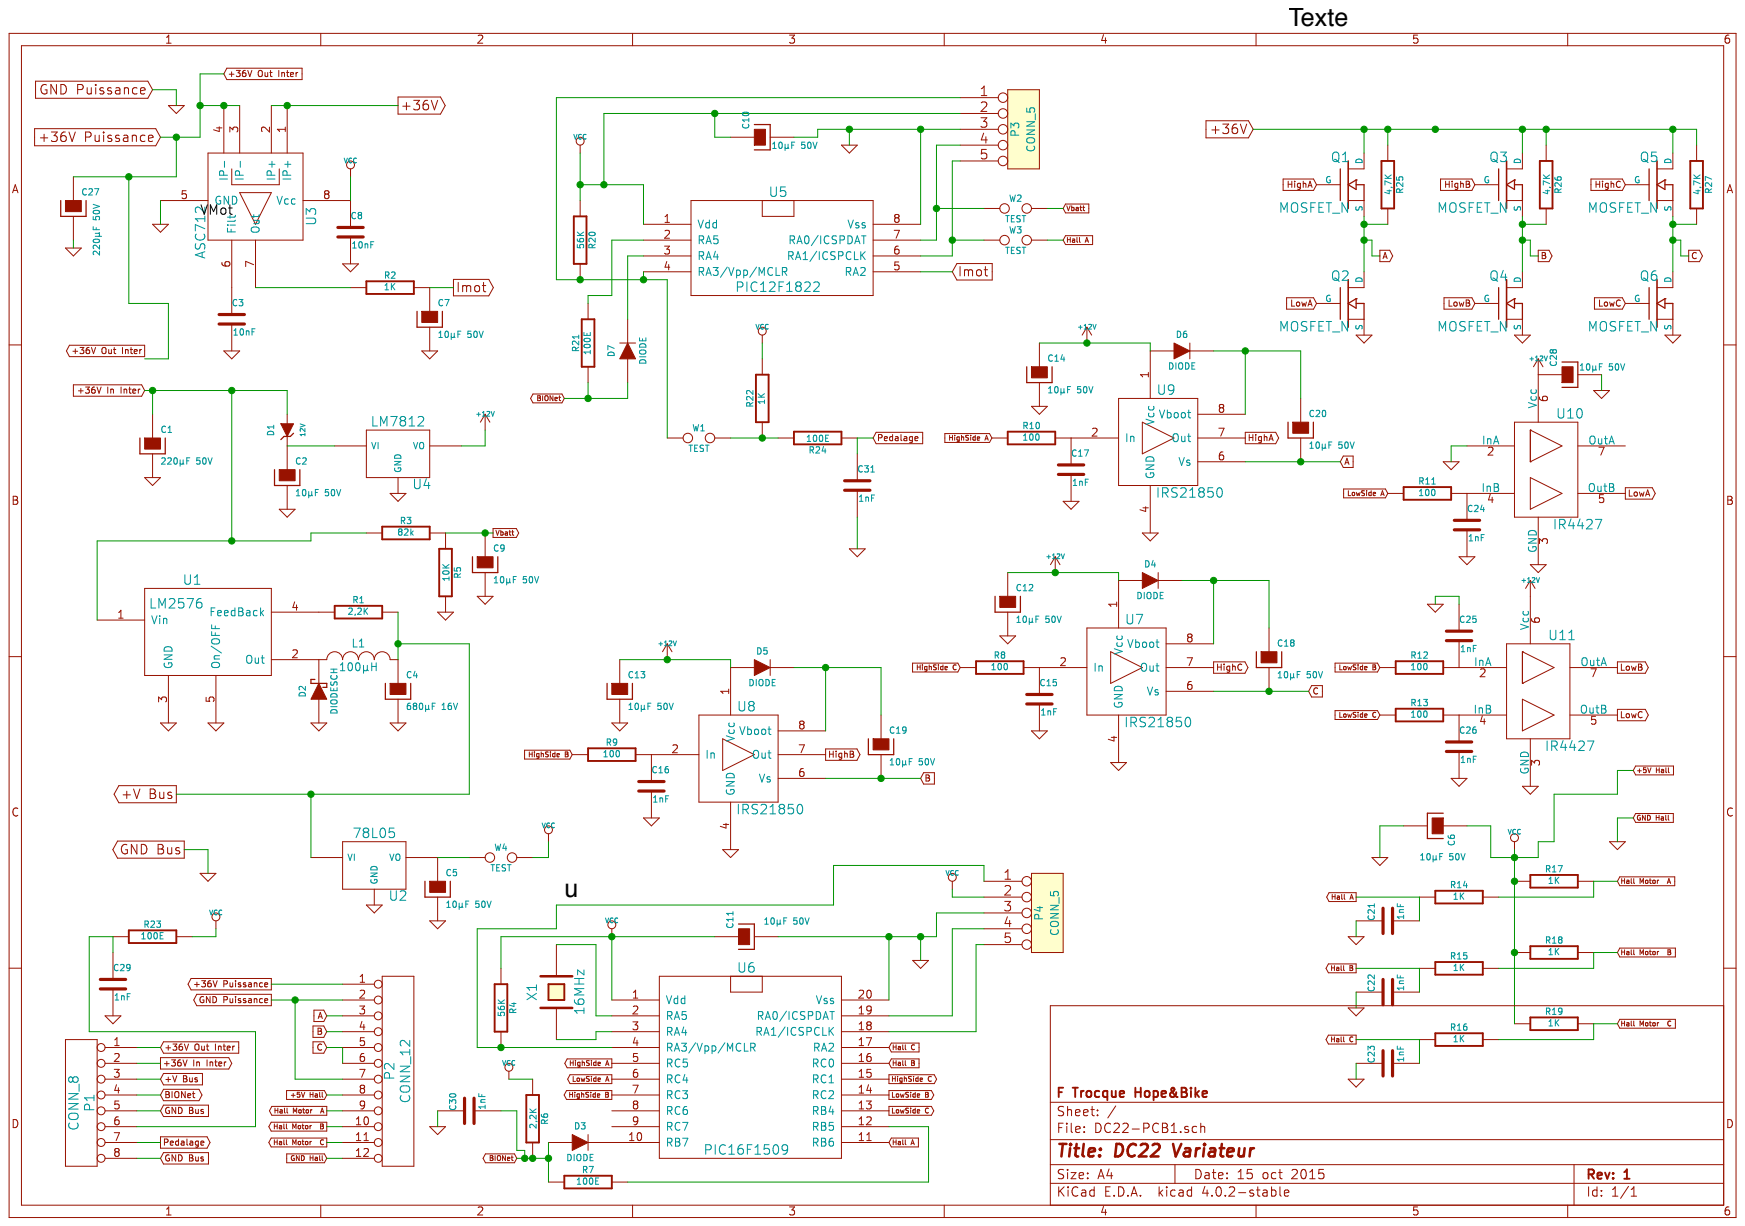
[picture p77: page 1]
