Le-Dome-RDS/hope-bike/electronic parts/command_board/hnb-display-brd.pdf

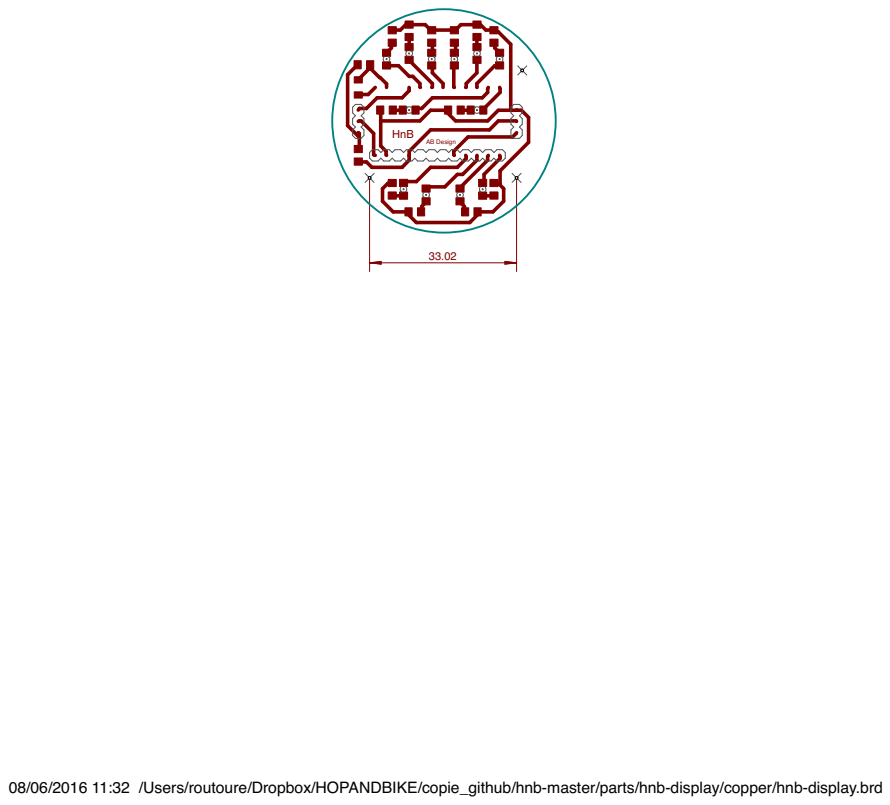
[picture p78: page 1]

08/06/2016 11:32 /Users/routoure/Dropbox/HOPANDBIKE/copie_github/hnb-master/parts/hnb-display/copper/hnb-display.brd
