Le-Dome-RDS/hope-bike/electronic parts/command_board/hnb-display-sch.pdf

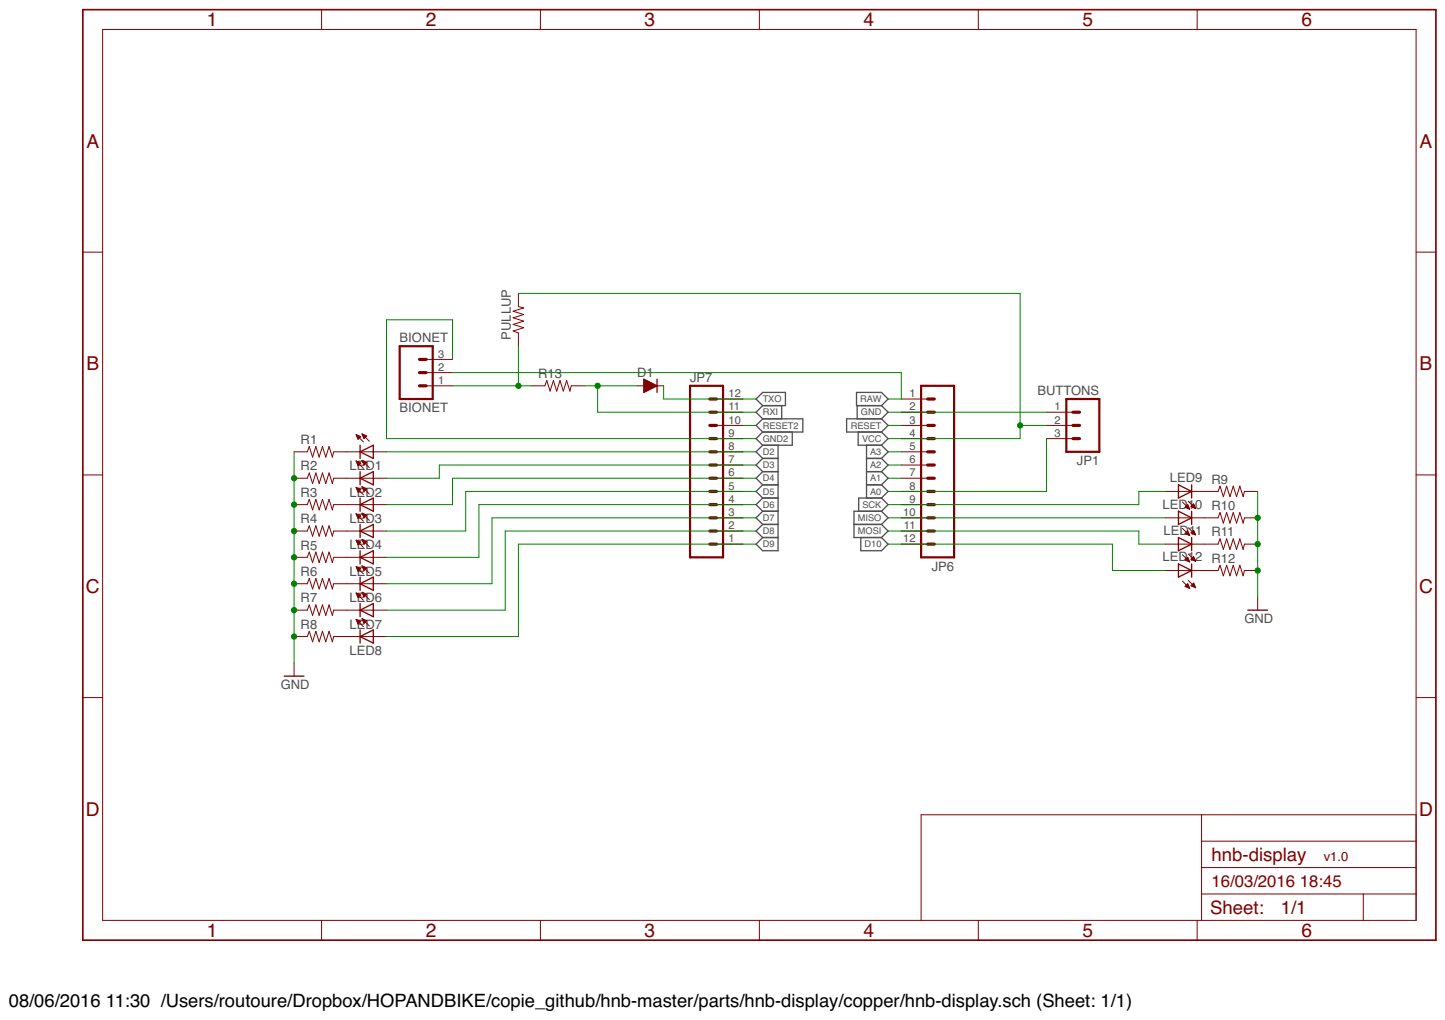
[picture p79: page 1]

08/06/2016 11:30 /Users/routoure/Dropbox/HOPANDBIKE/copie_github/hnb-master/parts/hnb-display/copper/hnb-display.sch (Sheet: 1/1)
