Le-Dome-RDS/hope-bike/electronic parts/power_management_board/hnb-puissance-pcb.pdf

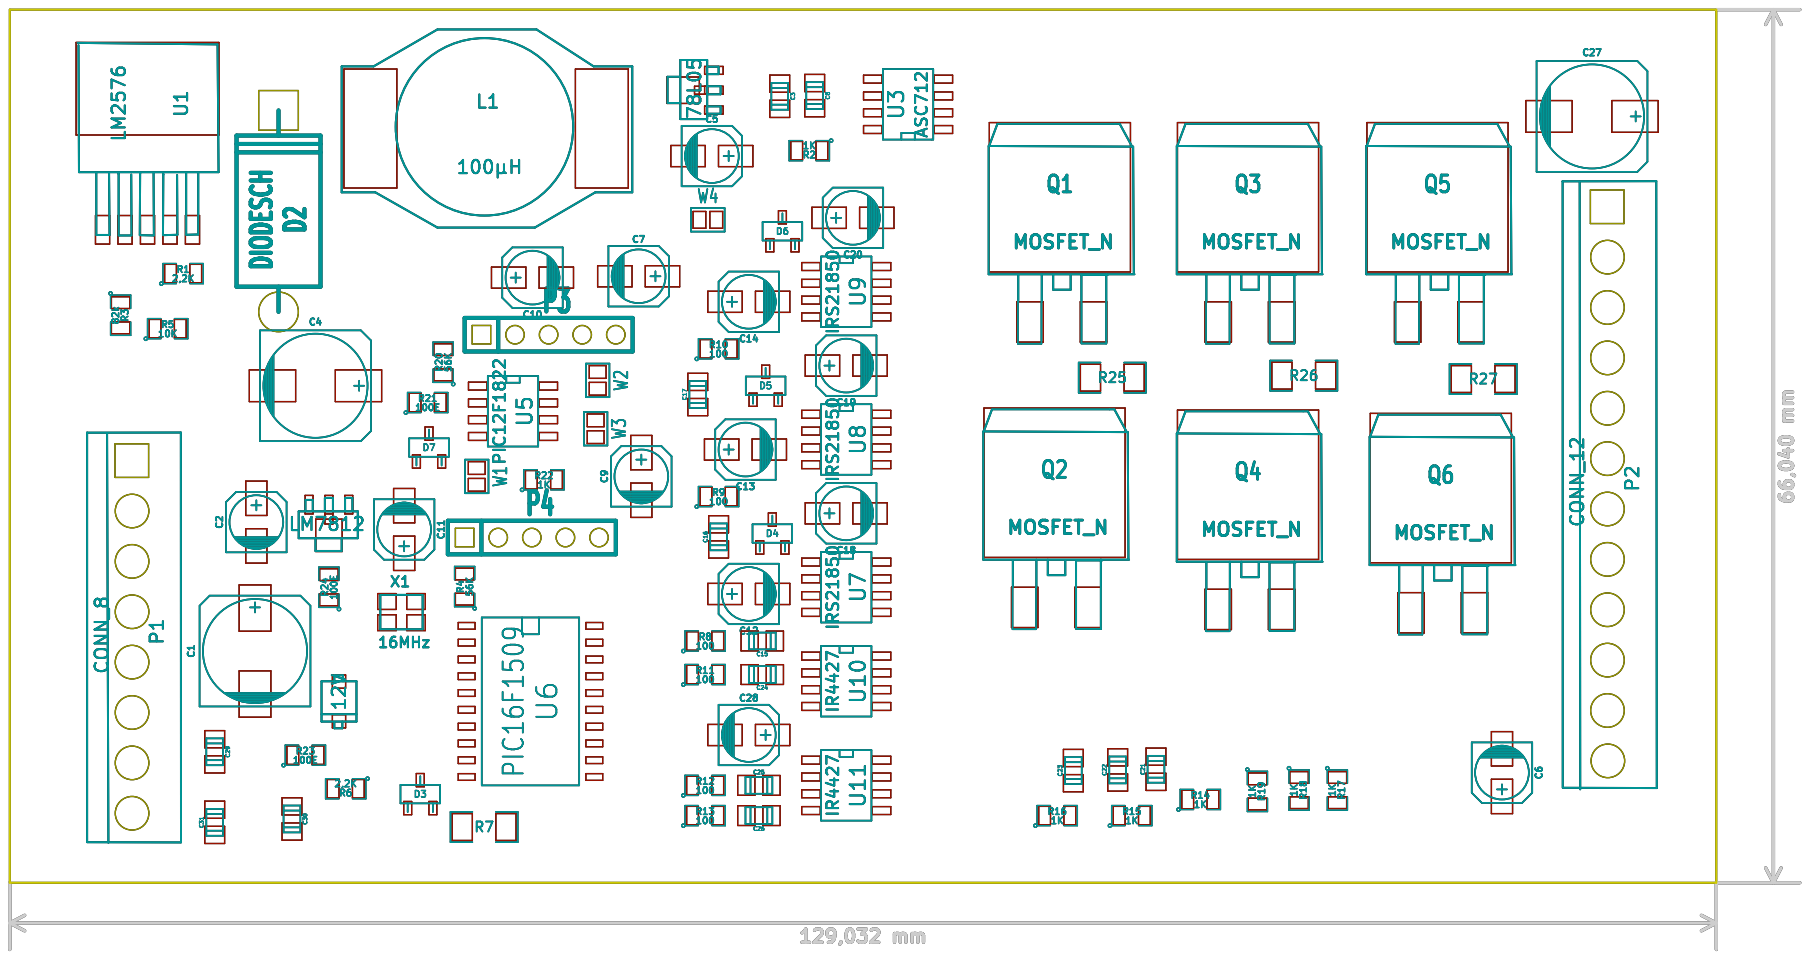
[picture p80: page 1]
