Le-Dome-RDS/hope-bike/electronic parts/power_management_board/DC22-PCB HW4-IE01/DC22-PCB1.kicad_pcb

## KiCad design electronic parts/power_management_board/DC22-PCB HW4-IE01/DC22-PCB1.kicad_pcb (2016-10-20)

Schematic: DC22-PCB1.sch, DC22 Variateur

Parts:
C1, C27: 220µF 50V
C2, C5, C6, C7, C9, C10, C11, C12, C13, C14, C18, C19, C20, C28: 10µF 50V
C3, C8: 10nF
C4: 680µF 16V
C15, C16, C17, C21, C22, C23, C24, C25, C26, C29, C30, C31: 1nF
D1: 12V
D2: DIODESCH
D3, D4, D5, D6, D7: DIODE
L1: 100µH
P1: CONN_8
P2: CONN_12
P3, P4: CONN_5
Q1, Q2, Q3, Q4, Q5, Q6: MOSFET_N
R1, R6: 2,2K
R2, R14, R15, R16, R17, R18, R19, R22: 1K
R3: 82k
R4, R20: 56K
R5: 10K
R7, R21, R23, R24: 100E
R8, R9, R10, R11, R12, R13: 100
R25, R26, R27: 4,7K
U1: LM2576
U2: 78L05
U3: ASC712
U4: LM7812
U5: PIC12F1822
U6: PIC16F1509
U7, U8, U9: IRS21850
U10, U11: IR4427
W1, W2, W3, W4: TEST
X1: 16MHz

Connections:
+5V Hall: C6.1, C8.1, C10.1, C11.1, P2.8, P3.2, P4.2, R4.1, R6.1, R17.1, R18.1, R19.1, R20.1, R22.2, R23.2, U3.8 (Vcc), U5.1 (Vdd), U6.1 (Vdd), W4.2
+12V: C12.1, C13.1, C14.1, C28.1, D4.1 (A), D5.1 (A), D6.1 (A), U4.VO, U7.1 (Vcc), U8.1 (Vcc), U9.1 (Vcc), U10.6 (Vcc), U11.6 (Vcc)
+36V: Q1.D, Q3.D, Q5.D, R25.1, R26.1, R27.1, U3.1 (IP+), U3.2 (IP+)
+36V In Inter: C1.1, D1.2, P1.2, R3.1, U1.1 (Vin)
+36V Out Inter: C27.1, P1.1, P2.1, U3.3 (IP-), U3.4 (IP-)
+V Bus: C4.1, L1.2, P1.3, R1.2, U2.VI
A: C20.2, P2.3, Q1.S, Q2.D, R25.2, U9.6 (Vs)
B: C19.2, P2.4, Q3.S, Q4.D, R26.2, U8.6 (Vs)
BIONet: C30.2, D3.1 (A), D7.1 (A), P1.4, R6.2, R7.1, R21.1
C: C18.2, P2.5, P2.6, Q5.S, Q6.D, R27.2, U7.6 (Vs)
GND Bus: C1.2, C2.2, C3.2, C4.2, C5.2, C6.2, C7.2, C8.2, C9.2, C10.2, C11.2, C12.2, C13.2, C14.2, C15.2, C16.2, C17.2, C21.1, C22.1, C23.1, C24.2, C25.1, C26.2, C27.2, C28.2, C29.2, C30.1, C31.2, D2.1 (A), P1.5, P1.8, P2.2, P2.7, P2.12, P3.3, P4.3, Q2.S, Q4.S, Q6.S, R5.2, U1.3 (GND), U1.5 (On/OFF), U2.GND, U3.5 (GND), U4.GND, U5.8 (Vss), U6.20 (Vss), U7.4 (GND), U8.4 (GND), U9.4 (GND), U10.2 (InA), U10.3 (GND), U11.3 (GND)
Hall A: C21.2, R14.1, U6.11 (RB6), W3.2
Hall B: C22.2, R15.1, U6.16 (RC0)
Hall C: C23.2, R16.1, U6.17 (RA2)
Hall Motor A: P2.9, R14.2, R17.2
Hall Motor B: P2.10, R15.2, R18.2
Hall Motor C: P2.11, R16.2, R19.2
HighA: Q1.G, U9.7 (Out)
HighB: Q3.G, U8.7 (Out)
HighC: Q5.G, U7.7 (Out)
HighSide A: R10.1, U6.5 (RC5)
HighSide B: R9.1, U6.7 (RC3)
HighSide C: R8.1, U6.15 (RC1)
Imot: C7.1, R2.2, U5.5 (RA2)
LowA: Q2.G, U10.5 (OutB)
LowB: Q4.G, U11.7 (OutA)
LowC: Q6.G, U11.5 (OutB)
LowSide A: R11.1, U6.6 (RC4)
LowSide B: R12.1, U6.14 (RC2)
LowSide C: R13.1, U6.13 (RB4)
unnamed: P4.4, U6.19 (RA0/ICSPDAT)
unnamed: P4.5, U6.18 (RA1/ICSPCLK)
unnamed: R2.1, U3.7 (Out)
unnamed: D7.2 (K), U5.3 (RA4)
unnamed: C25.2, R12.2, U11.2 (InA)
unnamed: C26.1, R13.2, U11.4 (InB)
unnamed: R22.1, R24.2, W1.2
unnamed: C5.1, U2.VO, W4.1
unnamed: C29.1, P1.6, R23.1
unnamed: P3.1, R20.2, U5.4 (RA3/Vpp/MCLR), W1.1
unnamed: P3.5, U5.6 (RA1/ICSPCLK), W3.1
unnamed: P3.4, U5.7 (RA0/ICSPDAT), W2.1
unnamed: R21.2, U5.2 (RA5)
unnamed: D2.2 (K), L1.1, U1.2 (Out)
unnamed: R1.1, U1.4 (FeedBack)
unnamed: P4.1, R4.2, U6.4 (RA3/Vpp/MCLR)
unnamed: U6.2 (RA5), X1.2
unnamed: D3.2 (K), U6.10 (RB7)
unnamed: R7.2, U6.12 (RB5)
unnamed: C24.1, R11.2, U10.4 (InB)
unnamed: C17.1, R10.2, U9.2 (In)
unnamed: C20.1, D6.2 (K), U9.8 (Vboot)
unnamed: C3.1, U3.6 (Filt)
unnamed: U6.3 (RA4), X1.1
unnamed: C2.1, D1.1, U4.VI
unnamed: C15.1, R8.2, U7.2 (In)
unnamed: C18.1, D4.2 (K), U7.8 (Vboot)
unnamed: C19.1, D5.2 (K), U8.8 (Vboot)
unnamed: C16.1, R9.2, U8.2 (In)
Pedalage: C31.1, P1.7, R24.1
Vbatt: C9.1, R3.2, R5.1, W2.2

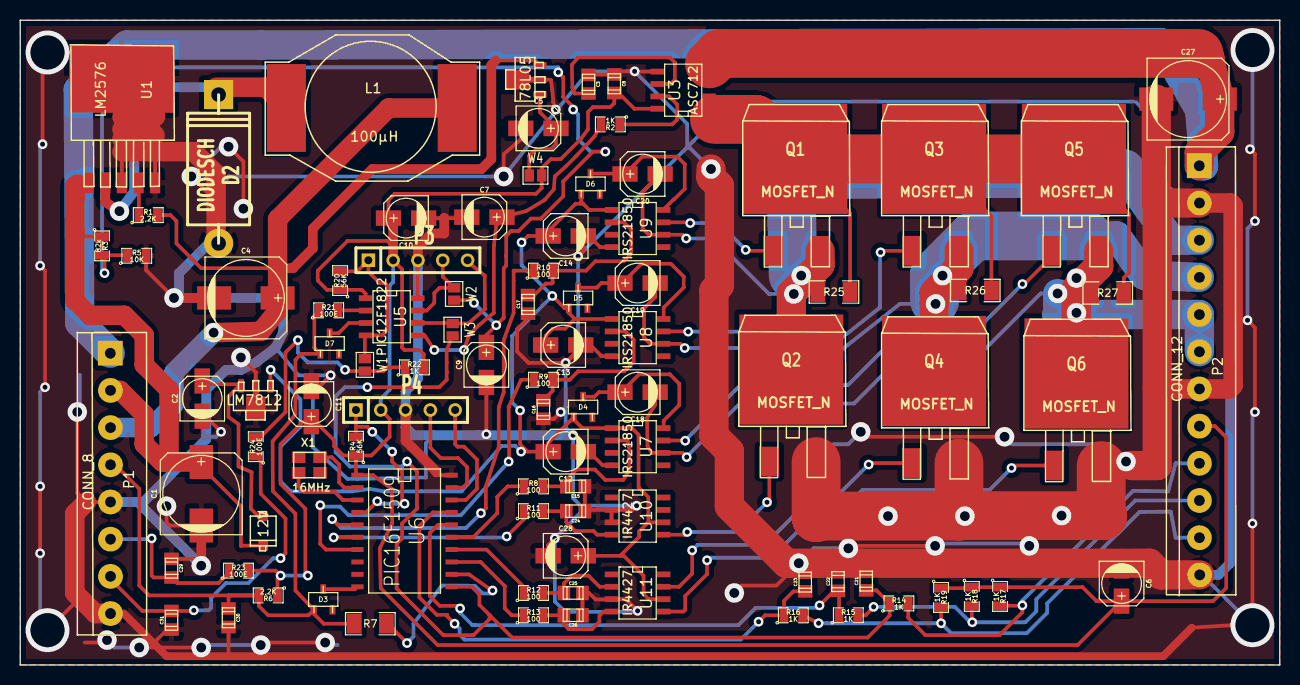
[picture p81: board DC22-PCB1.kicad_pcb from above]

Board: 2 copper layers, 129.0 x 66.0 mm, 92 parts (0 on the bottom side), 61 nets.
