Le-Dome-RDS/hope-bike/electronic parts/button_board/hnb-switches.brd

## EAGLE design electronic parts/button_board/hnb-switches.brd (2016-10-20)

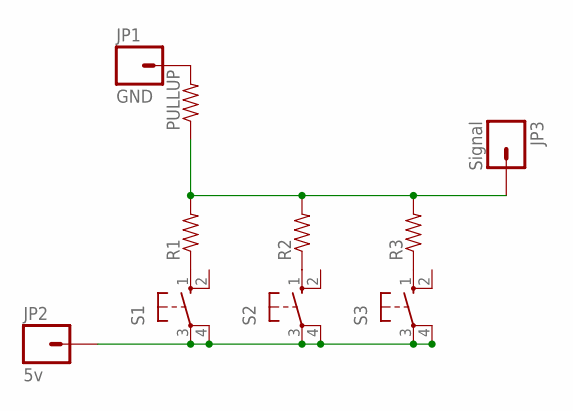
[picture p82: schematic hnb-switches.sch]

Parts:
JP1: GND; 1X01_LONGPAD
JP2: 5v; 1X01_LONGPAD
JP3: Signal; 1X01_LONGPAD
PULLUP: RESISTOR1206; 1206
R1, R2, R3: RESISTOR1206; 1206
S1, S2, S3: 10-XX; B3F-10XX

Connections:
unnamed: JP1.1, PULLUP.2
unnamed: R1.1, S1.1 (S)
unnamed: R2.1, S2.1 (S)
unnamed: R3.1, S3.1 (S)
unnamed: JP3.1, PULLUP.1, R1.2, R2.2, R3.2
unnamed: JP2.1, S1.3, S1.4 (P1), S2.3, S2.4 (P1), S3.3, S3.4 (P1)

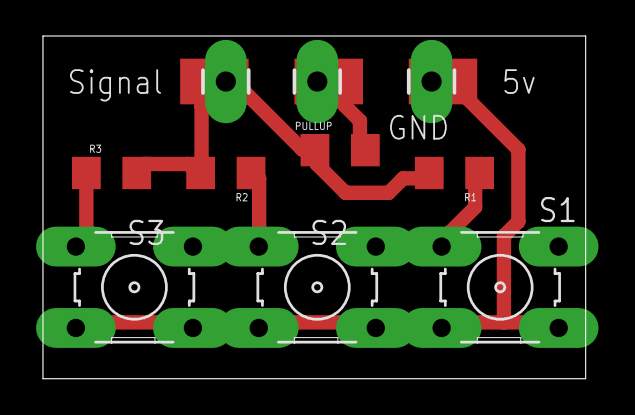
[picture p83: board hnb-switches.brd from above]

Board: 2 copper layers, 30.2 x 19.0 mm, 10 parts (0 on the bottom side), 6 nets.
