Le-Dome-RDS/hope-bike/electronic parts/command_board/hnb-display.brd

## EAGLE design electronic parts/command_board/hnb-display.brd (2016-10-20)

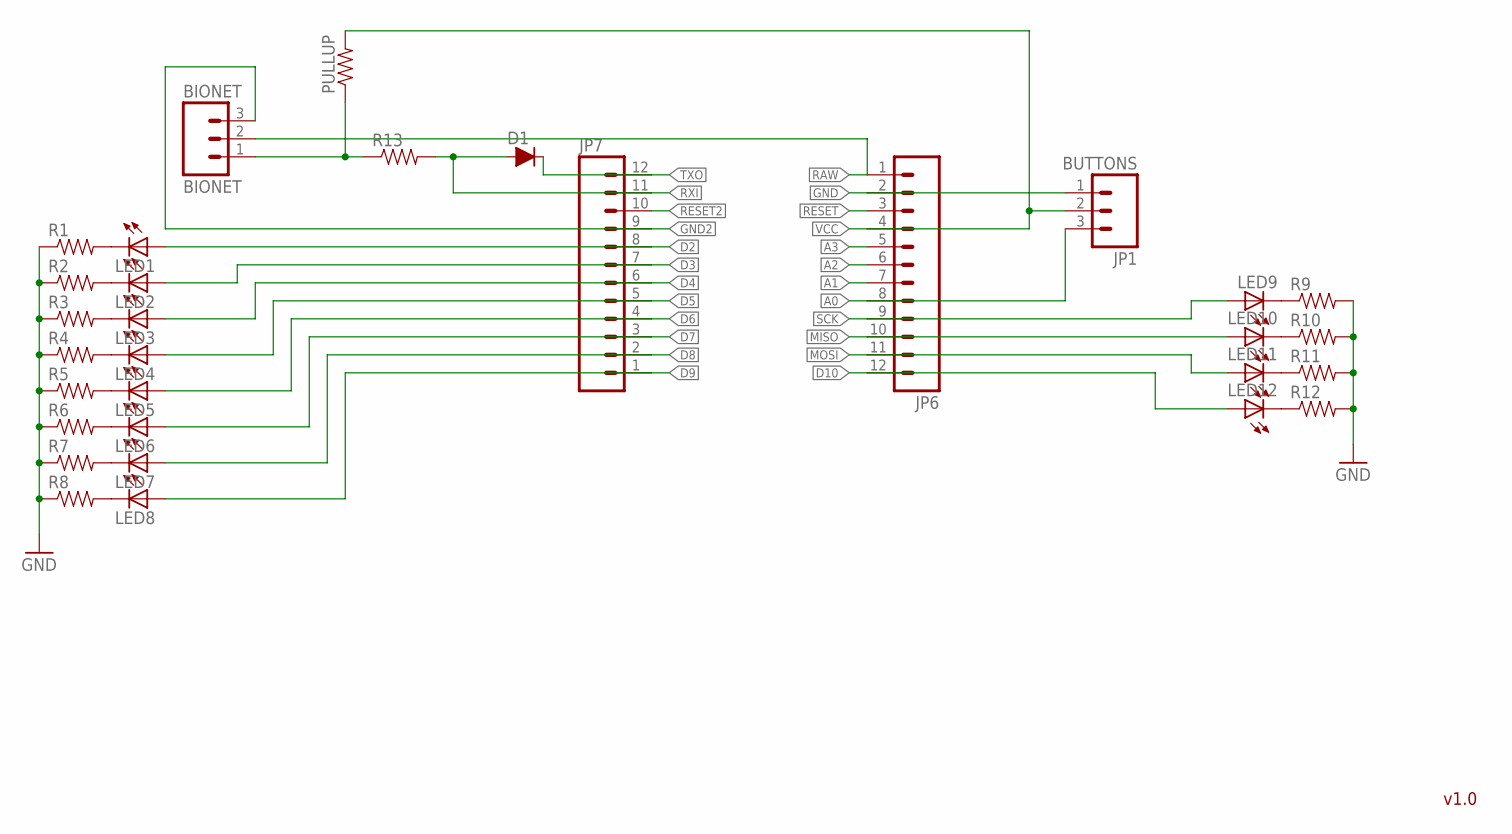
[picture p84: schematic hnb-display.sch]

Parts:
BIONET: BIONET; 1X03
D1: D-FILL-SOD-80; SOD80
JP1: BUTTONS; 1X03
JP6, JP7: M12PTH; 1X12
LED1, LED2, LED3, LED4, LED5, LED6, LED7, LED8, LED9, LED10, LED11, LED12: LEDSMT1206; 1206
PULLUP: RESISTOR1206; 1206
R1, R2, R3, R4, R5, R6, R7, R8, R9, R10, R11, R12, R13: RESISTOR1206; 1206

Connections:
A0: JP1.3, JP6.8
A1: JP6.7
A2: JP6.6
A3: JP6.5
D2: JP7.8, LED1.A
D3: JP7.7, LED2.A
D4: JP7.6, LED3.A
D5: JP7.5, LED4.A
D6: JP7.4, LED5.A
D7: JP7.3, LED6.A
D8: JP7.2, LED7.A
D9: JP7.1, LED8.A
D10: JP6.12, LED12.A
GND: JP1.1, JP6.2, R1.1, R2.1, R3.1, R4.1, R5.1, R6.1, R7.1, R8.1, R9.2, R10.2, R11.2, R12.2
GND2: BIONET.3, JP7.9
MISO: JP6.10, LED10.A
MOSI: JP6.11, LED11.A
unnamed: LED1.C, R1.2
unnamed: LED2.C, R2.2
unnamed: LED3.C, R3.2
unnamed: LED4.C, R4.2
unnamed: LED5.C, R5.2
unnamed: LED6.C, R6.2
unnamed: LED7.C, R7.2
unnamed: LED8.C, R8.2
unnamed: LED12.C, R12.1
unnamed: LED10.C, R10.1
unnamed: LED11.C, R11.1
unnamed: LED9.C, R9.1
unnamed: BIONET.1, PULLUP.1, R13.1
RAW: BIONET.2, JP6.1
RESET: JP6.3
RESET2: JP7.10
RXI: D1.2 (A), JP7.11, R13.2
SCK: JP6.9, LED9.A
TXO: D1.1 (C), JP7.12
VCC: JP1.2, JP6.4, PULLUP.2

Notes on the sheet:
v1.0

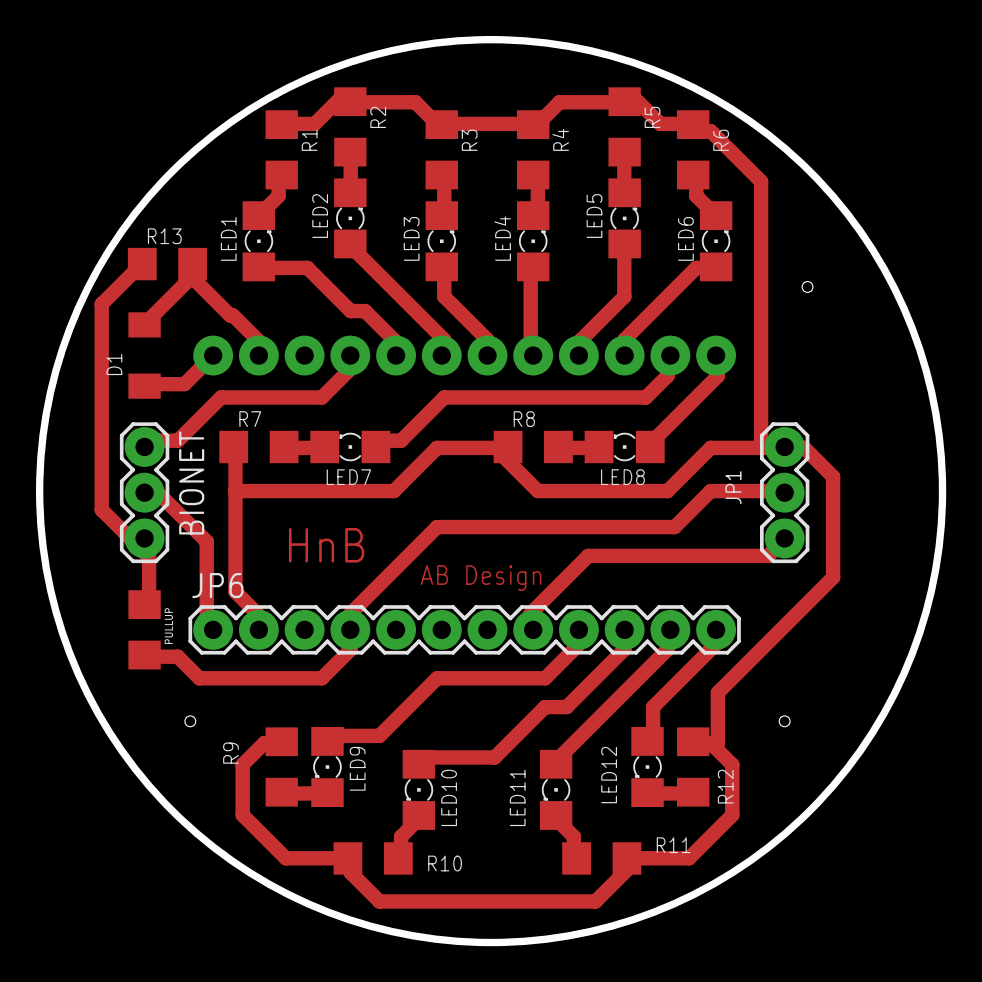
[picture p85: board hnb-display.brd from above]

Board: 2 copper layers, 50.2 x 50.2 mm, 32 parts (1 on the bottom side), 32 nets.

Other parts of the board:
U$1: A5L-LOC
