Le-Dome-RDS/hope-bike/source_code/power_management_card/Pic12F/DC22M_Main.h

/* 
 * File:   DC24_Main.h
 * Author: francois
 *
 * Created on 27 novembre 2014, 18:44
 */

#ifndef DC24_MAIN_H
#define	DC24_MAIN_H

void DC24It10ms(void);

#ifdef	__cplusplus
extern "C" {
#endif



#ifdef	__cplusplus
}
#endif

#endif	/* DC24_MAIN_H */
