Le-Dome-RDS/hope-bike/source_code/command_card/hnb_drive_v2/the_serial_debug.ino

void serialDebug() {
  
  Serial.print(" u8Etat: ");
  Serial.print(u8Etat);

  Serial.print(" u16capteurRoue: ");
  Serial.print(u16adcRoueMaintenant);
  
  Serial.print(" i16PWM: ");
  Serial.print(i16PWM);
  Serial.print(" Consigne : ");
  Serial.print(u16Consigne);
  
  Serial.print(" u16Vitesse:");
  Serial.println(u16Vitesse);
  
  //Serial.print(" i16Courant:");
  //Serial.print(i16Courant);
  
  //Serial.print(" u16Pedalier:");
  //Serial.print(u16Pedalier);

  

  //Serial.print(" u16adcRoueMaintenant:");
  //Serial.print(u16adcRoueMaintenant);

  //Serial.print(" TempsFront:");
  //Serial.print(millis()-tempsFront);

  //for (long i=0;i<15;i++) {Serial.print(" ");Serial.print(String(u16adcRoue[i])  )  ; }


  //Serial.print(" u16Batterie:");
  //Serial.println(u16Batterie);
  
  
}
