Le-Dome-RDS/hope-bike/source_code/power_management_card/DC22_Var_Pic16.X/Pic16F_Control/Interrupt.c

/*
 * File:   Hdw_Uart.c
    Copyright (C) 2015-2016  François Trocque
    
    This file is part of HnB_Controller project.

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
    You should have received a copy of the GNU General Public License
    along with HnB_Controller.  If not, see <http://www.gnu.org/licenses/>. 2
*/

#include <stdio.h>
#include <stdlib.h>
#include <xc.h>
#include "Type.h"
#include "Bio-Net.h"
#include "DC22_Main.h"

void interrupt isr(void)
{
    // manage Timer 0 each 250µs it is why it is in first place to be faster
    if (TMR0IF & TMR0IE)
    {
        // Timer 0 overflow every 1ms +2%
        TMR0IF = 0;

        // manage No Rx delay
        if (u8RxNoDelay!=0)
        {
            // we decrease u8RxNoDelay down to 0
            u8RxNoDelay--;
        }
        else
        {
            // u8RxNoDelay has reach 0 so 1 up to 1,25ms has elapsed whitout receiving any char
            // we reset all bionet flag but only one time
            if (bRazFlagAllowed)
            {
                BioNetRazFlag();
                bRazFlagAllowed=FALSE;
            }
        }
        //**** end manage No Rx delay

        // manage 1ms
        u8Prescaler10ms++;

        if (u8Prescaler10ms==VARCYCLE)
        {
            u8Prescaler10ms=0;

            DC22It10ms();

            if (OERR) //RX Overrun
            {
                // Reset overrun
                CREN=0;
                CREN=1;
            }
        }

    }
    // is this a RX interrupt
    else if (RCIF & RCIE)
    {
        RCIF=0;
        BioNetRxInt();
    }
    // is this a TX interrupt
    else if (TXIF & TXIE)
    {
        // needs to be put at the end because the flag is always activated
        // but generates interrupt only if TXIE is activated
        // but if put above, the interrupt generated by the following statement
        // will be never served and TX will be served instead
        //TXIF=0;
        BioNetTxInt();
    }

}
