Le-Dome-RDS/hope-bike/source_code/power_management_card/Pic12F/DC22M_Ana.h

/* 
 * File:   DC22_Ana.h
 * Author: francois
 *
 * Created on 30 avril 2015, 19:44
 */

#ifndef DC22_ANA_H
#define	DC22_ANA_H

#ifdef	__cplusplus
extern "C" {
#endif


void DC22_AnaProcess(void);


#ifdef	__cplusplus
}
#endif

#endif	/* DC22_ANA_H */
