Le-Dome-RDS/hope-bike/source_code/power_management_card/Pic12F/DC22M_Hdw.h

/* 
 * File:   DC24_Hdw.h
 * Author: francois
 *
 * Created on 3 novembre 2014, 21:08
 */

#ifndef DC24_HDW_H
#define	DC24_HDW_H

#ifdef	__cplusplus
extern "C" {
#endif

void DC24HdwInit(void);



#ifdef	__cplusplus
}
#endif

#endif	/* DC24_HDW_H */
