Le-Dome-RDS/hope-bike/source_code/power_management_card/Pic12F/DC22M_Pedalage.h

/* 
 * File:   DC22_Pedalage.h
 * Author: francois
 *
 * Created on 19 mai 2015, 08:35
 */

#ifndef DC22_PEDALAGE_H
#define	DC22_PEDALAGE_H

void DC22_PedalageProcess(u8 *pu8Pedalage);

#ifdef	__cplusplus
extern "C" {
#endif




#ifdef	__cplusplus
}
#endif

#endif	/* DC22_PEDALAGE_H */
