Le-Dome-RDS/hope-bike/source_code/power_management_card/Pic12F/Hdw_Uart.h

/* 
 * File:   Hdw_Uart.h
 * Author: francois
 *
 * Created on 31 octobre 2014, 18:22
 */

#ifndef HDW_UART_H
#define	HDW_UART_H

#ifdef	__cplusplus
extern "C" {
#endif



    void HdwUartInit (void);



#ifdef	__cplusplus
}
#endif

#endif	/* HDW_UART_H */
