Le-Dome-RDS/hope-bike/(commit log)

2016-10-20 First commit with JMR
    Data sheet and other documentations
    [2015_06_08Liste Composants Francois_Auguste.ods, DC22-PCB1.kicad_pcb, DC22-PCB1.sch, IRF MosFET N.xls, IRF MosFET P.xls, PIC16 MCU-2014-10-12.ods, hnb-display.brd, hnb-display.sch]
2017-01-19 source code for the command card and the power management card
    [Pic12F.production.obj, l.obj]
2017-01-19 pdf...
    pdf files for the schematic and the pcb of the different electronic card
2017-01-19 update docs
    [DC22-PCB1.kicad_pcb, DC22-PCB1.sch, Pic12F.production.obj, cable_pass_A.dxf, cable_pass_B.dxf, hnb-display.brd, hnb-display.sch, hnb-switches.brd]
2017-01-19 BOM renaming
    [2015.06.08_BOM_Francois_Auguste.ods]
2017-01-19 BOM fastenings
2017-03-15 documentation update
    Mainly document update to programm the boards
2017-03-15 Mise à jour code carte commande
    Mise à jour de la machine d'état pour une gestion plus fine des
    dépassements du courant MAX
2017-03-17 Documentation update
    User manuel
    diy manual
    certificate
    [Pic12F.production.obj]
2020-02-03 Ajout des variables globales
2020-02-24 Integration of the command lines for the v2 electronic device
2020-03-02 still one bug to solve
    [hnb_display.ino, hnb_drive_v2.ino, hnb_global_var.ino, hnb_i2c.ino, hnb_keyboard.ino, hnb_power.ino, the_serial_debug.ino]
2021-03-03 2021 update : new state to slow down quietly the motor, button update
2021-03-04 2021 03 04 update : median filter for the measurements of the bike speed
2021-03-22 2021 03 22 : motor stop detection. Modulation of the deltaPWM with the current
2021-03-24 2021 03 25 : better motor stop detection and more precise PWM moduluation ; screen ajustement ; special keyboard option update
2021-04-13 version 1.99. La version 2.0 est presque, mais alors presque, terminée. Et Yohoho et une bouteille de rhum.
2021-04-14 integration des plans openscad
    [HNB_puissance_guidon.scad]
2021-04-15 integration des plans pour le capteur de hall de la roue
    [magnet2.stl, sensor_holder_JM_v1.scad, sensorholder_JM.stl]
2021-04-15 Optimisation des boitiers
    [HNB_puissance_guidon.scad]
2021-04-15 Optimisation des boitiers, suite
    [HNB_puissance_guidon.scad]
