Le-Dome-RDS/hope-bike/(notices)

Notices in the files:
source_code/power_management_card/DC22_Var_Pic16.X/Pic16F_Control/DC22_Motor.c:
HnB_Controller is free software: you can redistribute it and/or modify
it under the terms of the GNU General Public License as published by
the Free Software Foundation, either version 3 of the License, or
(at your option) any later version.
parts and their libraries:
SparkFun-Passives: Licensing: Creative Commons ShareAlike 4.0 International - https://creativecommons.org/licenses/by-sa/4.0
